CircuitBreaker437/HCS12_Robot/Doc/Project Functional Specification/Jan16/Project Functional Specification_Rev1_2015-01-16_MarcinCzajkowski.docx

Document Title Project Functional Specification

Revision 1

Date Issued January 16, 2015

Date Effective January 16, 2015

Department School of Engineering and Information Technology

Program Electronic Systems Engineering

Audience ESE Semester 4 Faculty

Author Marcin Czajkowski, Student

Reviewers Mike Jarabek, Professor

Peter Roeser, Professor

Bill Stefanuk, Professor

Revision History

Revision | Description of Change | Effective Date
1 | New Document Release | Jan. 16, 2015

# 1. Introduction:

As part of the semester for year 2 for studies in Electronic Systems Engineering it is required to implement a project that will give students the opportunity to study and apply design principles for the creation of embedded systems hardware and software.

Additional tasks that a student will be learning through implementation of the project are:

- Populate and test PCB boards
- Design and simulate test diagnostic systems
- Use schematic capture as well as read specification of parts/systems vendors
- Create PCB manufacturing data
- Create a detailed documentation regarding project specifications and scheduling of the project

# 2. Scope of the Document:

The scope of the Project Functional Specification document is to present hardware specifications needed to implement the HCS12 embedded PCB. This document will be subjected to numerous revisions as the project progresses and the aspects of the project are added through the semester. This document shall include:

- List of related documents supporting the project
- Cost targets of the components and services needed to finish the project
- Configuration options of the embedded system
- Detailed specification such as:
  - Performance
  - Port usage
  - Communication options
  - External cabling details
  - Physical size and physical constraints
  - Power requirements
- Regulatory requirements
- Reliability and service

# 3. Chapter I – List of Related Documents

## 3.1. Purpose:

The purpose of this chapter is to attach documentation related to the project. The documentation will be attached as links. Some documents might require special access permissions to be viewed. Contact document author if issues persist.

Author: Marcin Czajkowski

Email: mczajkowski@conestogac.on.ca

## 3.2. Documents list:

# | Document tile | Revision | Document purpose | Link

1 | LM22675 Specs | L | To present specifications of LM22675 | link (http://www.ti.com/product/lm22675)
2 | Project Charter | 2.7 | To present project IV requirements | link (https://conestoga.desire2learn.com/d2l/le/content/70973/viewContent/1442104/View)
3 | Notes For Design Verification | 5.0 | MCU pin specifications | link (https://conestoga.desire2learn.com/d2l/le/content/70973/viewContent/1442121/View)
4 | Port Mapping | 6 | Port mapping and pin outs of the MCU | link (https://conestoga.desire2learn.com/d2l/le/content/70973/viewContent/1442116/View)
5 | PCB tolerances and design requirements | N/A | PCB design and tolerances | link (https://conestoga.desire2learn.com/d2l/le/content/70973/viewContent/1442114/View)
6 | DC motor encoder connections | N/A | Pin out of the DC motor connector | link (https://conestoga.desire2learn.com/d2l/le/content/70973/viewContent/1442115/View)
7 | Board outline | 8 | PCB outline and connector placements | link (https://conestoga.desire2learn.com/d2l/le/content/70973/viewContent/1442117/View)
8 | Camera conx pinout | 2 | Camera connection pin out | link (https://conestoga.desire2learn.com/d2l/le/content/70973/viewContent/1442118/View)
9 | Motor encoder | N/A | Motor speed feedback diagram | link (https://conestoga.desire2learn.com/d2l/le/content/70973/viewContent/1442120/View)
10 | MAX3232 | 7 | MAX3232 Data Sheet | link (http://datasheets.maximintegrated.com/en/ds/MAX3222-MAX3241.pdf)
11 | Altium Resource/Documentation | N/A | Webpage for Altium Designer support | link (http://techdocs.altium.com/)
12 | Absolute Maximum Ratings for Soldering SNOA549C | N/A | Soldering ratings for National Semiconductors | link (http://www.ti.com/lit/an/snoa549c/snoa549c.pdf)

# 4. Chapter II – Cost Target

## 4.1. Purpose:

The purpose of the Cost Target chapter is to track the expenses of the parts and services required to finish the project. This chapter will keep an updated BOM as well as any quotes obtained from the vendors.

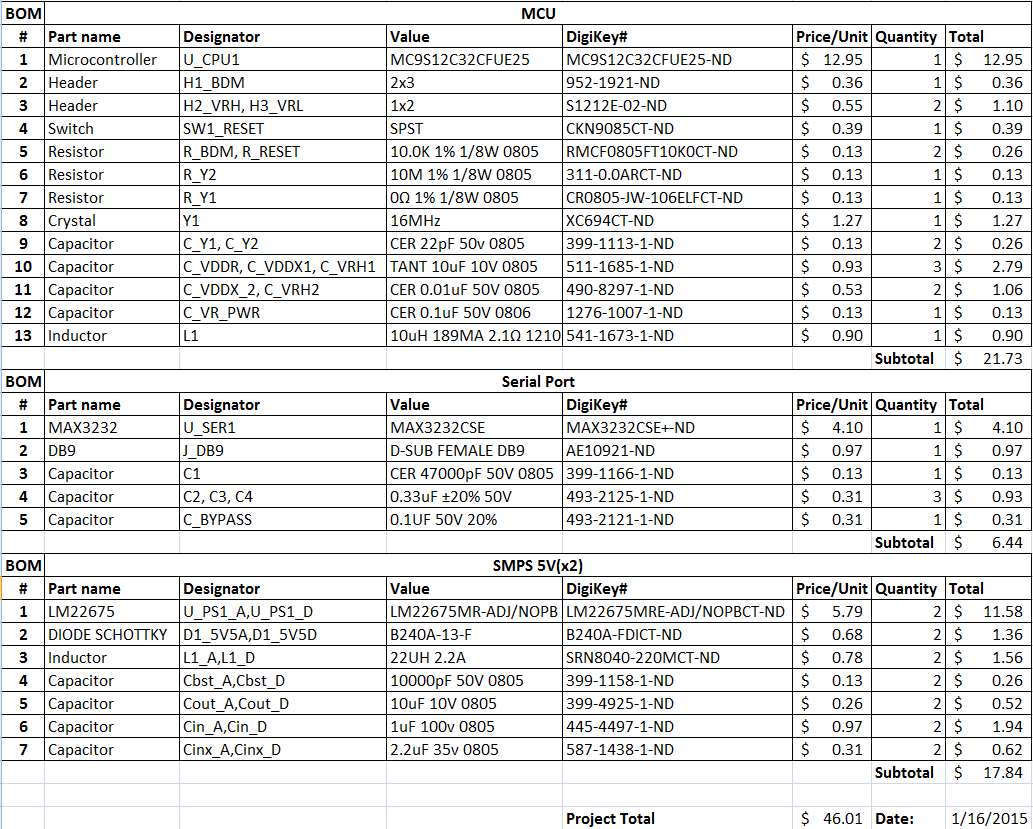
[picture p14: figure]

## 4.2. BOM

## 4.3. Total cost target

Currently the cost target of the finished product is approximately $200. The above estimate presents only the current known parts that must be acquired.

# 5. Chapter III - Specifications and Performance

## 5.1. Purpose:

The purpose of this chapter is to present detailed hardware and software specifications regarding configurations, ports usage, cabling details and system communications.

## 5.2. Hardware Specifications:

### Ports:

- RS232

The serial communication between the MCU and the peripherals will be implemented through MAX3232 IC. The MAX IC will be connected to Port S on MCU (refer to document 4 in 3.2 Documents List for pin out of Port S on MCU)

- BDM connector will be used for programming of the embedded system
- MCU port T will be used for stepper motor coil RC Servo and Encoder. Port P will serve as PWM module (refer to document 4 in 3.2 Documents List for MCU port pin outs)
- Port A on the MCU will serve as LCD connection (refer to document 4 in 3.2 Documents List for MCU port pin outs)
- Other ports TBD

### Communication and cabling:

- TBD

### Hardware configuration:

- TBD

### Physical Constraints:

- Refer to refer to document 5 and 7 in 3.2 Documents List for the board physical constraints and layout options. Further details TBD
- Constraints regarding component placement – TBD

### PCB Design

- MCU connections

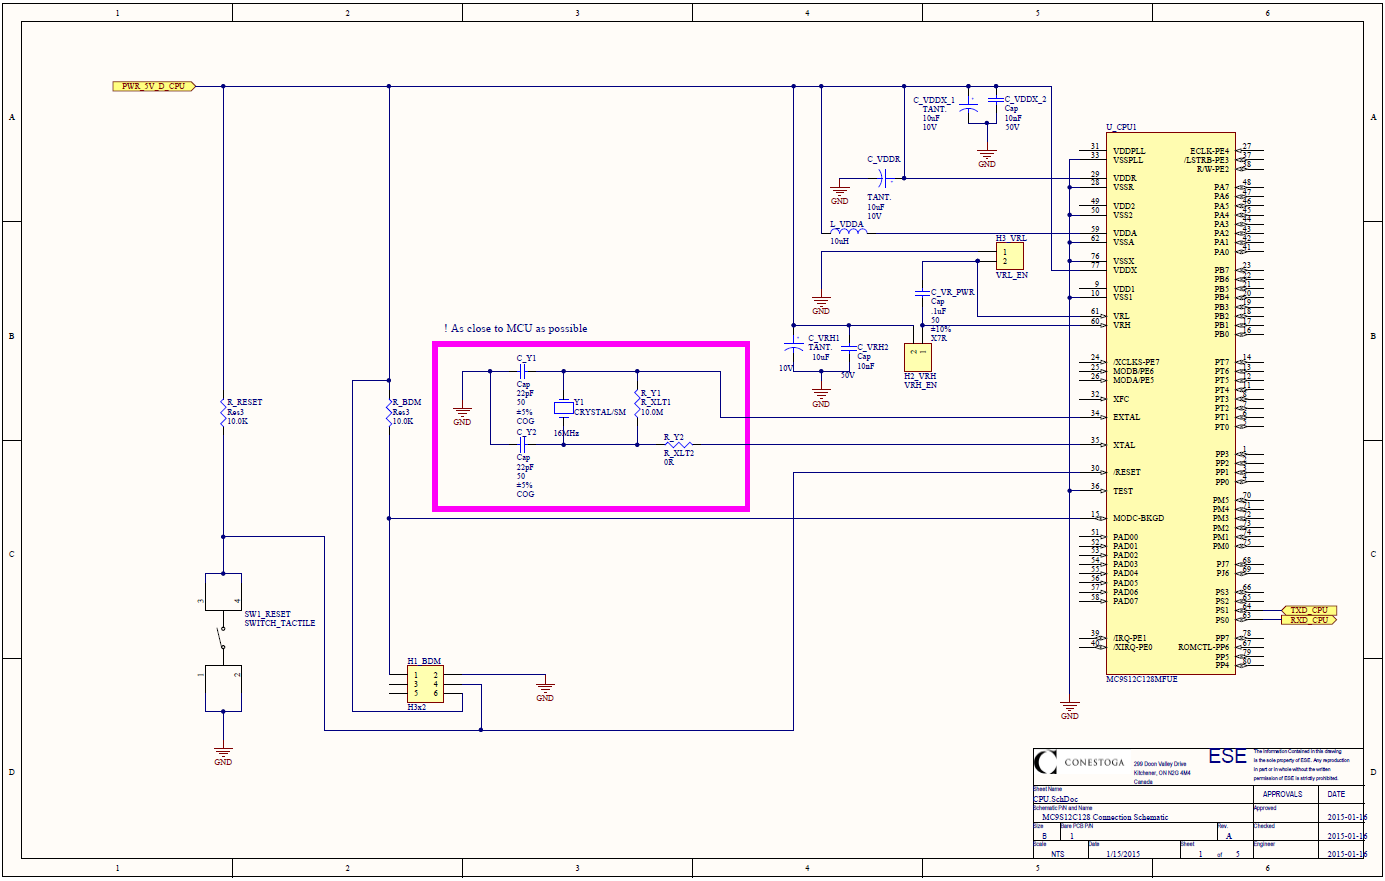
[picture p15: figure]

- SMPS 5V power supply
- RS3232 connections


- Hierarchical design

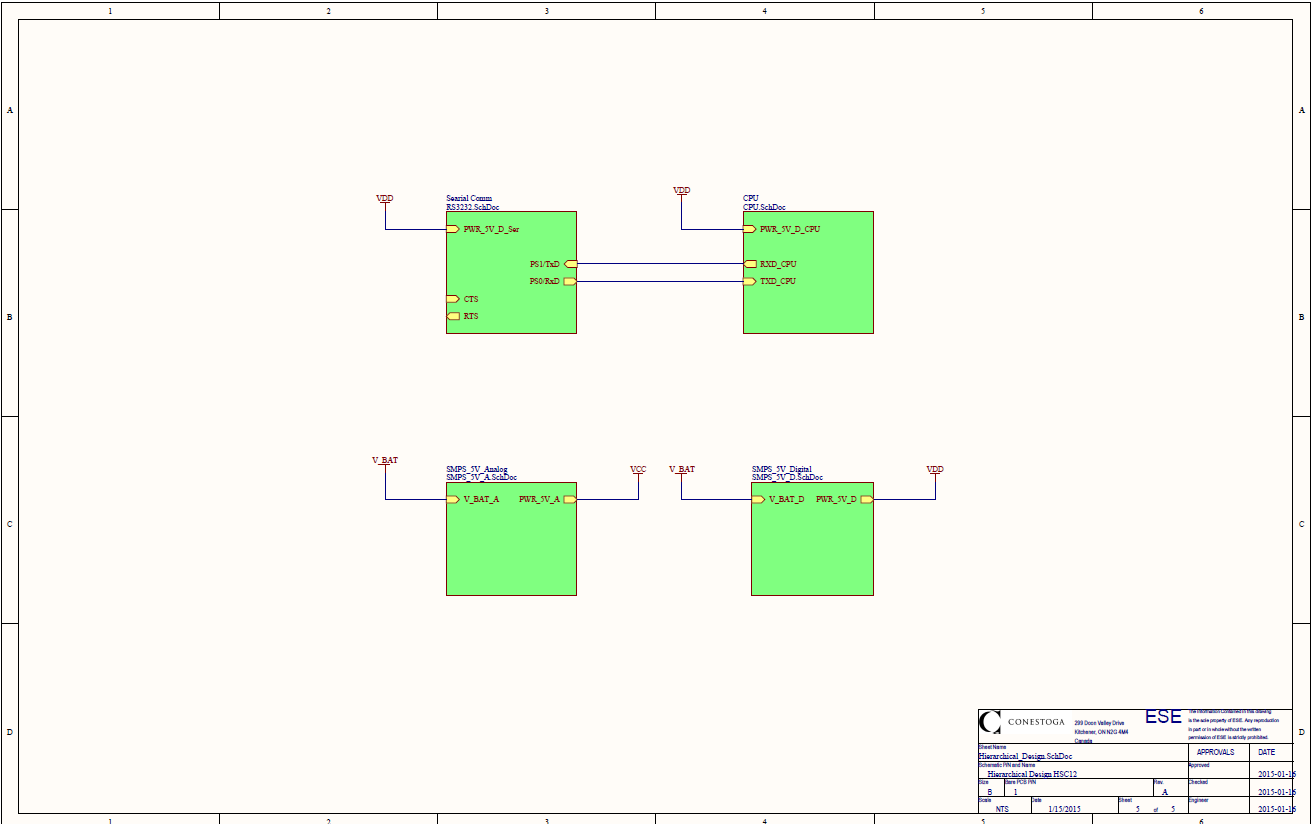
[picture p16: figure]

### Power requirements

- Power supplies requirements:
    - Two 5V SMPS and one linear 3.3V power supplies are required
- Maximum power consumption per chipset – TBD and tested (it varies on configuration)

## 5.3. Software Specifications

### Programming environment

- The programming development environment for the HSC12 will be Code Warrior suite (refer to document 11 in 3.2 Documents List for software documentation)
- Other software specifications TBD

# 6. Chapter IV – Regulatory Requirements

## 6.1. Purpose:

The purpose of this chapter is track regulatory requirements that shall be kept during the design phase.

## 6.2. ESD Requirements

- Design for LM22675 require to comply with JEDEC document JEP155 500-V HBM
- Other requirements TBD

## 6.3. Soldering Requirements

- Refer to document 12 in 3.2 Documents List for National Semiconductor products soldering specs
- IPC standard that will be applied for this project - TBD

Hardware Functional Specification – Revision 1 Page 8 of 8
