CircuitBreaker437/HCS12_Robot/Doc/MCU Ports Assignment/port_mapping_rev_6.pdf

### ITCT Embedded Controller Design (ECD) Project

HCS12 Port Mapping – Revision 6 | Page 1 of 2

Date: Feb. 4/11
Author: Al Jeffrey
Module | Port | MODE | Pin
Port T • Stepper Motor Coil Pair 2 In • Stepper Motor Coil Pair 2 Out • Stepper Motor Coil Pair 1 In • Stepper Motor Coil Pair 1 Out Port T Timer Module • RC Servo 2 Out • RC Servo 1 Out • DC Motor Encoder 2 In • DC Motor Encoder 1 In | PT7 PT6 PT5 PT4 PT3 PT2 PT1 PT0 | GPIO OUT GPIO OUT GPIO OUT GPIO OUT Timer Out Timer Out Input Capture Input Capture | 14 13 12 11 8 7 6 5
Port S • LED 2 (Green) • LED 1 (Green) Port S Serial Communications Interface (SCI) • SCI Transmit • SCI Receive | PS3 PS2 PS1 PS0 | GPIO Out GPIO Out SCI TX SCI RX | 66 65 64 63
Port M Serial Peripheral Interface (SPI) • SCK • MOSI • N_SS • MISO Port M • CAN_TX • CAN_RX | PM5 PM4 PM3 PM2 PM1 PM0 | SPI SCK SPI MOSI SPI N_SS SPI MISO GPIO Reserved GPIO Reserved | 70 71 72 73 74 75
Port J Serial Peripheral Interface (SPI) • SPI_CS2 • SPI_CS1 | PJ6 PJ7 | GPIO Out GPIO Out | 69 68
Port P • Keypad wake • ROMCTL (Pull up with 10K and connect to header pin for GPIO) Port P PWM Module • DC Motor 2 PWM • DC Motor 1 PWM Port P • Unused • Unused • Unused • Unused | PP7 PP6 PP5 PP4 PP3 PP2 PP1 PP0 | GPIO Reserved ROMCTL In PWM Out PWM Out GPIO Unused GPIO Unused GPIO Unused GPIO Unused | 78 67 79 80 1 2 3 4
Port AD • Stepper Switch Right • Stepper Switch Left • Unused/Keyboard scan 5 • Unused/Keyboard scan 4 • Analog Input 3/Keyboard scan 3 • Analog Input 2 • Analog Input 1 • Analog Input 0 | PAD7 PAD6 PAD5 PAD4 PAD3 PAD2 PAD1 PAD0 | GPIO IN GPIO IN GPIO Reserved GPIO Reserved Analog In/GPIO Analog In Analog In Analog In | 58 57 56 55 54 53 52 51

### ITCT Embedded Controller Design (ECD) Project

HCS12 Port Mapping – Revision 6 | Page 2 of 2
Port A • Unused • LCD_RW • LCD_RS • LCD_E • LCD Data I/O 3 • LCD Data I/O 2 • LCD Data I/O 1 • LCD Data I/O 0 | PA7 PA6 PA5 PA4 PA3 PA2 PA1 PA0 | GPIO Unused GPIO Out GPIO Out GPIO Out GPIO I/O GPIO I/O GPIO I/O GPIO I/O | 48 47 46 45 44 43 42 41
Port B • Unused • Unused • Unused • Unused • DC Motor 2 Direction B • DC Motor 2 Direction A • DC Motor 1 Direction B • DC Motor 1 Direction A | PB7 PB6 PB5 PB4 PB3 PB2 PB1 PB0 | GPIO Unused GPIO Unused GPIO Unused GPIO Unused GPIO Out GPIO Out GPIO Out GPIO Out | 23 22 21 20 19 18 17 16
