CircuitBreaker437/HCS12_Robot/Doc/Project progress/Project_Progress_Report.gif

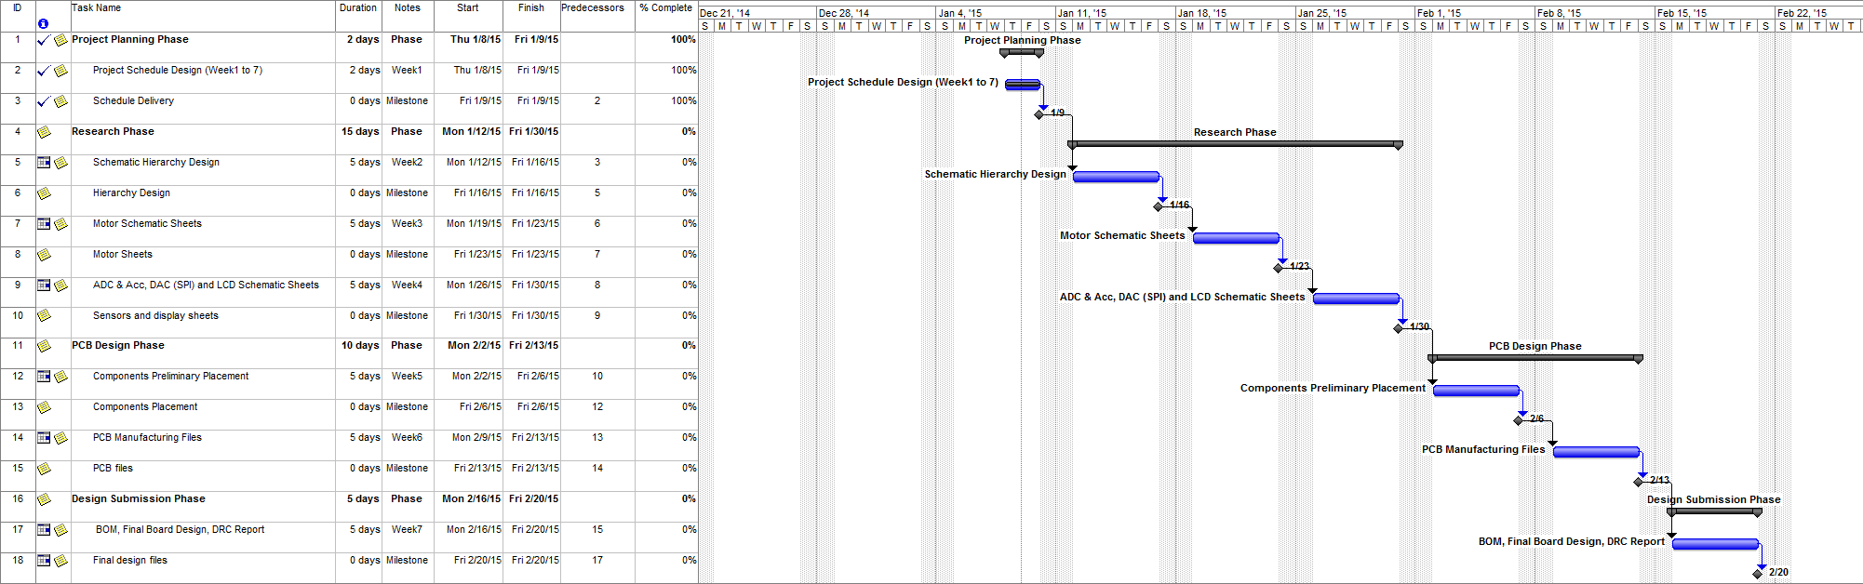
Doc/Project progress/Project_Progress_Report.gif
