CircuitBreaker437/HCS12_Robot/PCB/Project Outputs for PCB/PCB.xlsx

Comment | Description | Designator | Footprint | LibRef | Quantity
Cap | CAP CER 47000pF 50v X7R 0805, CAP CER 1000pF 50v COG 0805, CAP CER 1000pF 50v COG 0805, Capacitor, CAP CER .1uF 16v X7R 0805, Capacitor, CAP CER 22pF 50v COG 0805, CAP CER 22pF 50v COG 0805, CAP CER 1uF 35v X7R 0805, CAP CER 1uF 35v X7R 0805 | C1, C_Bst_A, C_Bst_D, C_VDDX_2, C_VR_PWR, C_VRH2, C_Y1, C_Y2, Cinx_A, Cinx_D | CAPC2012X09M | CAP-X7R-47000pF-50V-±10%, CAP-COG-1000pF-50V-±5%, CAP-COG-1000pF-50V-±5%, Cap, CAP-X7R-.1uF-16V-±10%, Cap, CAP-COG-22pF-50V-±5%, CAP-COG-22pF-50V-±5%, CAP-X7R-1uF-16V-±10%, CAP-X7R-1uF-16V-±10% | 10
Cap Pol | CAP 85C 0.33uF ±20% 50V WX Series Aluminum Electrolytic, CAP 85C 0.33uF ±20% 50V WX Series Aluminum Electrolytic, CAP 85C 0.33uF ±20% 50V WX Series Aluminum Electrolytic, CAP 85C 0.1uF ±20% 50V WX Series Aluminum Electrolytic | C2, C3, C4, C_BYPASS | CAPACITOR_3MM | Cap Polar-0.33uF-50V, Cap Polar-0.33uF-50V, Cap Polar-0.33uF-50V, Cap Polar-0.1uF-50V | 4
Cap | CAP CER 2.2uF 100v X7R 1210, CAP CER 2.2uF 100v X7R 1210, CAP CER 33uF 10v X5R 1210, CAP CER 33uF 10v X5R 1210 | Cin_A, Cin_D, Cout_A, Cout_D | C1210 | CAP-X7R-2.2uF-16V-±10%, CAP-X7R-2.2uF-16V-±10%, CAP-X5R-22uF-6.3V-±20%, CAP-X5R-22uF-6.3V-±20% | 4
TANT. |  | C_VDDR, C_VDDX_1, C_VRH1 |  | CAPACITOR POL | 3
DIODE SCHOTTKY 40V 2A SMA | Schottky Rectifier | D1_5V5A, D1_5V5D | DIOM4326X23M | DIODE SCHOTTKY 40V 2A SMA | 2
H3x2 | Header, 3-Pin, Dual row | H1_BDM | HDR2X3 | Header 3X2 | 1
VRH_EN | Header, 2-Pin | H2_VRH | HDR1X2 | Header 2 | 1
VRL_EN | Header, 2-Pin | H2_VRL | HDR1X2 | Header 2 | 1
D Connector 9 | Receptacle Assembly, 9 Position, Right Angle | J_DB9 | DSUB1.385-2H9 | D Connector 9 | 1
SRN8040 | FIXED IND 22UH 2.2A 100 MOHM SMD | L1_A, L1_D | INDP8080X40M | SRN8040 | 2
10uH |  | L_VDDA |  | INDUCTOR | 1
Res3 | RES SMD 10.0K OHM 1% 1/8W 0805, RES SMD 10.0K OHM 1% 1/8W 0805, RES SMD 10.0M OHM 1% 1/8W 0805, RES SMD 0 OHM 1% 1/8W 0805 | R_BDM, R_RESET, R_Y1, R_Y2 | RESC2112X05M | Resistor_10.0K, Resistor_10.0K, Resistor_10.0K, Resistor_1.02R | 4
SWITCH_TACTILE | SWITCH TACTILE SPST-NO 0.05A 12V | S_RES1 |  | SWITCH_TACTILE | 1
MC9S12C128MFUE | IC MCU 16BIT 128KB FLASH 80QFP | U_CPU1 | QUAD.65M/80/WG17.45-HCS12 | MC9S12C128MFUE | 1
LM22675MR-ADJ/NOPB | 1A SIMPLE SWITCHER®, Step-Down Voltage Regulator with Precision Enable, 8-pin PSOP, Pb-Free | U_PS1_A, U_PS1_D | MRA08B_L | LM22675MR-ADJ/NOPB | 2
MAX3232CSE | 3.0V TO 5.5V, Low-Power, up to 1Mbps, True RS-232 Transceiver Using Four 0.1µF External Capacitor | U_SER1 | NSO16_N | MAX3232CSE | 1
CRYSTAL/SM | 16MHz | Y1 |  | CRYSTAL/SM | 1
