CircuitBreaker437/HCS12_Robot/Doc/Project progress/Project_Progress_Report.pdf

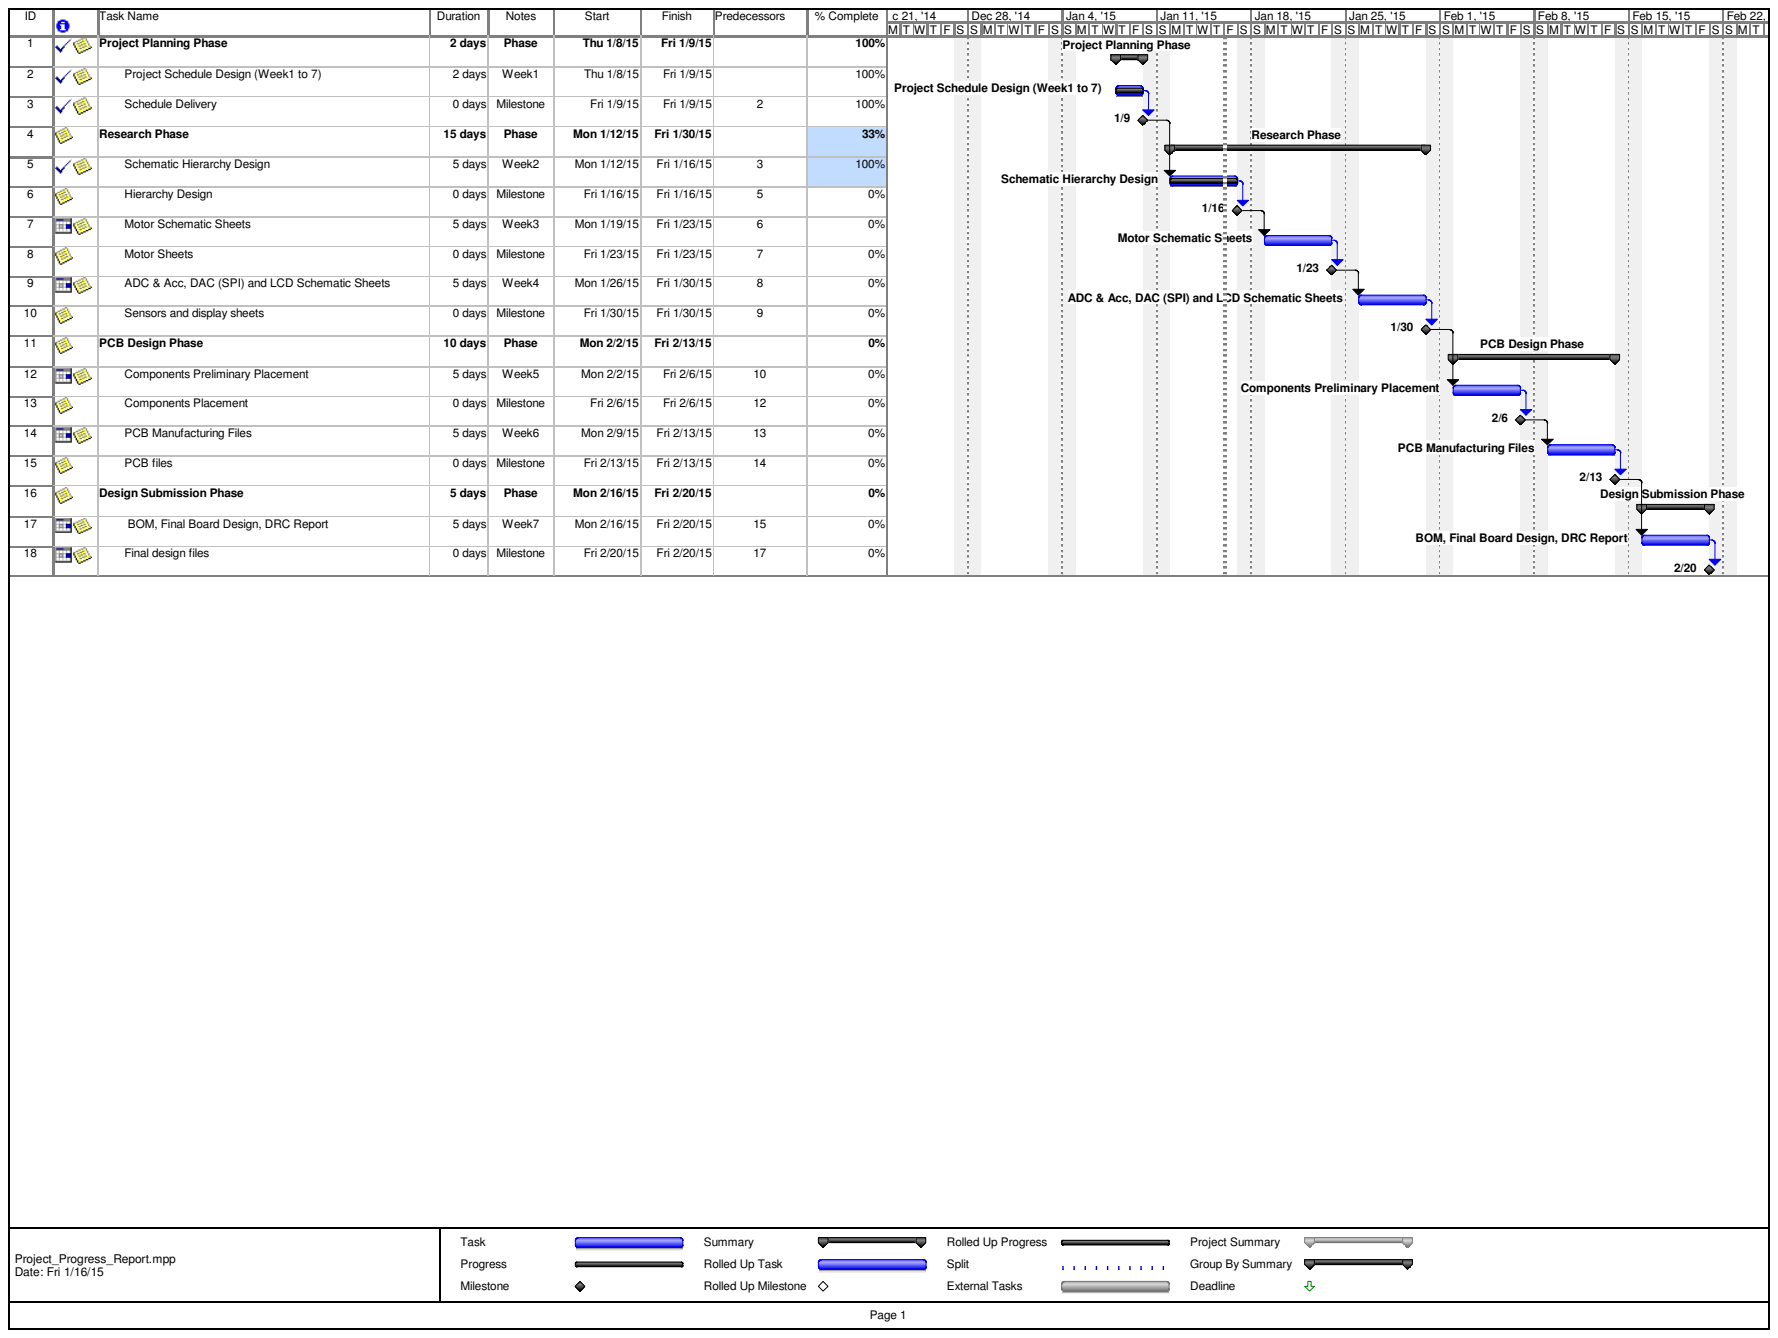
[picture p29: page 1]
Task; Progress; Milestone; Summary; Split; External Tasks; Project Summary; Deadline; Project_Progress_Report.mpp Date: Fri 1/16/15

ID | | Task Name | Duration | Notes | Start | Finish | Predecessors | % Complete | c 21, '14 | Dec 28, '14 | Jan 4, '15 | Jan 11, '15 | Jan 18, '15 | Jan 25, '15 | Feb 1, '15 | Feb 8, '15 | Feb 15, '15 | Feb 22,

1 | | Project Planning Phase | 2 days | Phase | Thu 1/8/15 | Fri 1/9/15 | | 100% | | | Project Planning Phase | | | Research Phase

2 | Project Schedule Design (Week1 to 7) | 2 days | Week1 | Thu 1/8/15 | Fri 1/9/15 | | 100%

Project Schedule Design (Week1 to 7)

3 | Schedule Delivery | 0 days | Milestone | Fri 1/9/15 | Fri 1/9/15 | 2 | 100%

4 | Research Phase | 15 days | Phase | Mon 1/12/15 | Fri 1/30/15 | | 33%

5 | Schematic Hierarchy Design | 5 days | Week2 | Mon 1/12/15 | Fri 1/16/15 | 3 | 100%

Schematic Hierarchy Design

6 | Hierarchy Design | 0 days | Milestone | Fri 1/16/15 | Fri 1/16/15 | 5 | 0% | Motor Schematic Sheets ADC & Acc, DAC (SPI) and LCD Schematic Sheets | 1/16

7 | Motor Schematic Sheets | 5 days | Week3 | Mon 1/19/15 | Fri 1/23/15 | 6 | 0%

8 | Motor Sheets | 0 days | Milestone | Fri 1/23/15 | Fri 1/23/15 | 7 | 0% | | | 1/23

9 | ADC & Acc, DAC (SPI) and LCD Schematic Sheets | 5 days | Week4 | Mon 1/26/15 | Fri 1/30/15 | 8 | 0%

10 | Sensors and display sheets | 0 days | Milestone | Fri 1/30/15 | Fri 1/30/15 | 9 | 0% | | | | 1/30

11 | PCB Design Phase | 10 days | Phase | Mon 2/2/15 | Fri 2/13/15 | | 0%

PCB Design Phase

12 | Components Preliminary Placement | 5 days | Week5 | Mon 2/2/15 | Fri 2/6/15 | 10 | 0%

13 | Components Placement | 0 days | Milestone | Fri 2/6/15 | Fri 2/6/15 | 12 | 0% | | | | PCB Manufacturing Files BOM, Final Board Design, DRC Report | 2/6

Components Preliminary Placement

14 | PCB Manufacturing Files | 5 days | Week6 | Mon 2/9/15 | Fri 2/13/15 | 13 | 0%

15 | PCB files | 0 days | Milestone | Fri 2/13/15 | Fri 2/13/15 | 14 | 0% | | | | | | 2/13

16 | Design Submission Phase | 5 days | Phase | Mon 2/16/15 | Fri 2/20/15 | | 0%

Design Submission Phase

17 | BOM, Final Board Design, DRC Report | 5 days | Week7 | Mon 2/16/15 | Fri 2/20/15 | 15 | 0%

18 | Final design files | 0 days | Milestone | Fri 2/20/15 | Fri 2/20/15 | 17 | 0% | | | | | | | 2/20

Rolled Up Progress

Rolled Up Task

Group By Summary

Rolled Up Milestone
