CircuitBreaker437/HCS12_Robot/Schematic/3VPS/webench_design_3961581_2_511627334.pdf

## WEBENCH ® Design Report

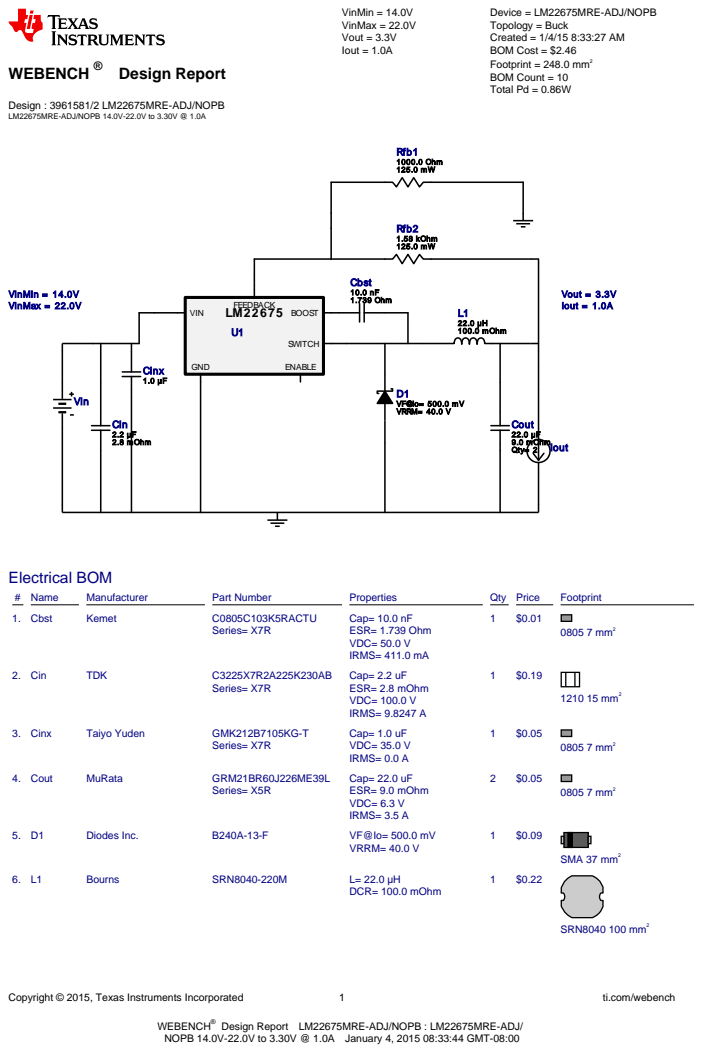
[picture p30: page 1]
Copyright © 2015, Texas Instruments Incorporated; ti.com/webench; VinMin = 14.0V VinMax = 22.0V Vout = 3.3V Iout = 1.0A; Cbst 10.0 nF 1.739 Ohm; Cin 2.2 µF 2.8 mOhm; Cinx 1.0 µF; Cout 22.0 µF 9.0 mOhm Qty= 2; D1 VF@Io= 500.0 mV VRRM= 40.0 V; L1 22.0 µH 100.0 mOhm; VIN; FEEDBACK; BOOST; SWITCH; GND; ENABLE; Vout = 3.3V Iout = 1.0A; VinMin = 14.0V VinMax = 22.0V; Rfb1 1000.0 Ohm 125.0 mW; Rfb2 1.58 kOhm 125.0 mW; Vin; Iout; Electrical BOM; # Name; Manufacturer; Part Number; Properties; Qty Price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

Device = LM22675MRE-ADJ/NOPB
Topology = Buck
Created = 1/4/15 8:33:27 AM
BOM Cost = $2.46
Footprint = 248.0 mm²
BOM Count = 10
Total Pd = 0.86W

Design : 3961581/2 LM22675MRE-ADJ/NOPB
LM22675MRE-ADJ/NOPB 14.0V-22.0V to 3.30V @ 1.0A

WEBENCH®
NOPB 14.0V-22.0V to 3.30V @ 1.0A January 4, 2015 08:33:44 GMT-08:00

Design Report LM22675MRE-ADJ/NOPB : LM22675MRE-ADJ/

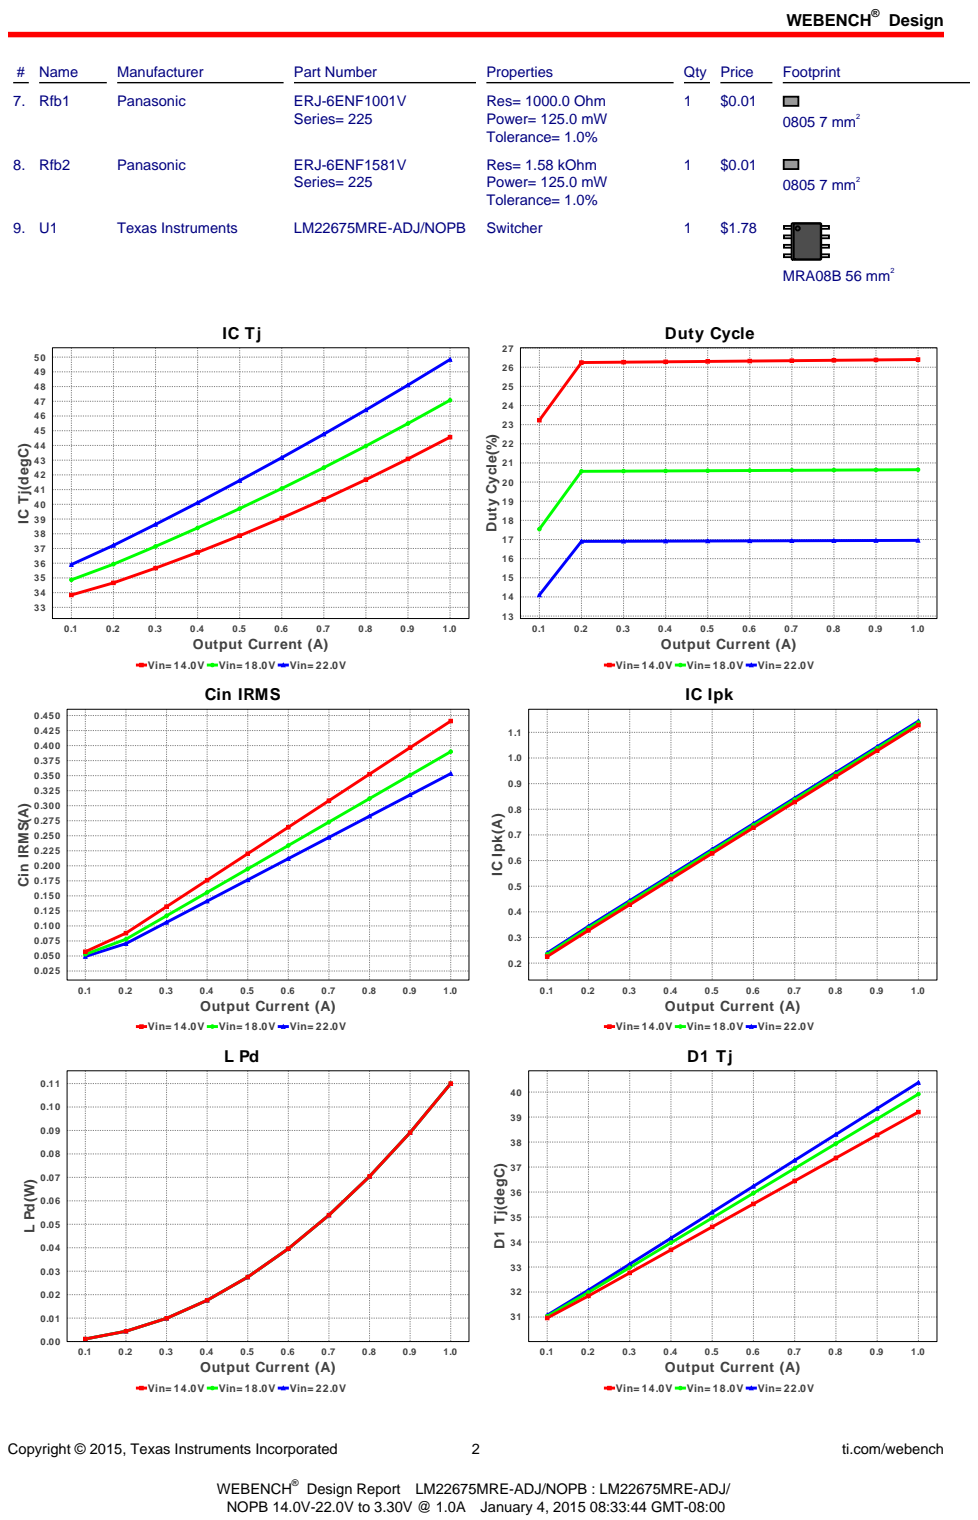
[picture p31: page 2]
Design; Copyright © 2015, Texas Instruments Incorporated; ti.com/webench; # Name; Manufacturer; Part Number; Properties; Qty Price; Footprint; 7. Rfb1; Panasonic; ERJ-6ENF1001V; Series= 225; Res= 1000.0 Ohm Power= 125.0 mW Tolerance= 1.0%; 0805 7 mm²; 8. Rfb2; ERJ-6ENF1581V; Res= 1.58 kOhm Power= 125.0 mW Tolerance= 1.0%; Texas Instruments; LM22675MRE-ADJ/NOPB Switcher; MRA08B 56 mm²; 1.0 Output Current (A); Duty Cycle; Duty Cycle(%); Cin IRMS(A); IC Ipk; IC Ipk(A); D1 Tj(degC)

IC Tj(degC)

Vin= 14.0V Vin= 18.0V Vin= 22.0V
Cin IRMS

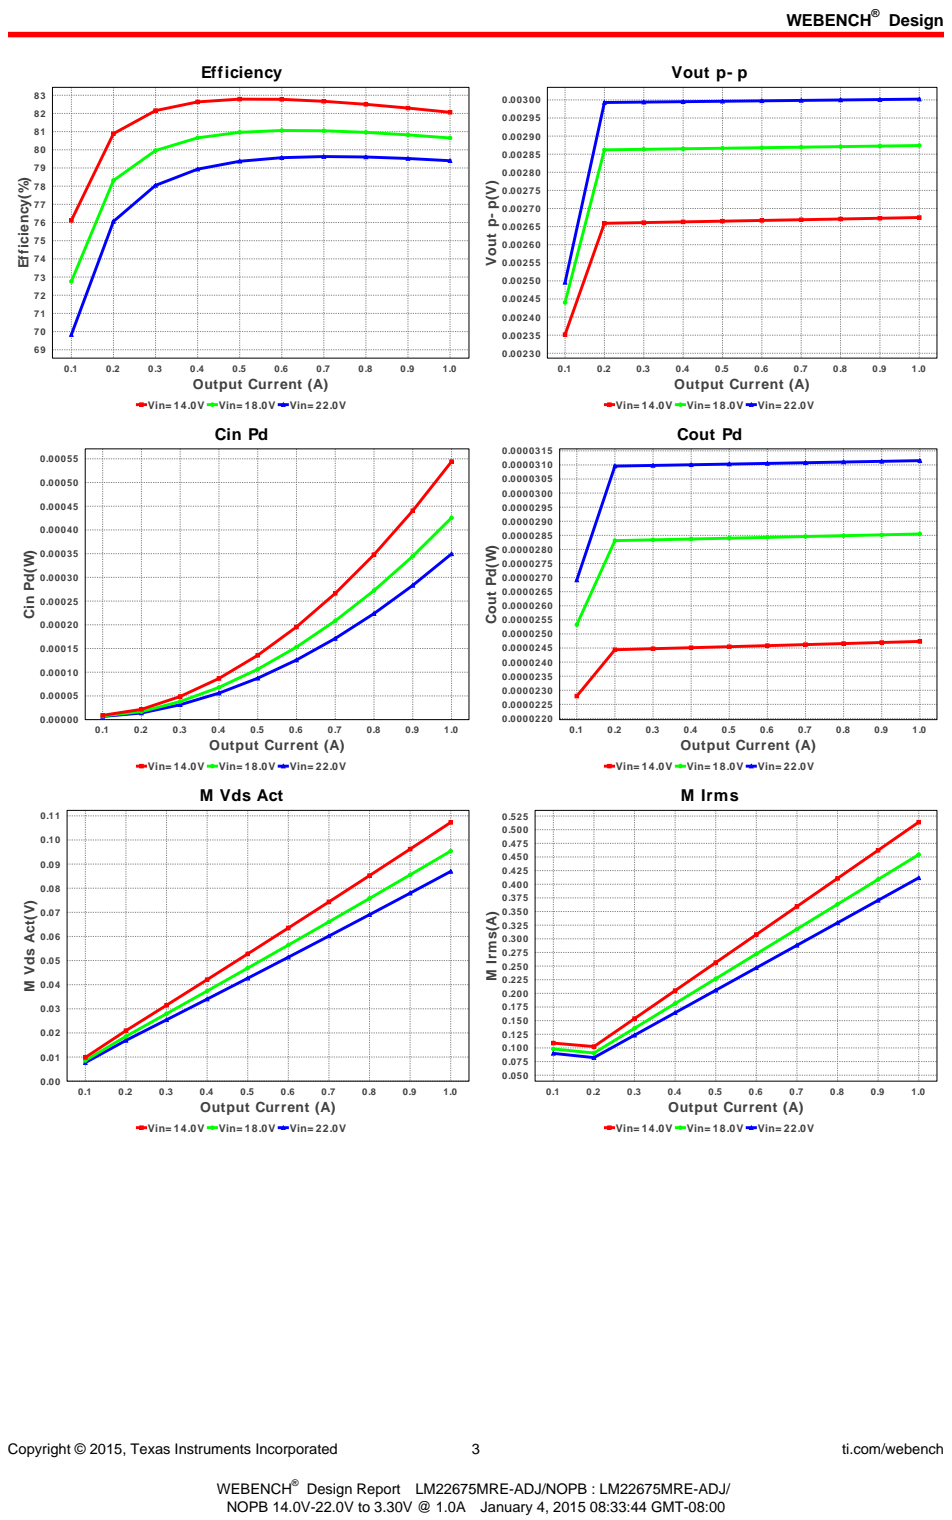
[picture p32: page 3]
Copyright © 2015, Texas Instruments Incorporated; ti.com/webench; Efficiency; 1.0 Output Current (A); Efficiency(%); Vout p- p; Vout p- p(V); Cin Pd; Cin Pd(W); Cout Pd; Cout Pd(W); M Vds Act(V); M Irms; M Irms(A)

Vin= 14.0V Vin= 18.0V Vin= 22.0V

M Vds Act

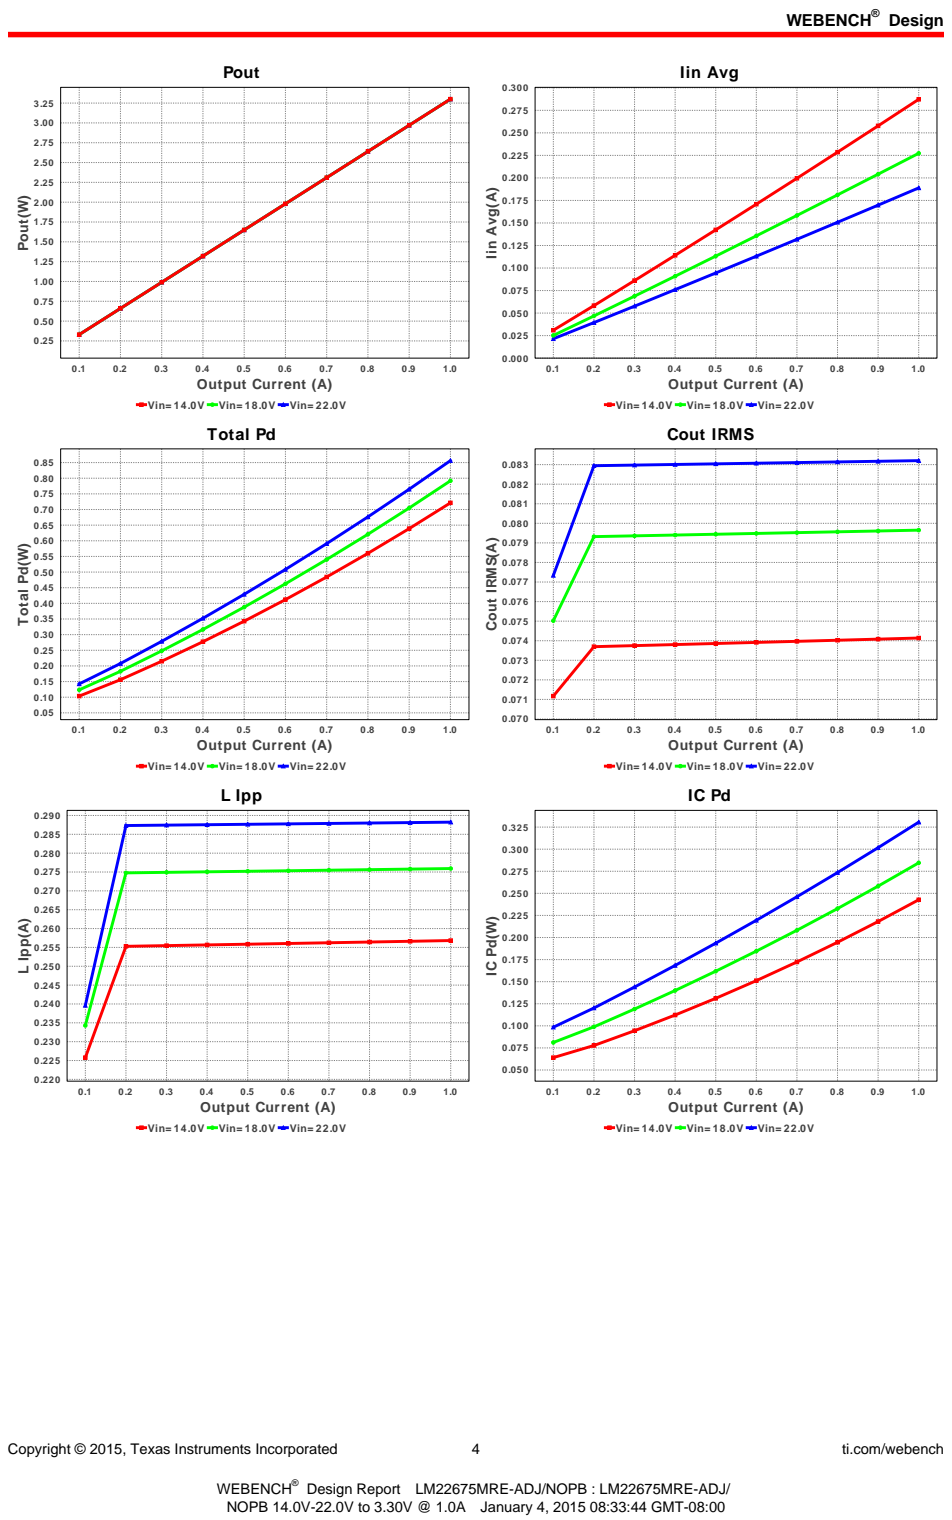
[picture p33: page 4]
Copyright © 2015, Texas Instruments Incorporated; ti.com/webench; Pout; 1.0 Output Current (A); Pout(W); Iin Avg; Iin Avg(A); Total Pd; Total Pd(W); Cout IRMS(A); L Ipp; L Ipp(A)

Vin= 14.0V Vin= 18.0V Vin= 22.0V

Cout IRMS

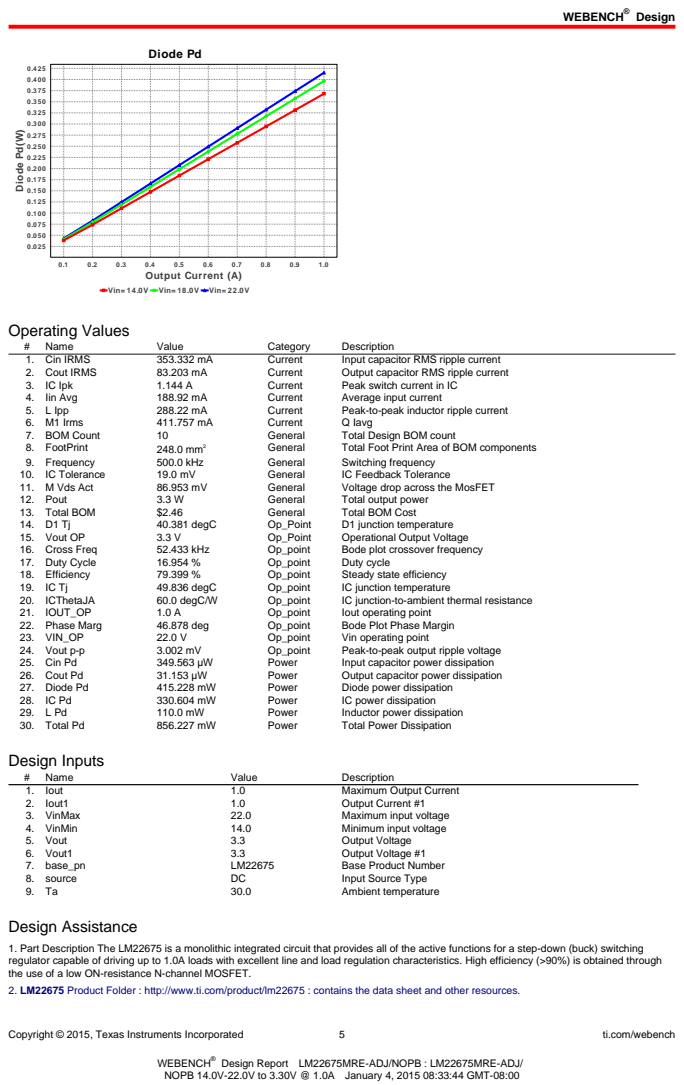
[picture p34: page 5]
Copyright © 2015, Texas Instruments Incorporated; ti.com/webench; Diode Pd; 1.0 Output Current (A); Diode Pd(W); Operating Values; Name; Value; Category; Description; 1. Cin IRMS; Current; Input capacitor RMS ripple current; 2. Cout IRMS; Output capacitor RMS ripple current; 3. IC Ipk; Peak switch current in IC; 4. Iin Avg; Average input current; 5. L Ipp; Peak-to-peak inductor ripple current; 6. M1 Irms; Q Iavg; 7. BOM Count; General; Total Design BOM count; 8. FootPrint; 248.0 mm²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

Vin= 14.0V Vin= 18.0V Vin= 22.0V

1. Part Description The LM22675 is a monolithic integrated circuit that provides all of the active functions for a step-down (buck) switching
regulator capable of driving up to 1.0A loads with excellent line and load regulation characteristics. High efficiency (>90%) is obtained through
the use of a low ON-resistance N-channel MOSFET.
2. LM22675 Product Folder : http://www.ti.com/product/lm22675 : contains the data sheet and other resources.

Copyright © 2015, Texas Instruments Incorporated | 6 | ti.com/webench

Texas Instruments' WEBENCH simulation tools attempt to recreate the performance of a substantially equivalent physical implementation
of the design. Simulations are created using Texas Instruments' published specifications as well as the published specifications of other device manufacturers. While Texas Instruments does update this information periodically, this information may not be current at the time the simulation is built. Texas Instruments does not warrant the accuracy or completeness of the specifications or any information contained therein. Texas Instruments does not warrant that any designs or recommended parts will meet the specifications you entered, will be suitable for your application or fit for any particular purpose, or will operate as shown in the simulation in a physical implementation. Texas Instruments does not warrant that the designs are production worthy.
You should completely validate and test your design implementation to confirm the system functionality for your application prior to production.
Use of Texas Instruments' WEBENCH simulation tools is subject to Texas Instruments' Site Terms and Conditions of Use. (http://www.ti.com/corp/docs/legal/termsofuse.shtml) Prototype boards based on WEBENCH created designs are provided AS IS without warranty of any kind for evaluation and testing purposes and are subject to the terms of the Evaluation License Agreement. (http://www.ti.com/corp/docs/legal/termsofuse_estore.shtml)
