CircuitBreaker437/HCS12_Robot/Schematic/Design_Rev_PDF/Feb08/PCB_Feb08.pdf

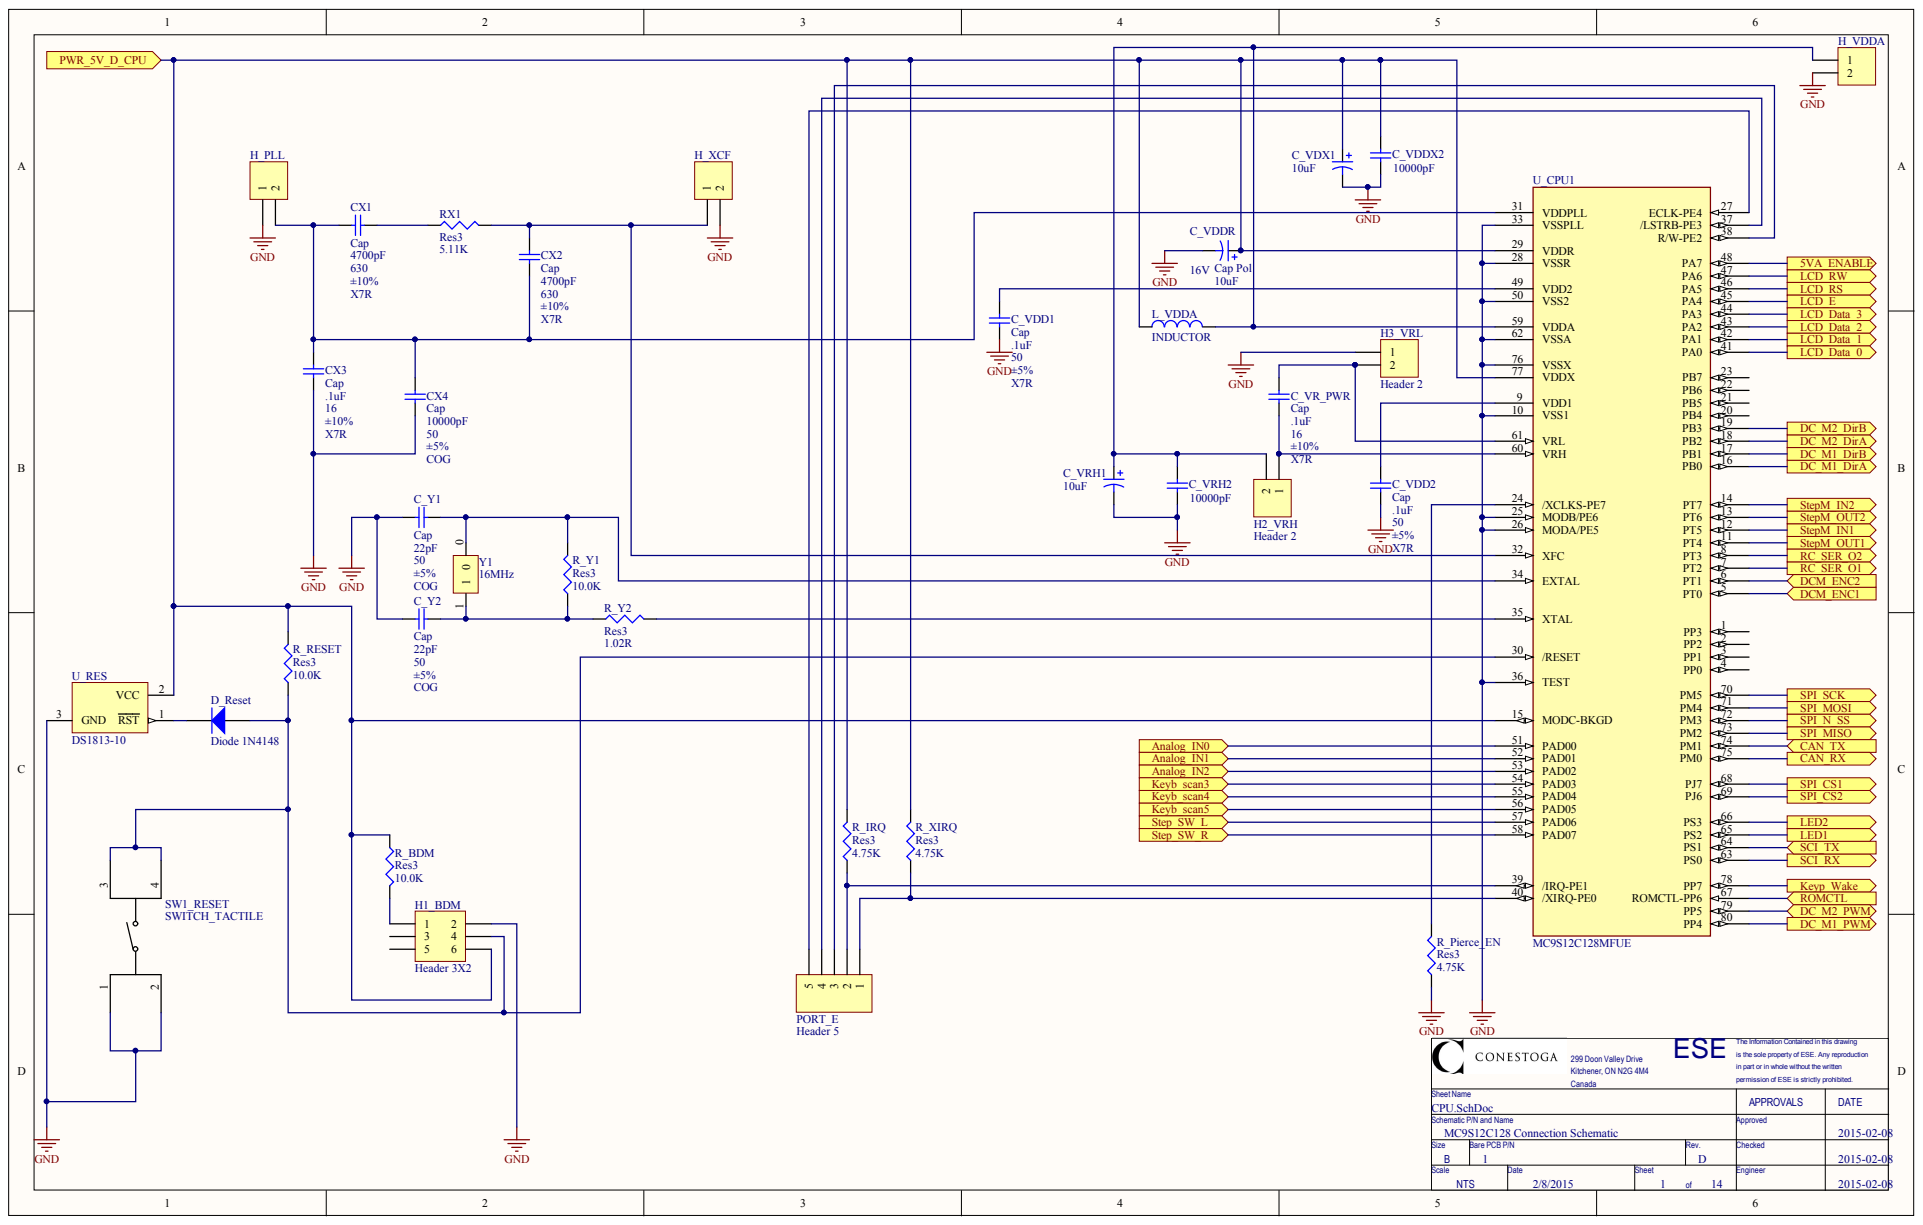
[picture p45: page 1]

of ESE. Any re

S h e e t Na m e | A P P ROVA L S | D AT E
CPU.SchDoc MC9S12C128 Connect S c h e m a t i c P /N a n d Na m e ion Schemat i c | A p pro v e d | 2015-02-08

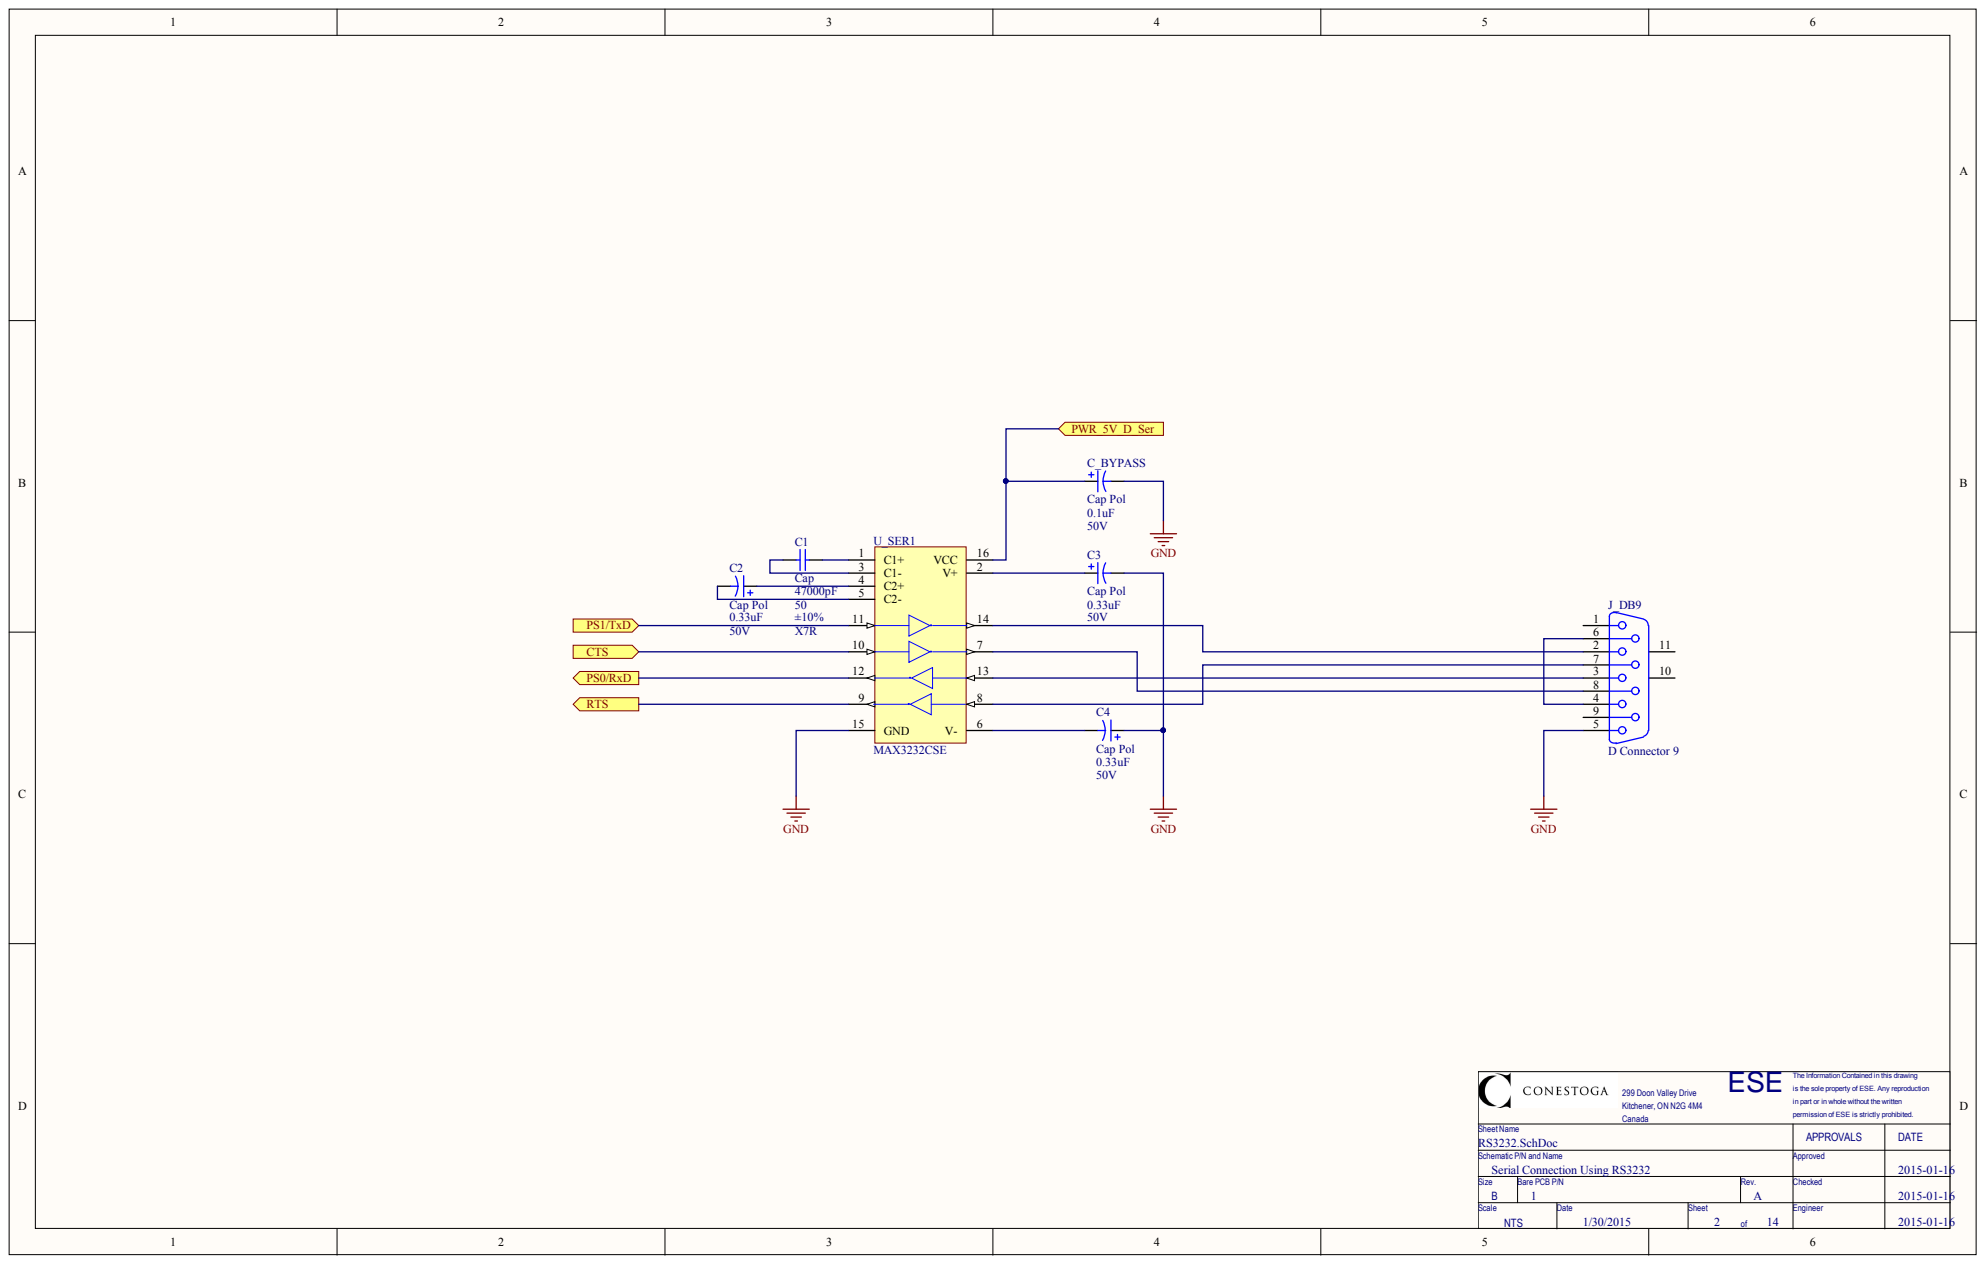
[picture p46: page 2]

of ESE. Any re

S h e e t Na m e RS3232.SchDoc | A P P ROVA L S | D AT E

S c h e m a t i c P /N a n d Na m e Ser ial Connect ion U s ing RS3232 | A p pro v e d | 2015-01-16

S i z e B | B are PCB P / N 1 | Re v . A | Ch e c k e d | 2015-01-16

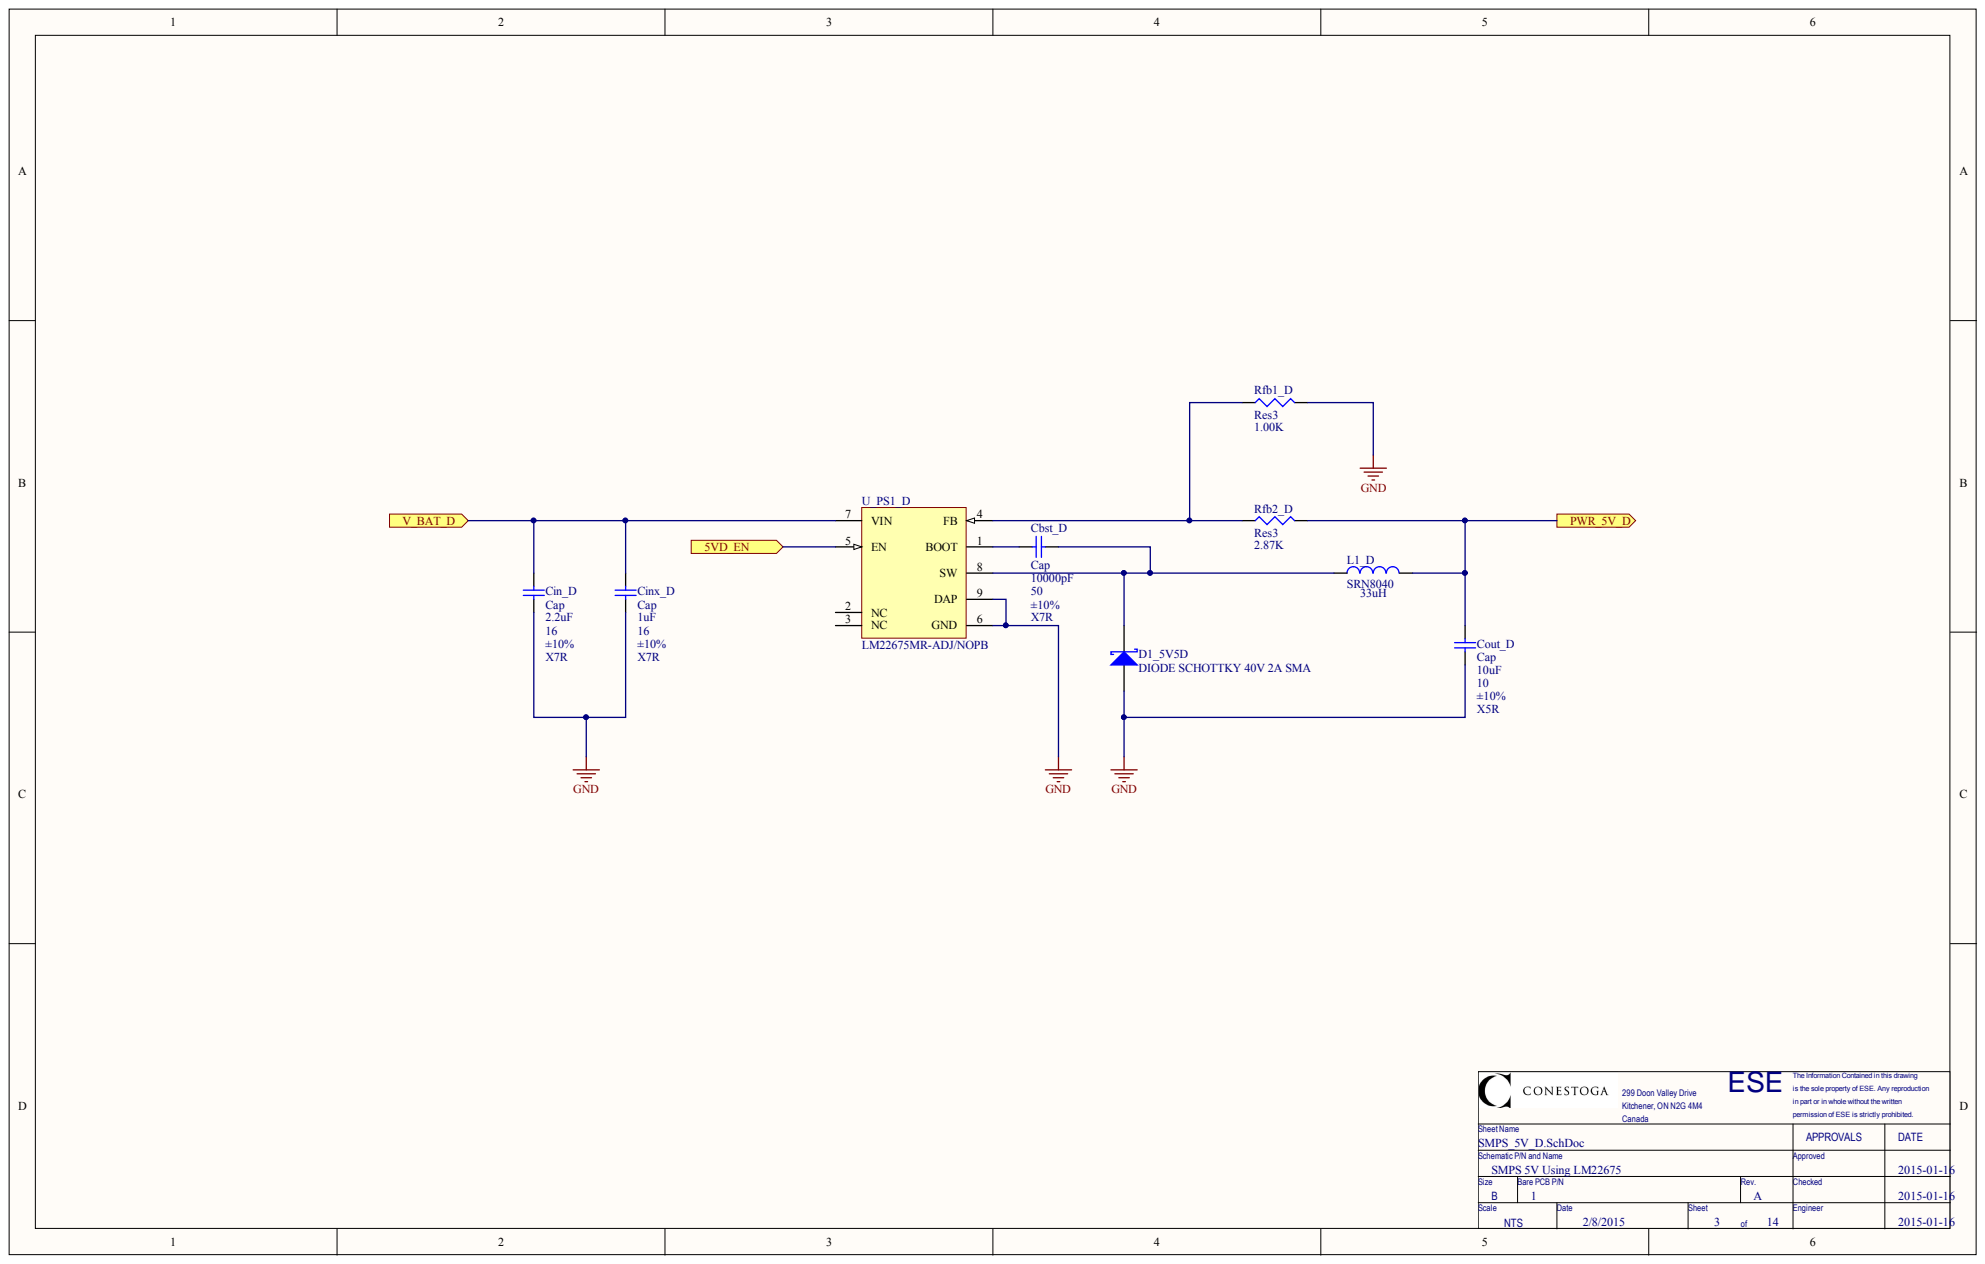
[picture p47: page 3]

ESE is the sole property of ESE. Any reproduction

The Information Contained in this drawing

in part or in whole without the written

permission of ESE is strictly prohibited.

Sheet Name SMPS_5V_D.SchDoc | APPROVALS | DATE

Schematic P/N and Name SMPS 5V Using LM22675 | Approved | 2015-01-16

Size B | Bare PCB P/N 1 | Rev. A | Checked | 2015-01-16

Scale NTS | Date 2/8/2015 | Sheet 3 of 14 | Engineer | 2015-01-16

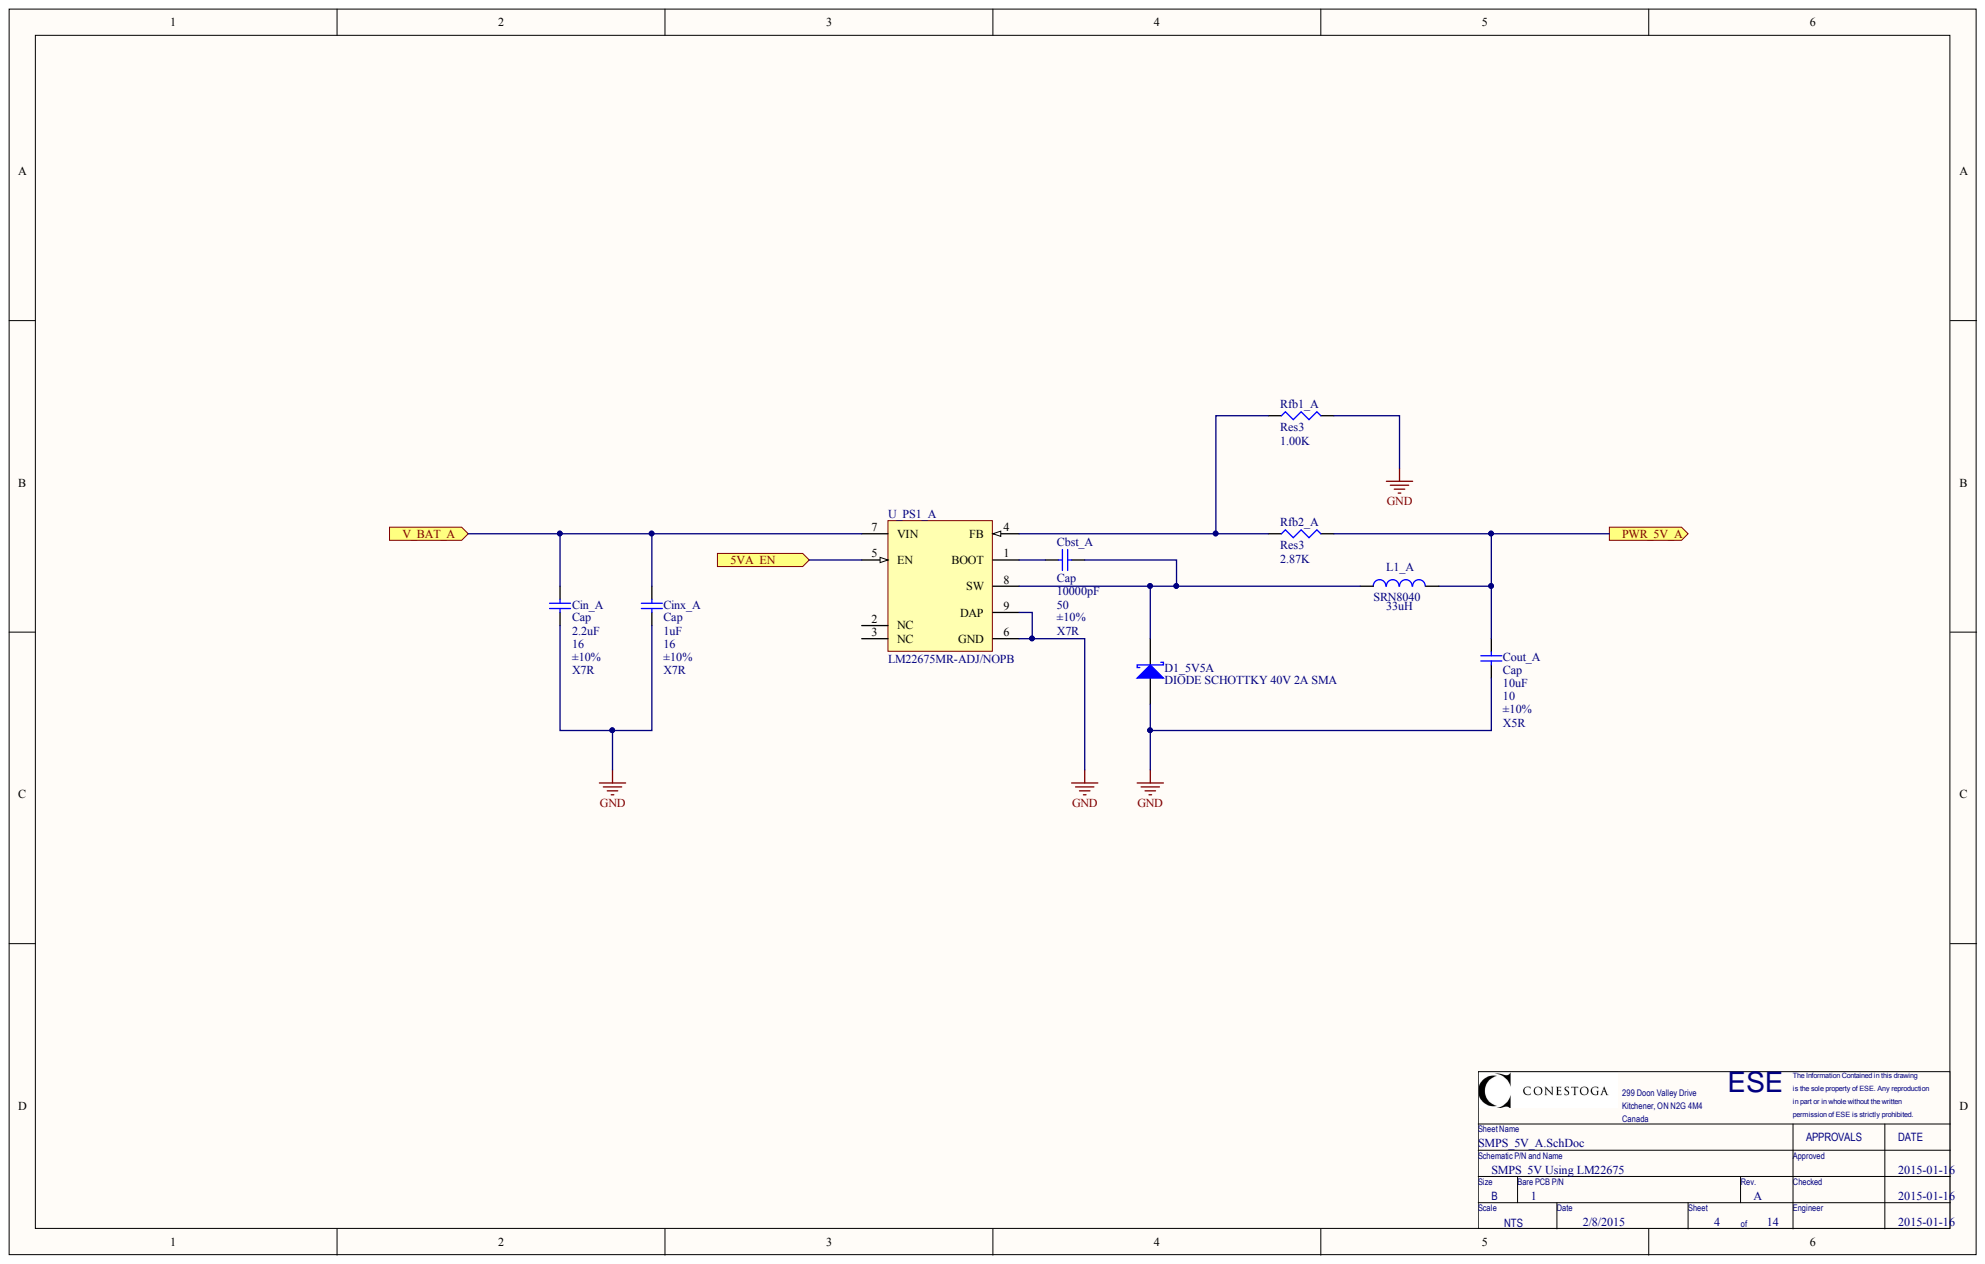
[picture p48: page 4]

ESE is the sole property of ESE. Any reproduction

The Information Contained in this drawing

in part or in whole without the written

permission of ESE is strictly prohibited.

Sheet Name SMPS_5V_A.SchDoc | APPROVALS | DATE

Schematic P/N and Name SMPS 5V Using LM22675 | Approved | 2015-01-16

Size B | Bare PCB P/N 1 | Rev. A | Checked | 2015-01-16

Scale NTS | Date 2/8/2015 | Sheet 4 of 14 | Engineer | 2015-01-16

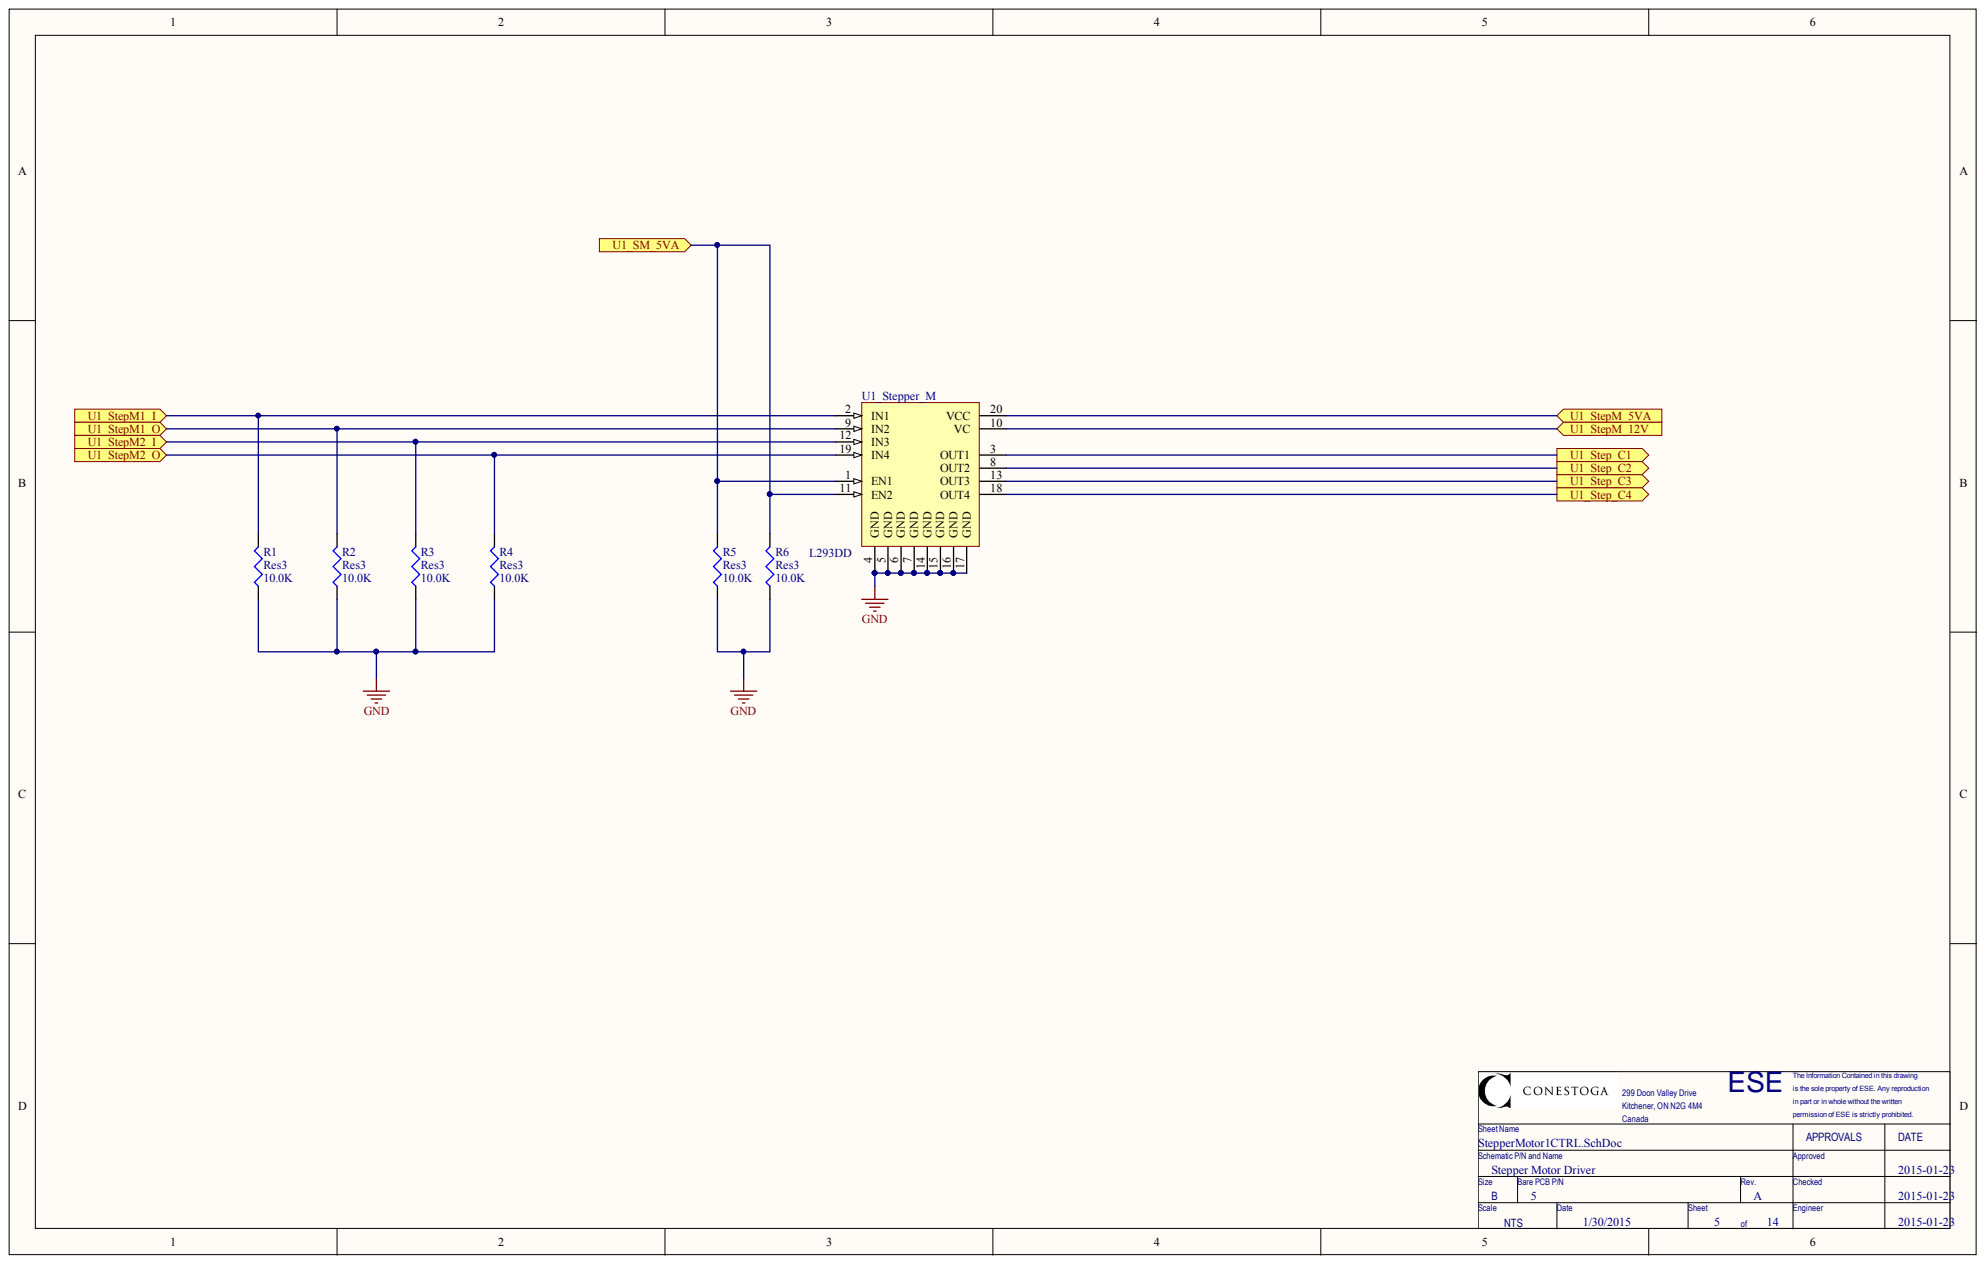
[picture p49: page 5]

of ESE. Any re

S h e e t Na m e Stepper Motor1C T RL.SchDoc | A P P ROVA L S | D AT E

S c h e m a t i c P /N a n d Na m e Stepper Motor D r iver | A p pro v e d | 2015-01-23

S i z e B | B are PCB P / N 5 | Re v . A | Ch e c k e d | 2015-01-23

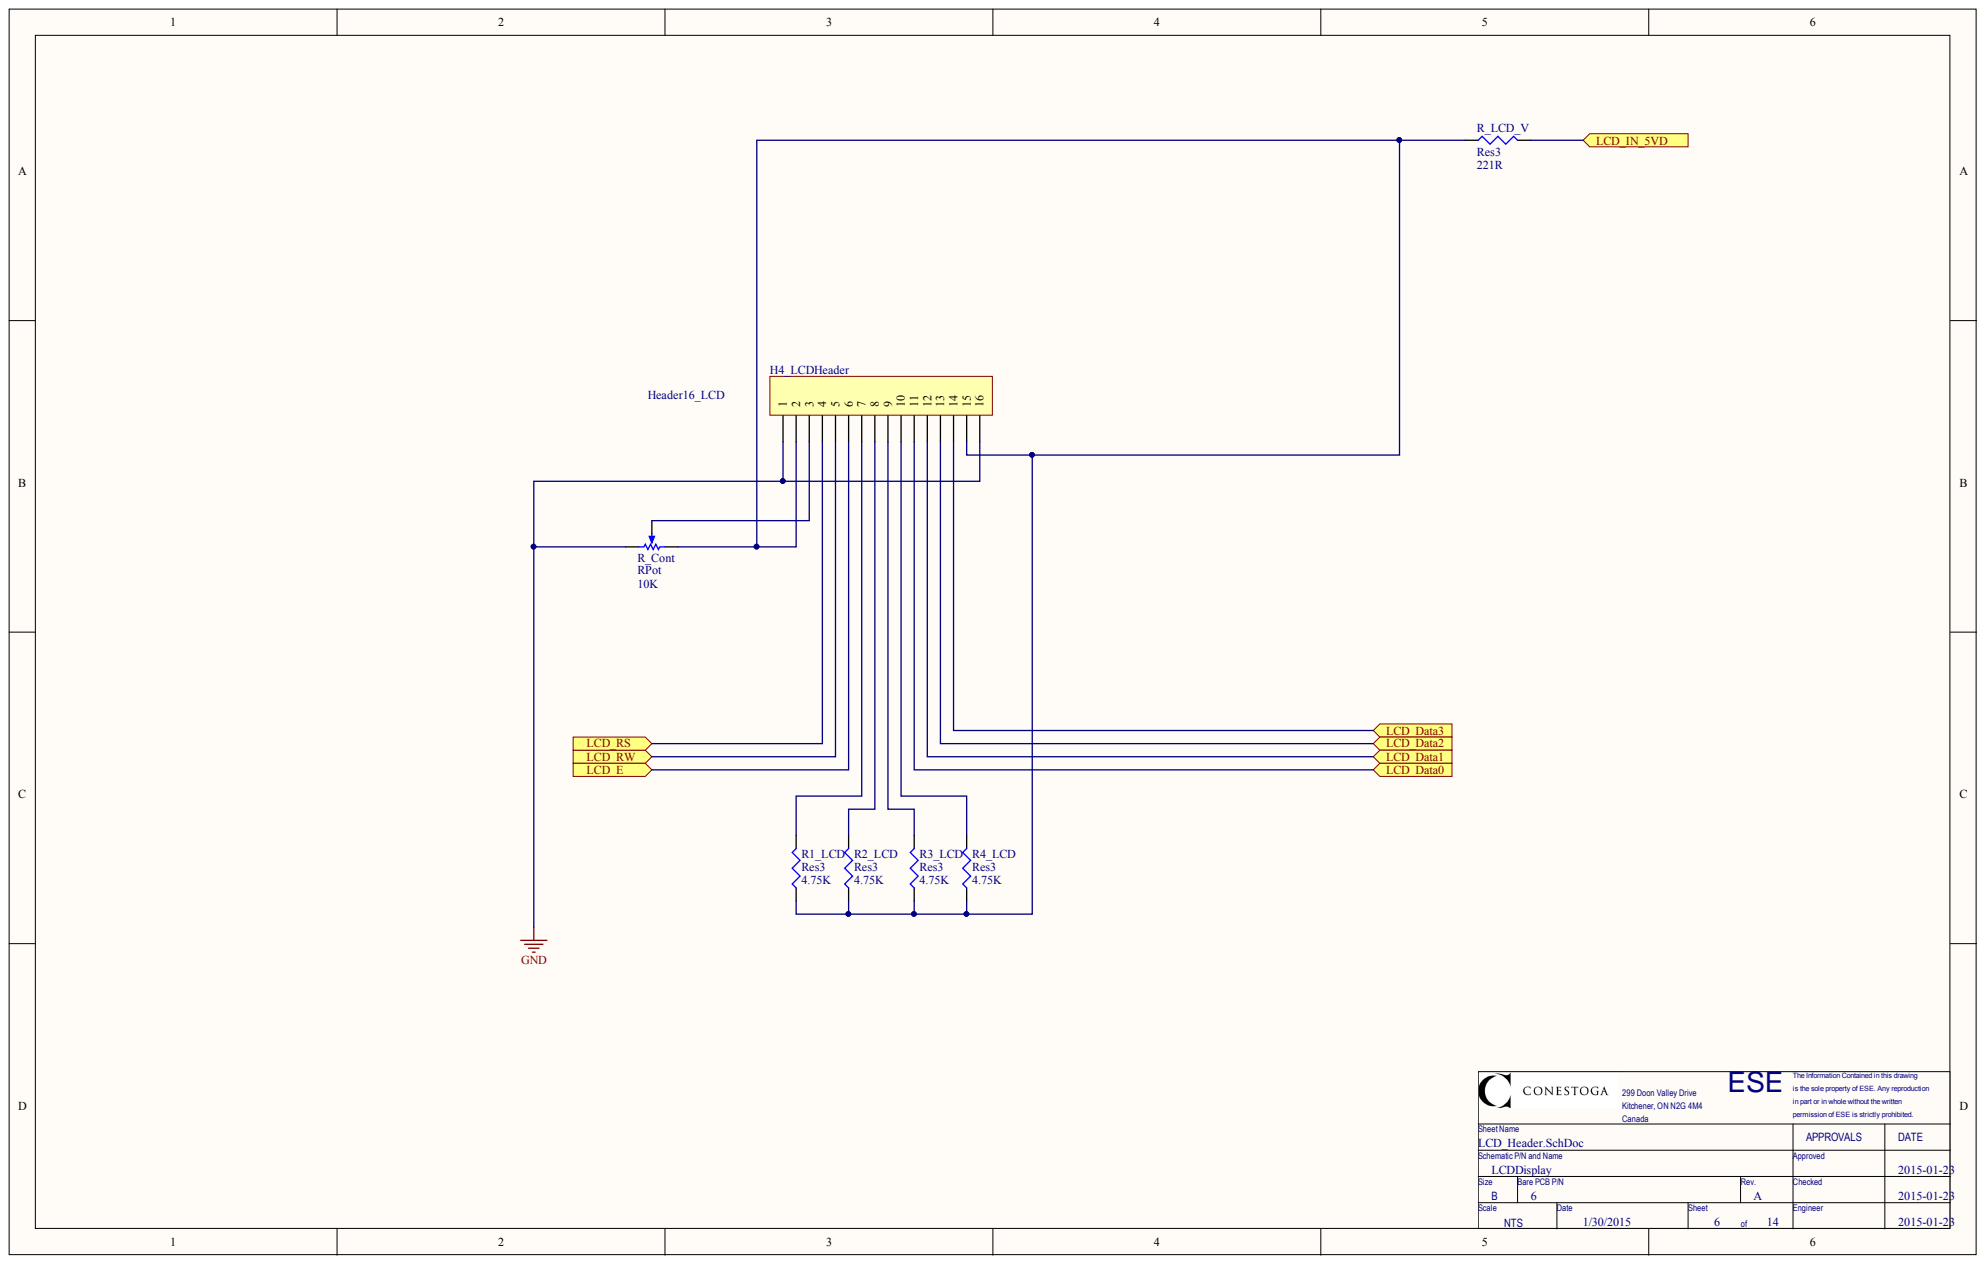
[picture p50: page 6]

ESE is the sole property of ESE. Any reproduction

The Information Contained in this drawing

in part or in whole without the written

permission of ESE is strictly prohibited.

Sheet Name LCD_Header.SchDoc | APPROVALS | DATE

Schematic P/N and Name LCDDisplay | Approved | 2015-01-23

Size B | Bare PCB P/N 6 | Rev. A | Checked | 2015-01-23

Scale NTS | Date 1/30/2015 | Sheet 6 of 14 | Engineer | 2015-01-23

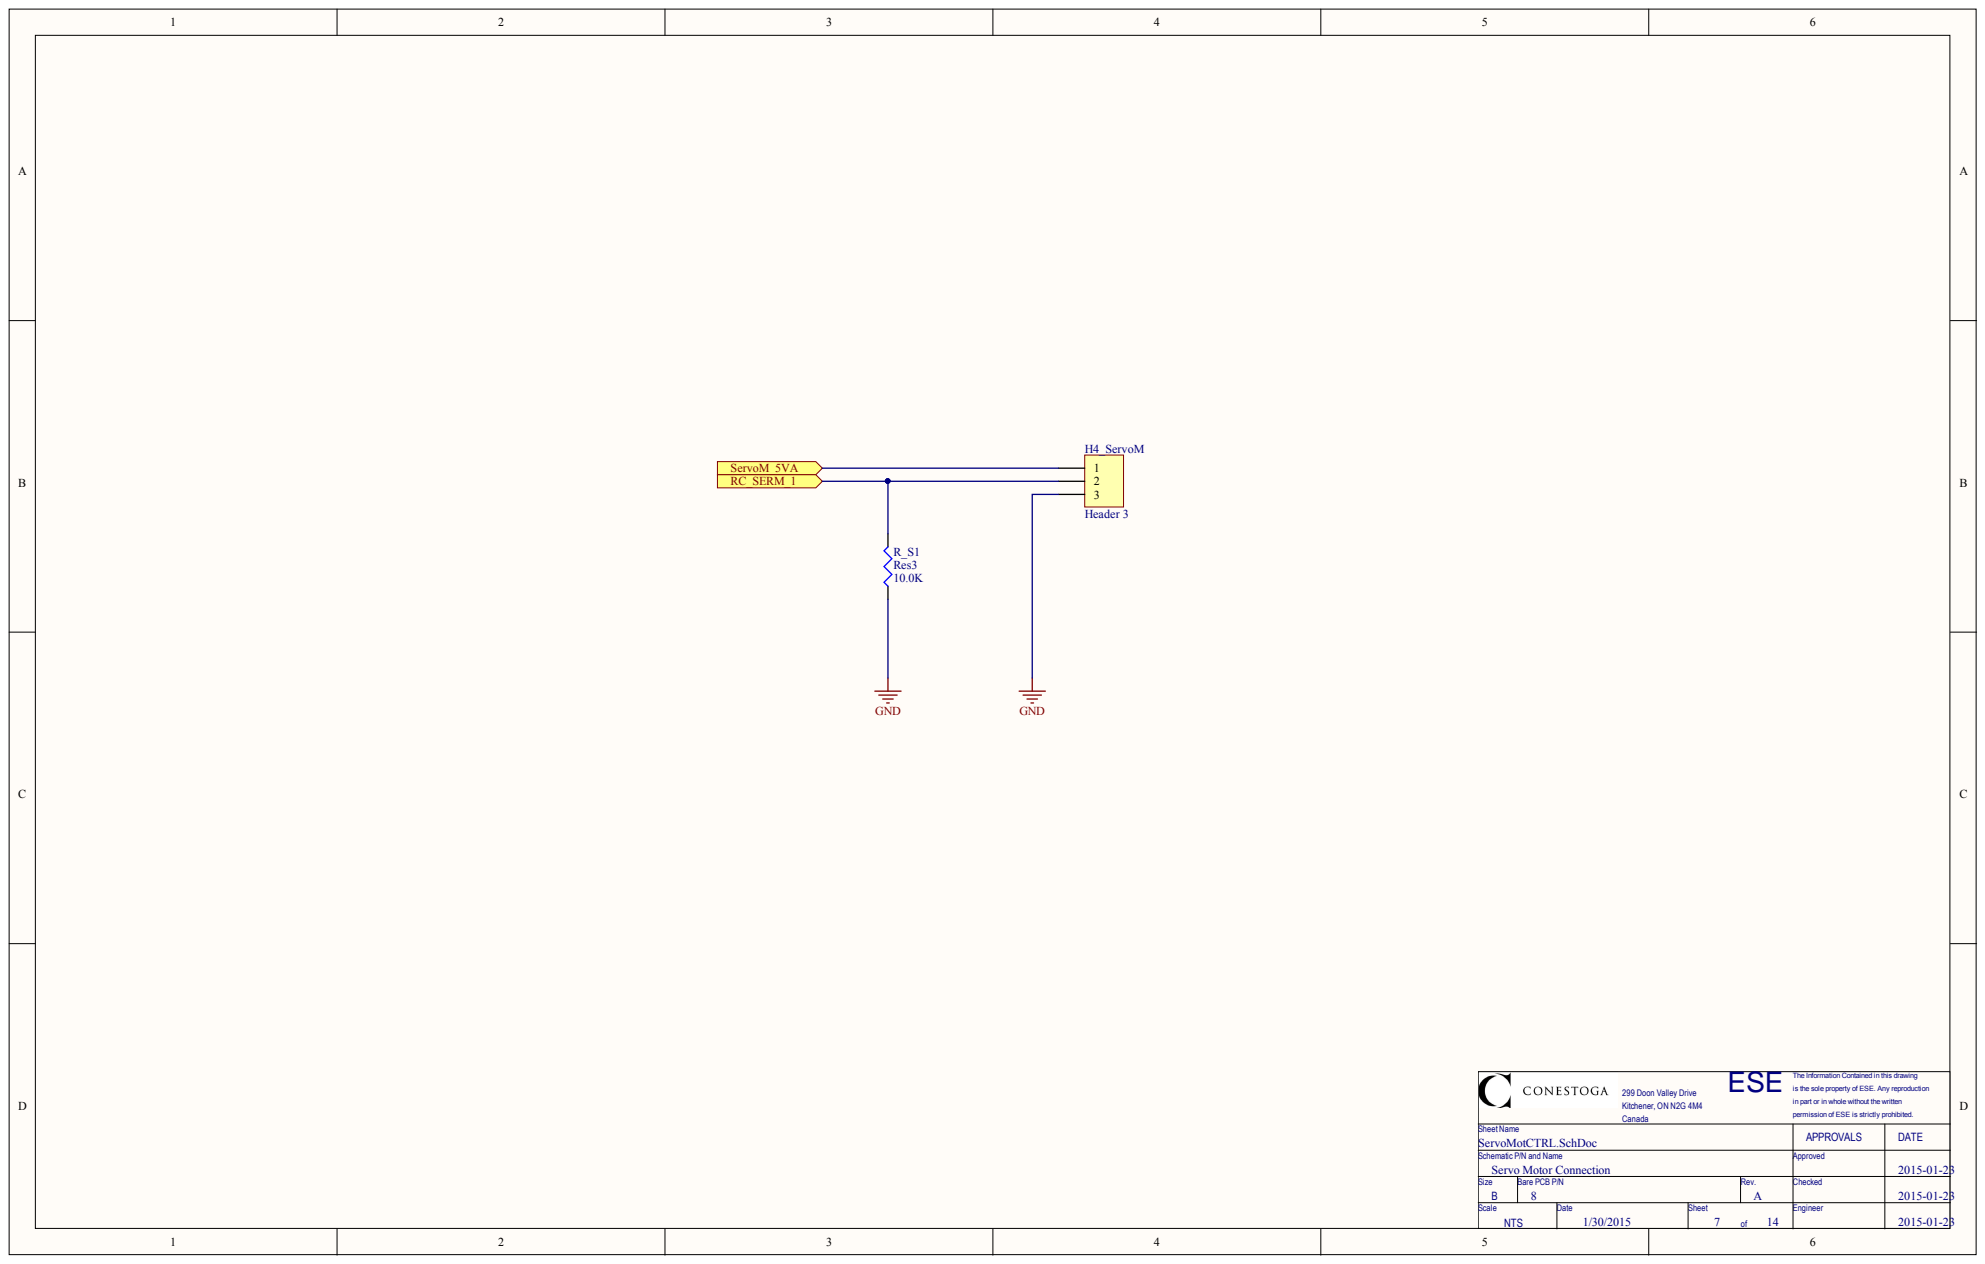
[picture p51: page 7]

ESE is the sole property of ESE. Any reproduction

The Information Contained in this drawing

in part or in whole without the written

permission of ESE is strictly prohibited.

Sheet Name ServoMotCTRL.SchDoc | APPROVALS | DATE

Schematic P/N and Name Servo Motor Connection | Approved | 2015-01-23

Size B | Bare PCB P/N 8 | Rev. A | Checked | 2015-01-23

Scale NTS | Date 1/30/2015 | Sheet 7 of 14 | Engineer | 2015-01-23

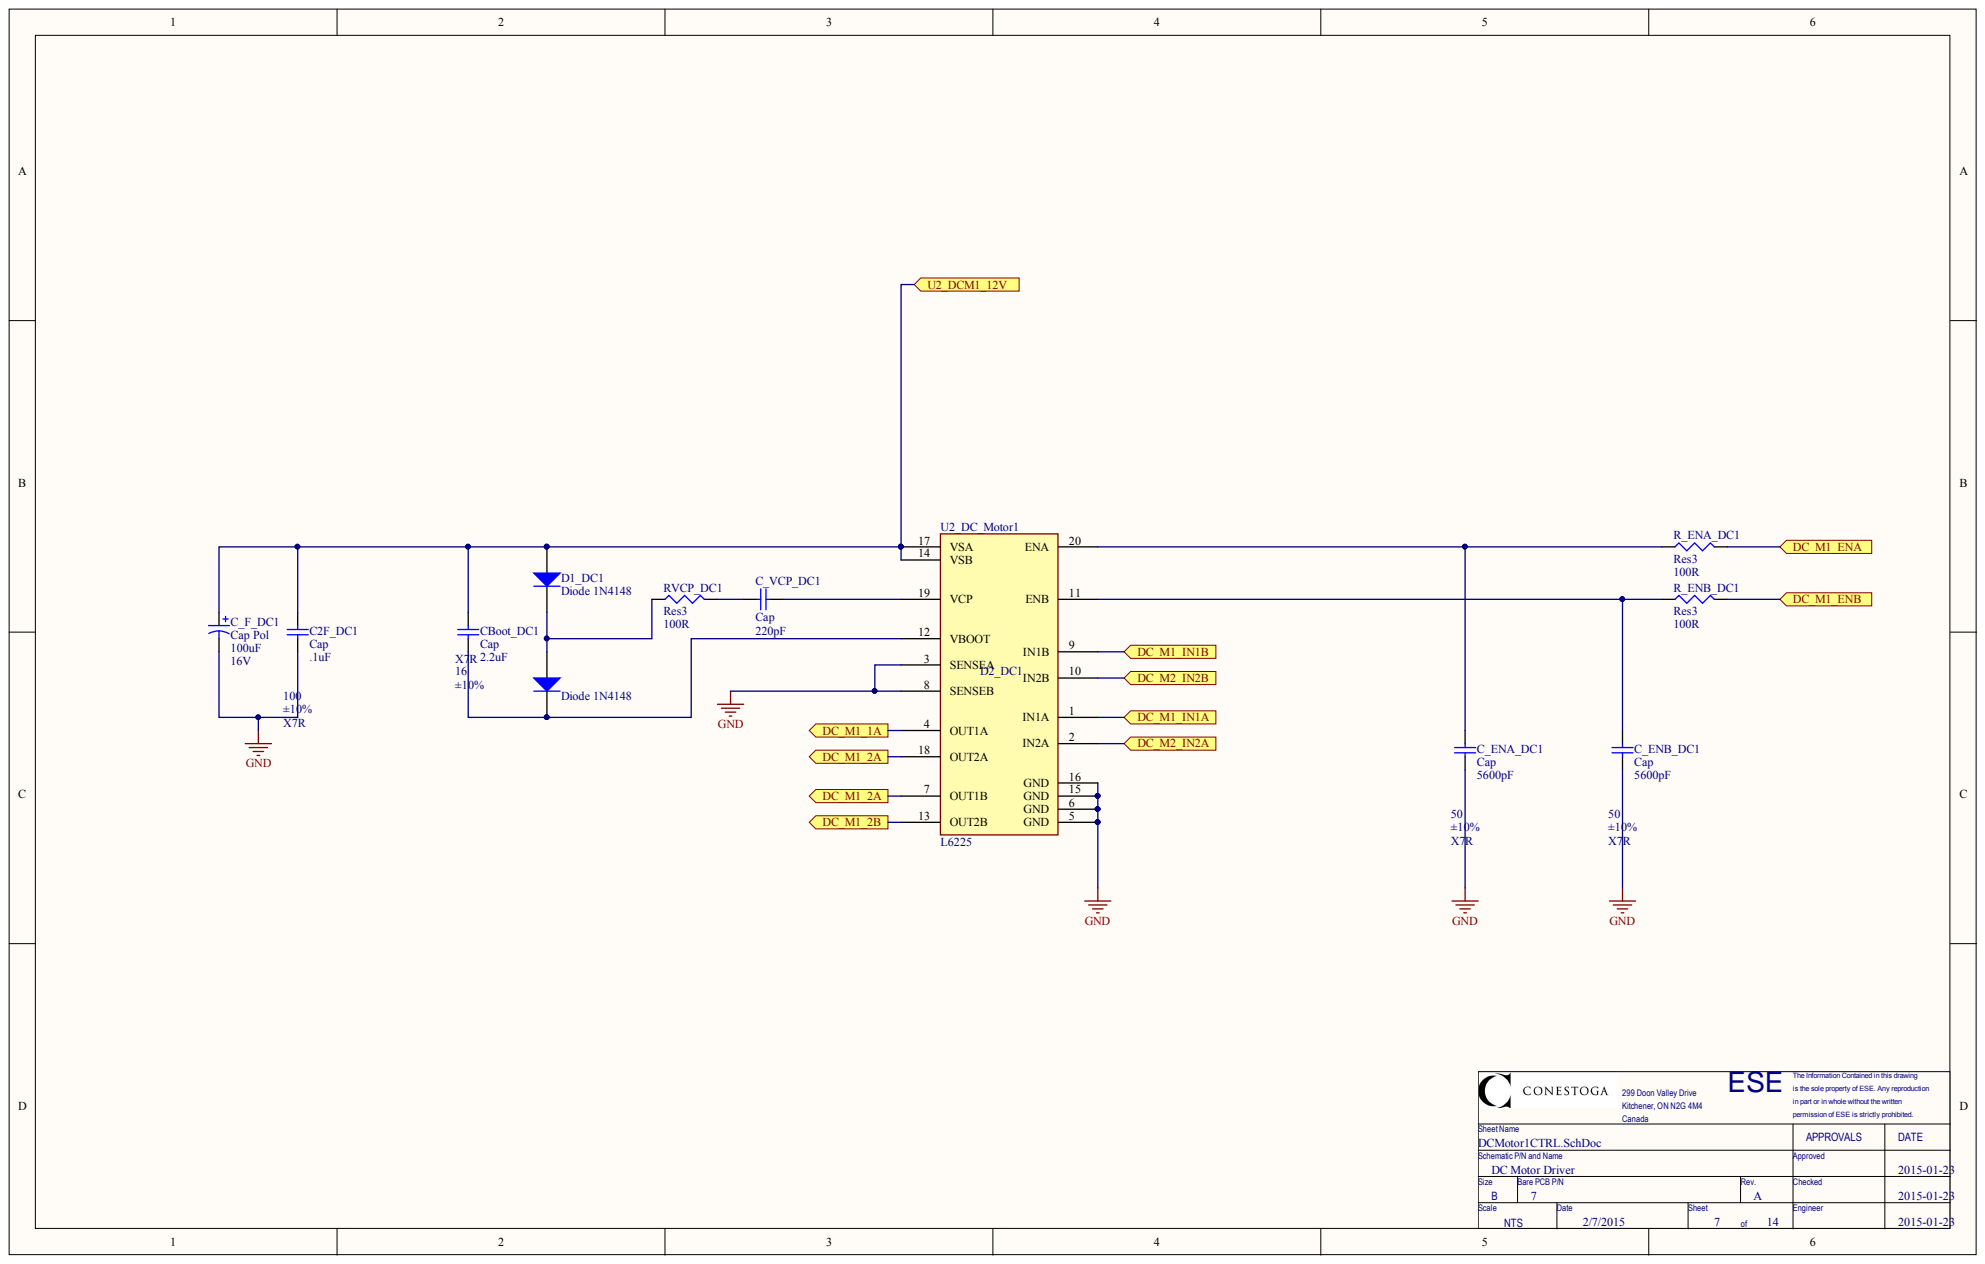
[picture p52: page 8]

ESE is the sole property of ESE. Any reproduction

The Information Contained in this drawing

in part or in whole without the written

permission of ESE is strictly prohibited.

Sheet Name DCMotor1CTRL.SchDoc | APPROVALS | DATE

Schematic P/N and Name DC Motor Driver | Approved | 2015-01-23

Size B | Bare PCB P/N 7 | Rev. A | Checked | 2015-01-23

Scale NTS | Date 2/7/2015 | Sheet 7 of 14 | Engineer | 2015-01-23

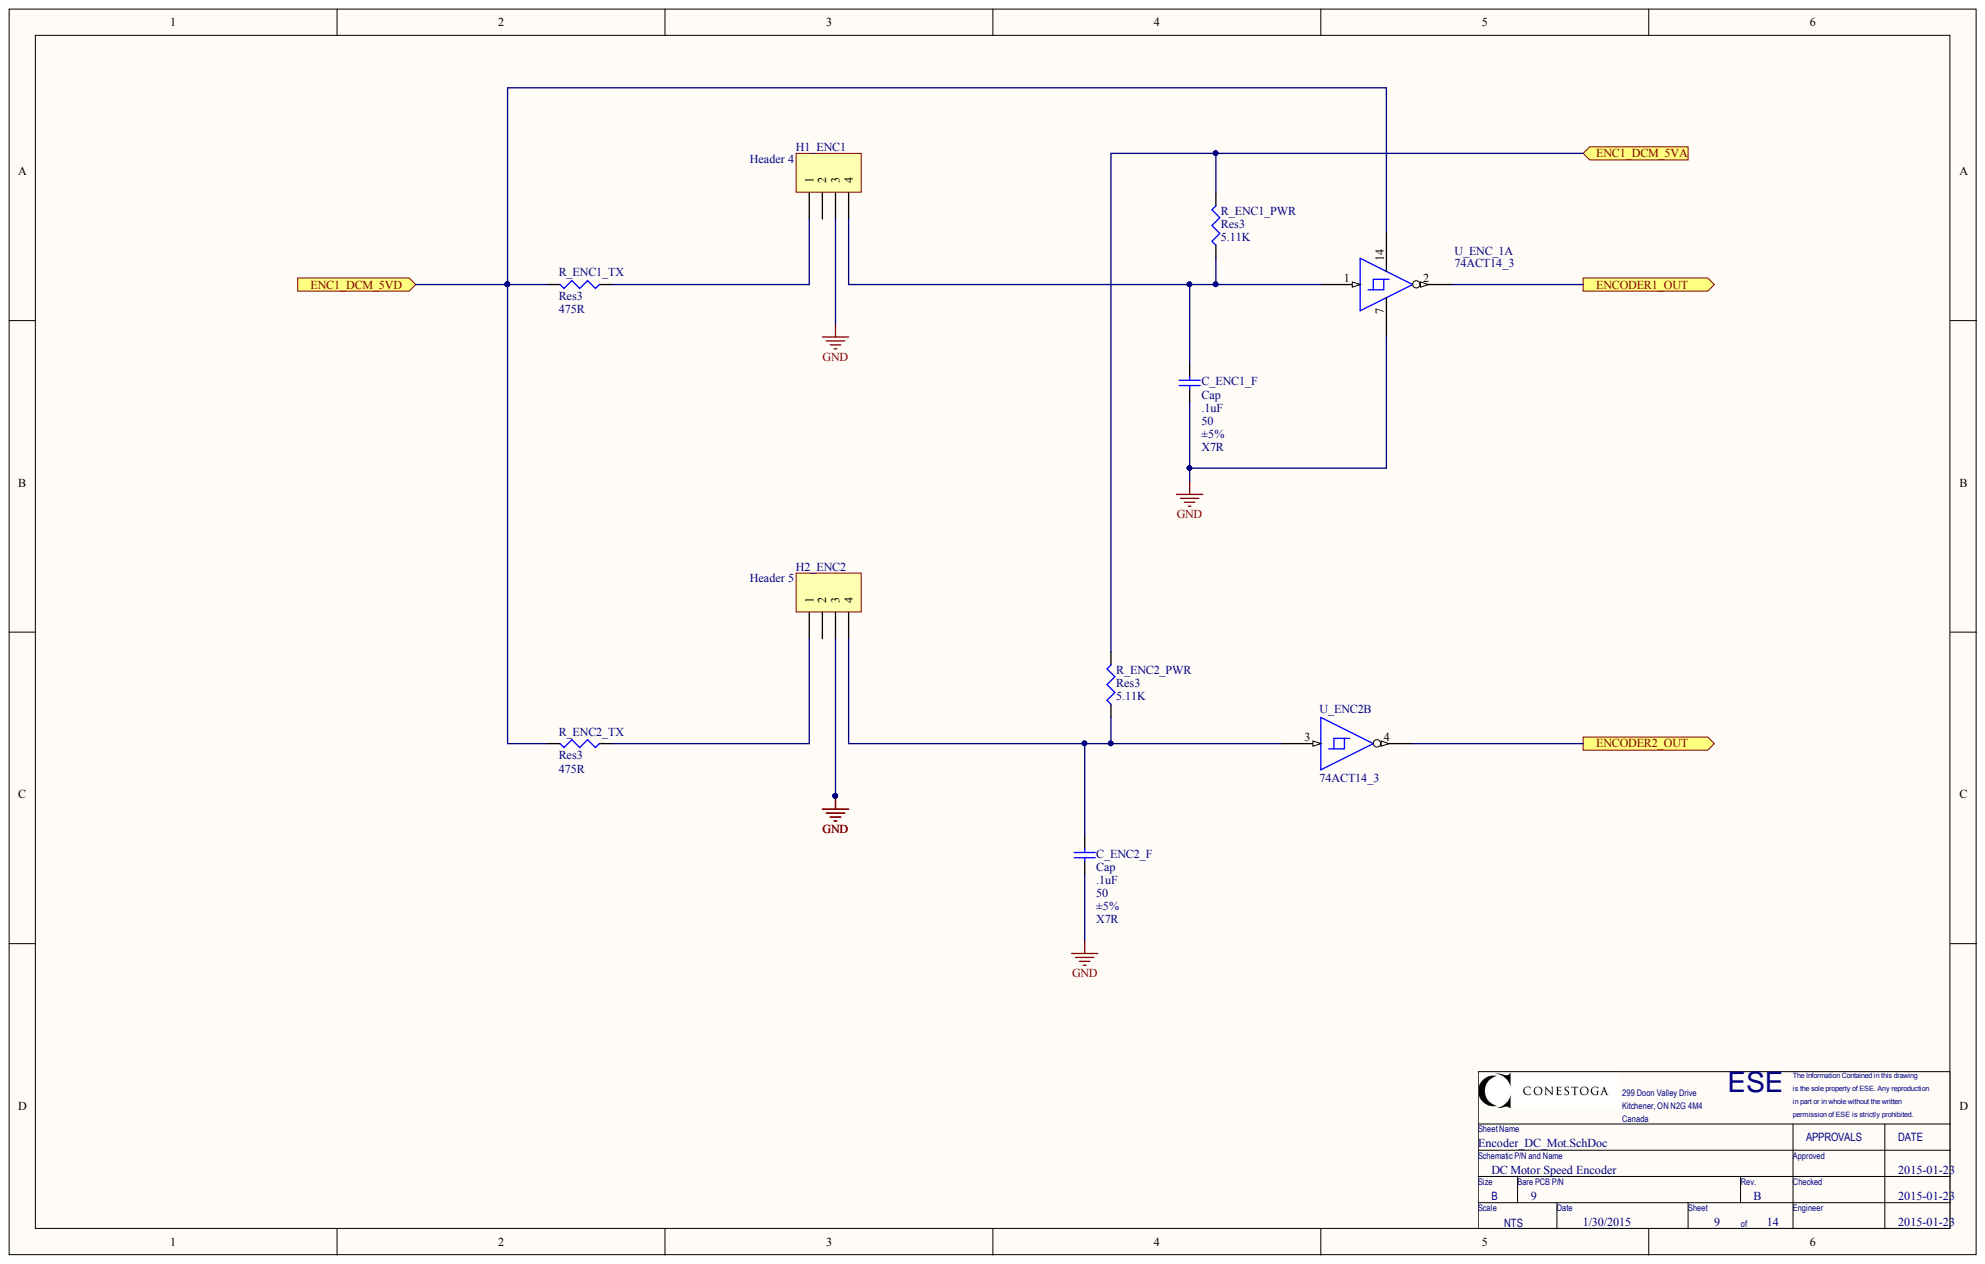
[picture p53: page 9]

ESE is the sole property of ESE. Any reproduction

The Information Contained in this drawing

in part or in whole without the written

permission of ESE is strictly prohibited.

Sheet Name Encoder_DC_Mot.SchDoc | APPROVALS | DATE

Schematic P/N and Name DC Motor Speed Encoder | Approved | 2015-01-23

Size B | Bare PCB P/N 9 | Rev. B | Checked | 2015-01-23

Scale NTS | Date 1/30/2015 | Sheet 9 of 14 | Engineer | 2015-01-23

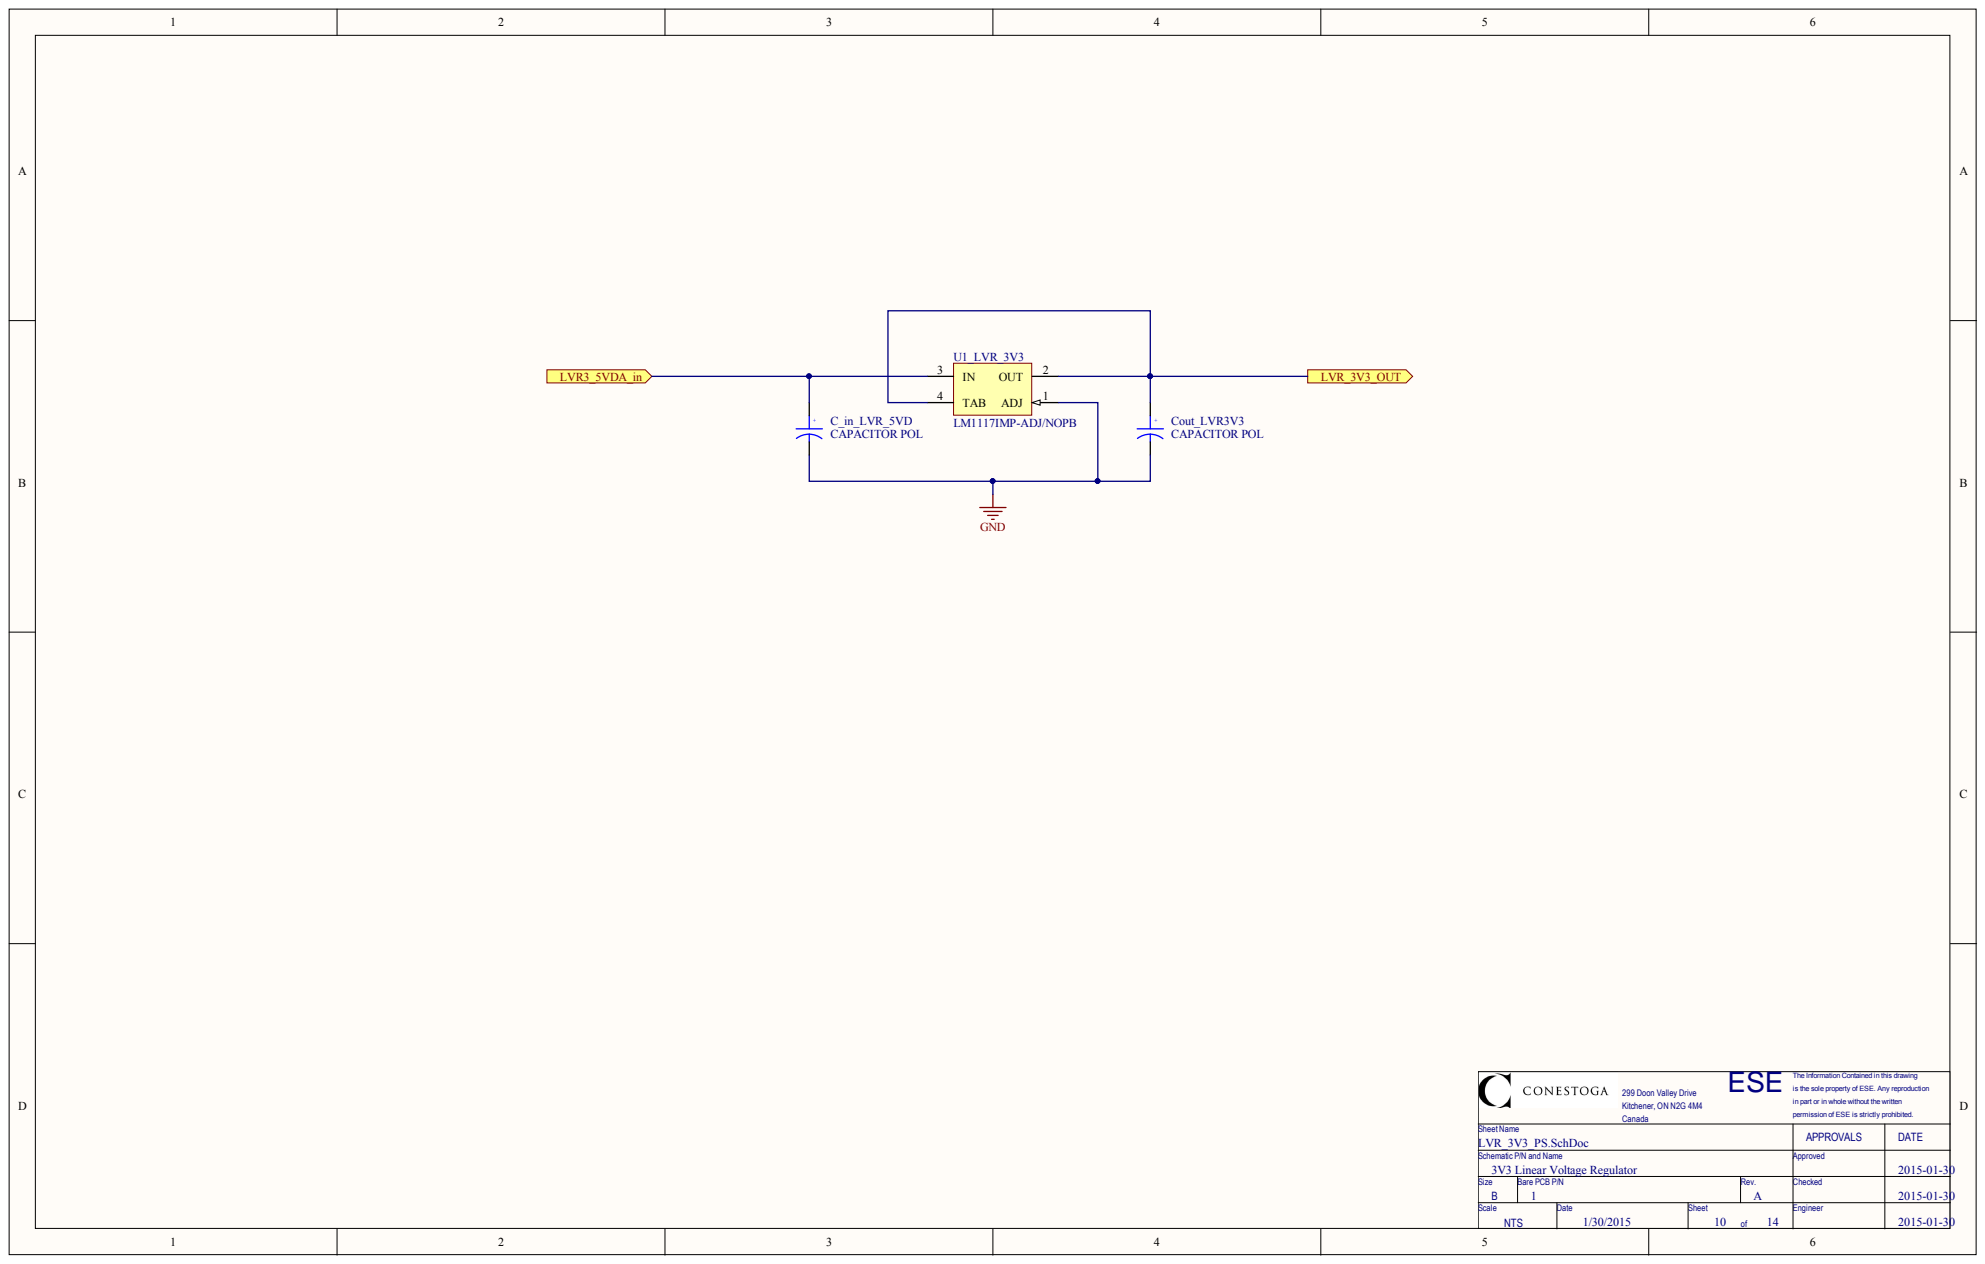
[picture p54: page 10]

ESE is the sole property of ESE. Any reproduction

The Information Contained in this drawing

in part or in whole without the written

permission of ESE is strictly prohibited.

Sheet Name LVR_3V3_PS.SchDoc | APPROVALS | DATE

Schematic P/N and Name 3V3 Linear Voltage Regulator | Approved | 2015-01-30

Size B | Bare PCB P/N 1 | Rev. A | Checked | 2015-01-30

Scale NTS | Date 1/30/2015 | Sheet 10 of 14 | Engineer | 2015-01-30

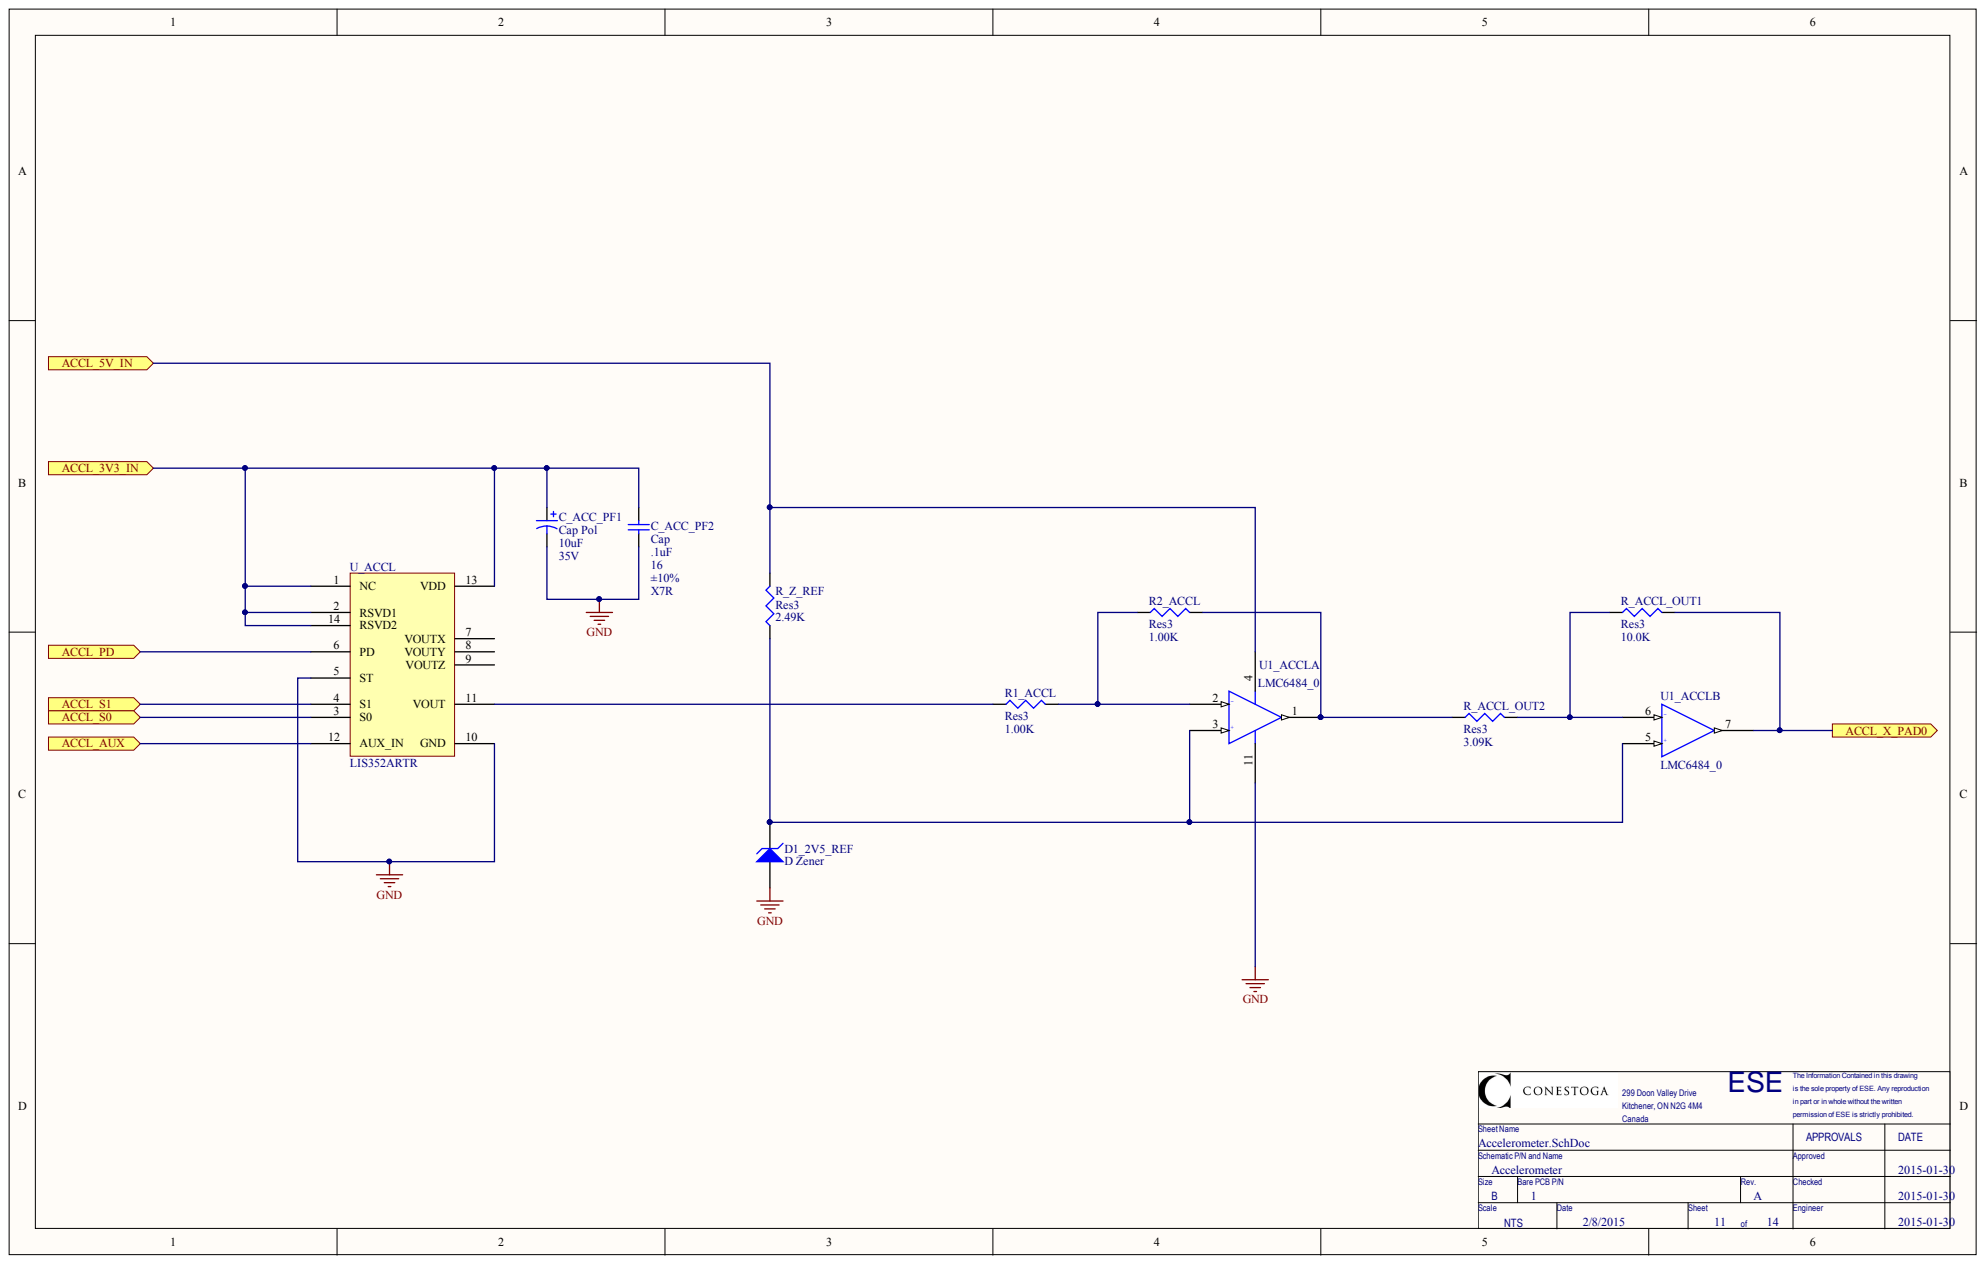
[picture p55: page 11]

ESE is the sole property of ESE. Any reproduction

The Information Contained in this drawing

in part or in whole without the written

permission of ESE is strictly prohibited.

Sheet Name Accelerometer.SchDoc | APPROVALS | DATE

Schematic P/N and Name Accelerometer | Approved | 2015-01-30

Size B | Bare PCB P/N 1 | Rev. A | Checked | 2015-01-30

Scale NTS | Date 2/8/2015 | Sheet 11 of 14 | Engineer | 2015-01-30

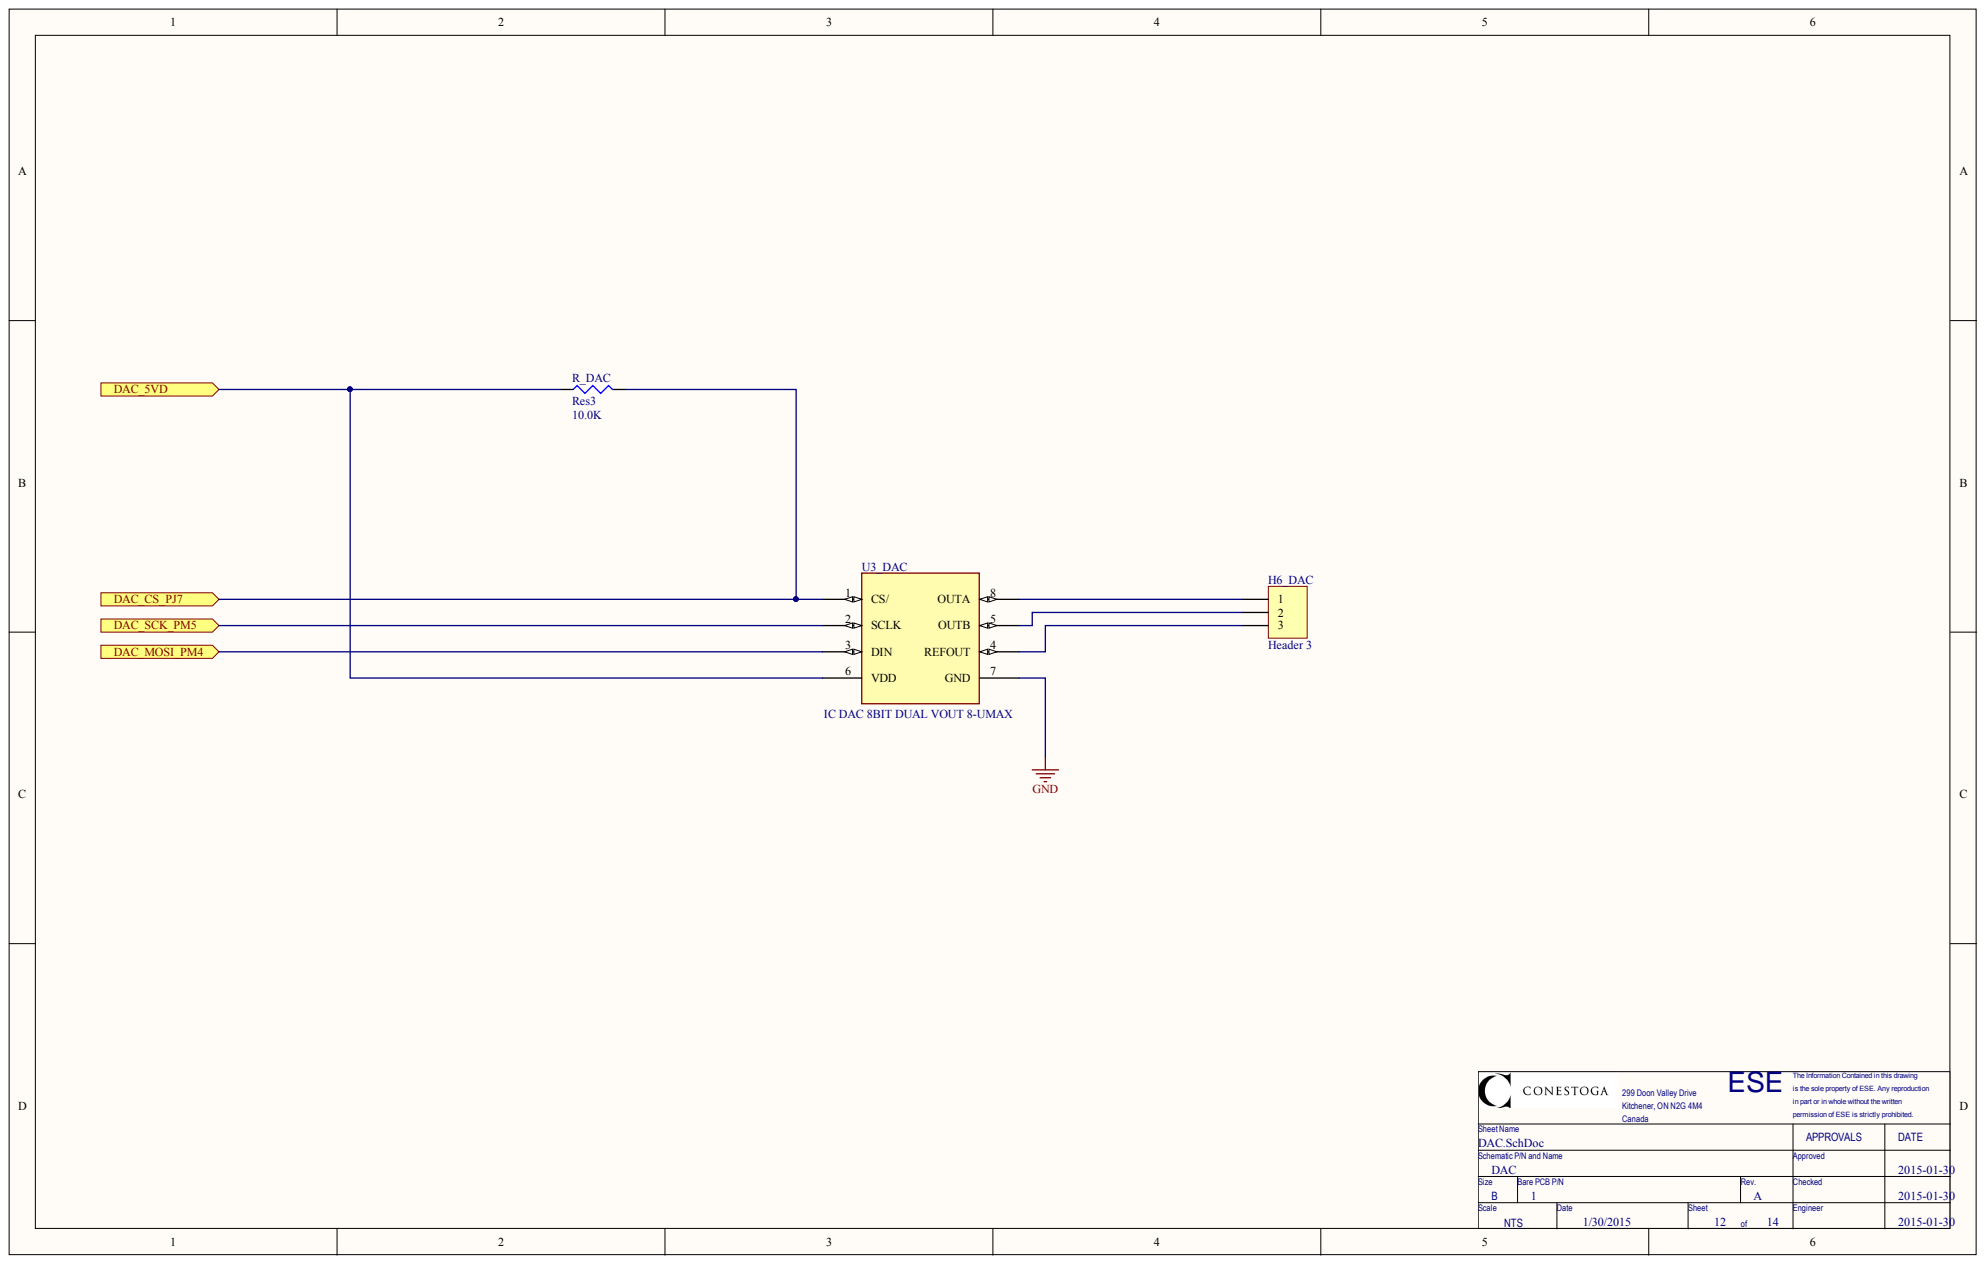
[picture p56: page 12]

IC DAC 8BIT DUAL VOUT 8-UMAX

ESE is the sole property of ESE. Any reproduction

The Information Contained in this drawing

in part or in whole without the written

permission of ESE is strictly prohibited.

Sheet Name DAC.SchDoc | APPROVALS | DATE

Schematic P/N and Name DAC | Approved | 2015-01-30

Size B | Bare PCB P/N 1 | Rev. A | Checked | 2015-01-30

Scale NTS | Date 1/30/2015 | Sheet 12 of 14 | Engineer | 2015-01-30

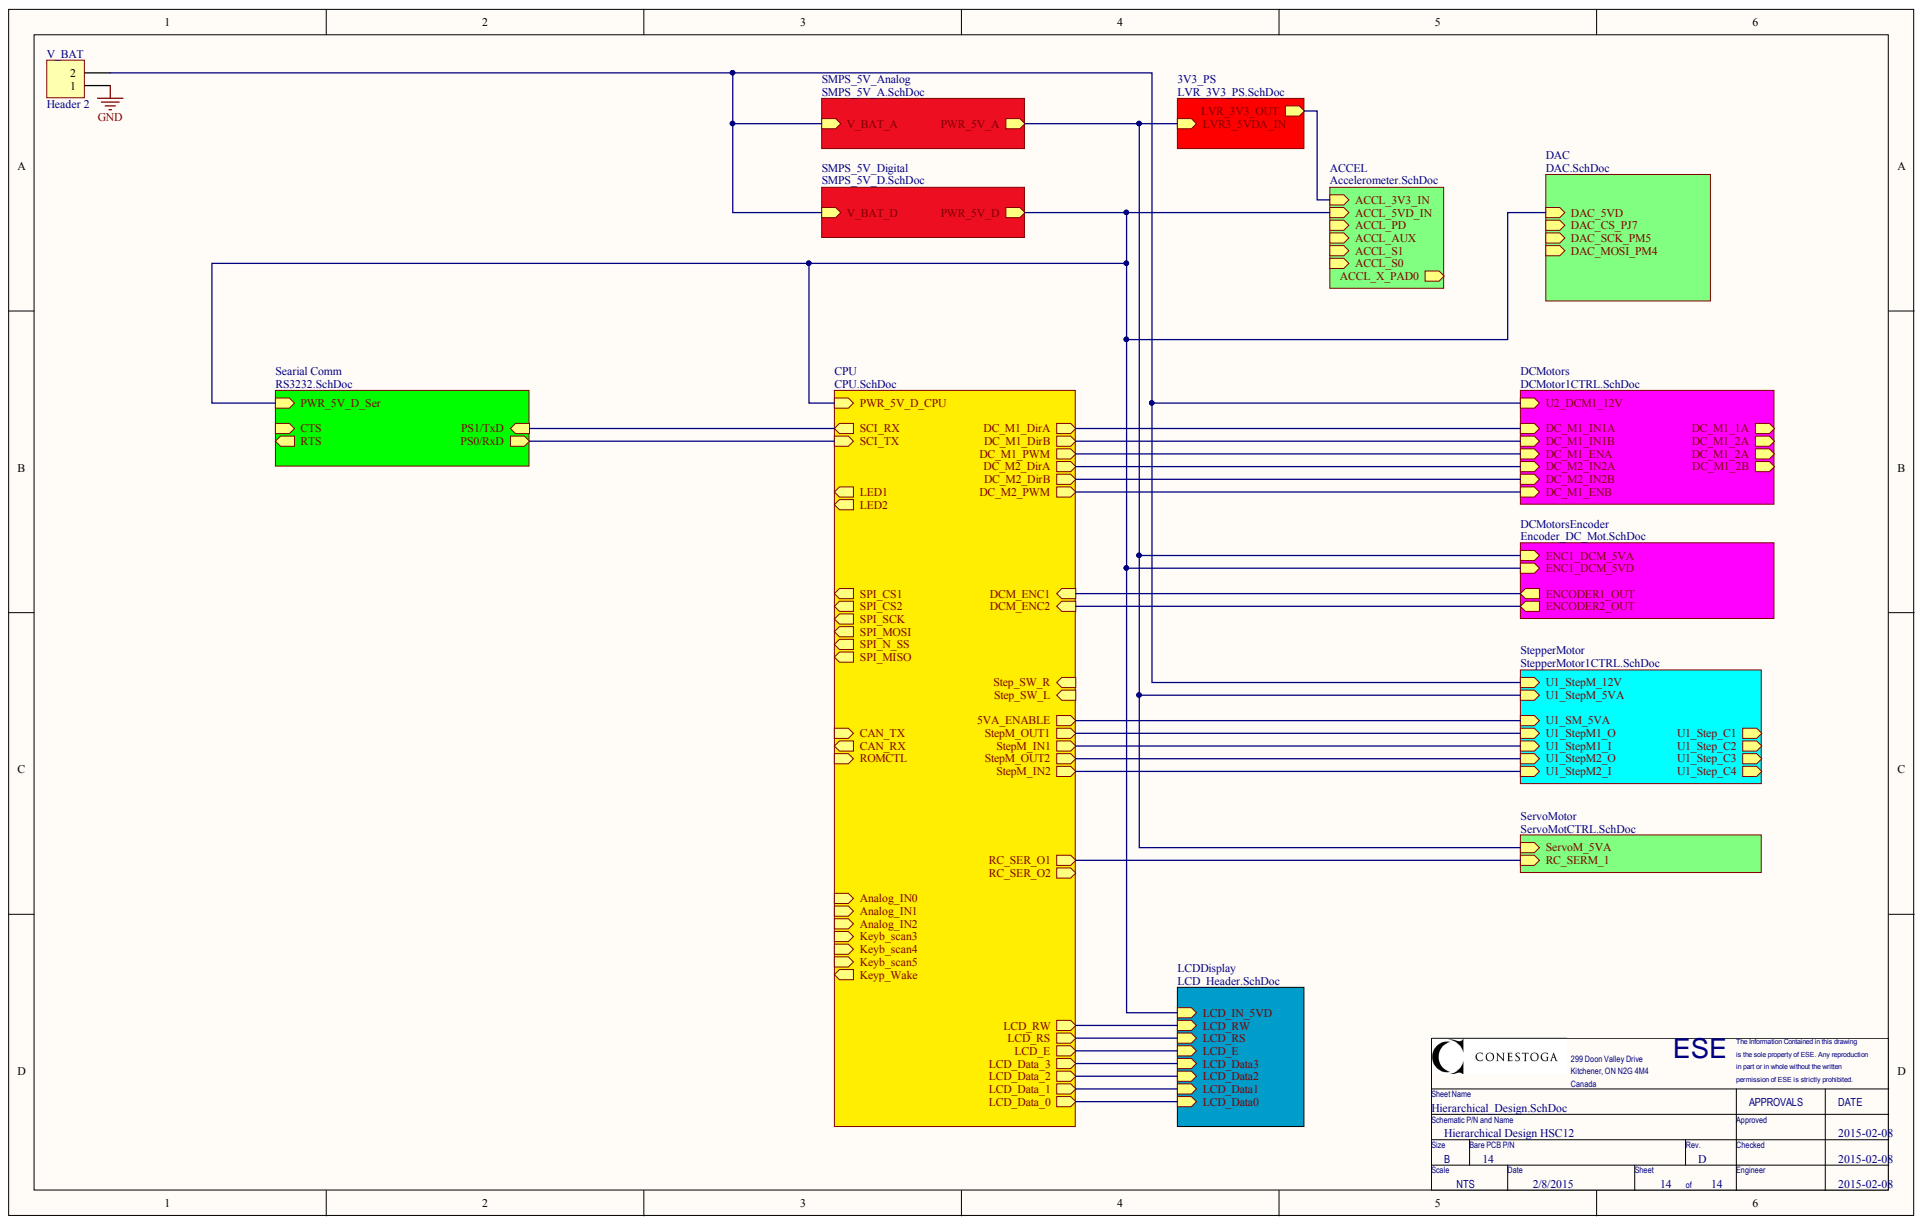
[picture p57: page 13]

Searial Comm RS3232.SchDoc | CPU CPU.SchDoc

DCMotors

ESE is the sole property of ESE. Any reproduction

The Information Contained in this drawing

in part or in whole without the written

permission of ESE is strictly prohibited.

Sheet Name Hierarchical_Design.SchDoc | APPROVALS | DATE

Schematic P/N and Name Hierarchical Design HSC12 | Approved | 2015-02-08

Size B | Bare PCB P/N 14 | Rev. D | Checked | 2015-02-08

Scale NTS | Date 2/8/2015 | Sheet 14 of 14 | Engineer | 2015-02-08

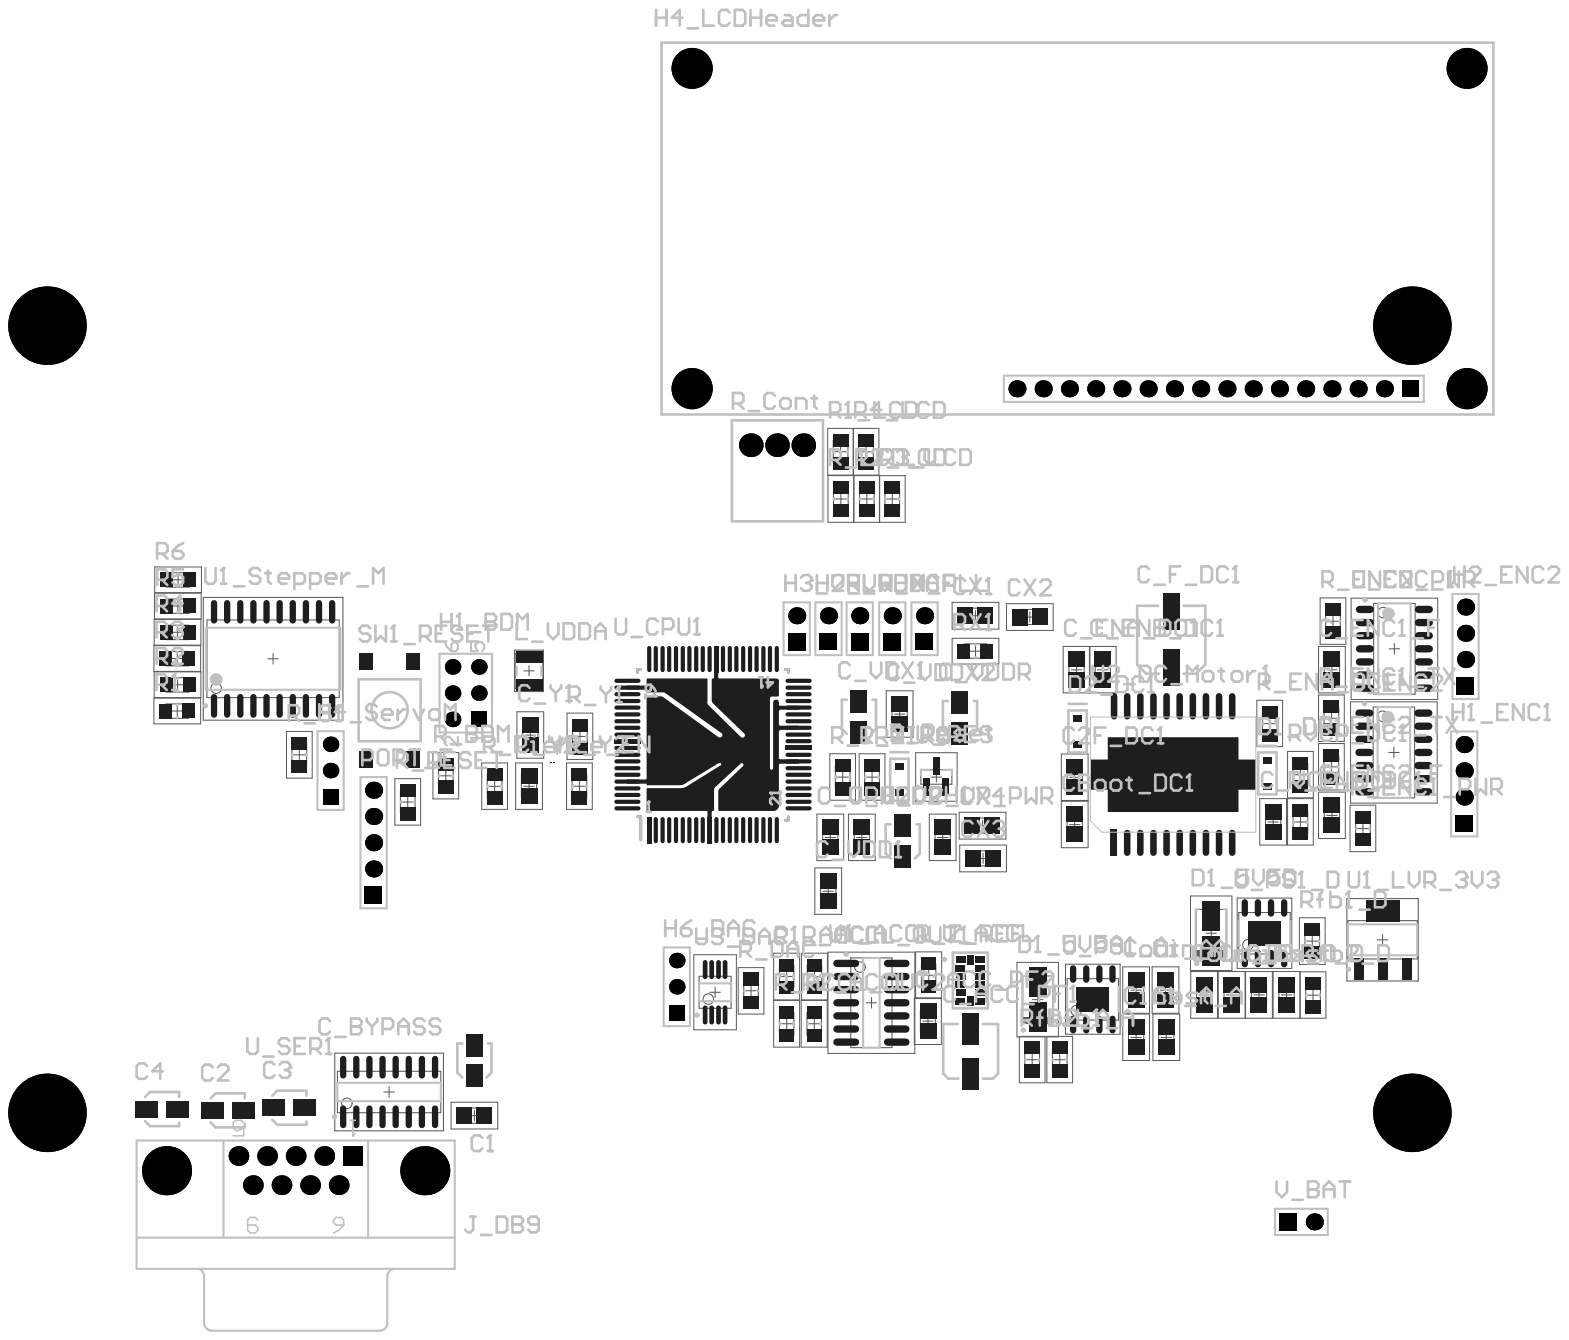
[picture p58: page 14]

Designator | Footprint | LibRef | Quantity

C1, C2F_DC1, C_ACC_PF2,
C_ENA_DC1, C_ENB_DC1, C_ENC1_F, C_ENC2_F, C_VCP_DC1, C_VDD1, C_VDD2, C_VDDX2, C_VR_PWR, C_VRH2, C_Y1, C_Y2, CBoot_DC1,
Cbst_A, Cbst_D, Cin_A, Cin_D,
Cinx_A, Cinx_D, Cout_A, Cout_D,
CX1, CX2, CX3, CX4 | CAPC2012X09M

CAP-X7R-47000pF-50V-±10%, CAP-X7R-.1uF-100V-±10%, CAP-X7R-.1uF-16V-±10%, CAP-X7R-5600pF-50V-±10%, CAP-X7R-5600pF-50V-±10%, CAP-X7R-.1uF-50V-±5%, CAP-X7R-.1uF-50V-±5%, CAP-COG-220pF-50V-±5%, CAP-X7R-.1uF-50V-±5%, CAP-X7R-.1uF-50V-±5%, CAP-X7R-10000pF-50V-±10%, CAP-X7R-.1uF-16V-±10%, CAP-X7R-10000pF-50V-±10%, CAP-COG-22pF-50V-±5%, CAP-COG-22pF-50V-±5%, CAP-X7R-2.2uF-16V-±10%, CAP-X7R-10000pF-50V-±10%, CAP-X7R-10000pF-50V-±10%, CAP-X7R-2.2uF-16V-±10%, CAP-X7R-2.2uF-16V-±10%, CAP-X7R-1uF-16V-±10%, CAP-X7R-1uF-16V-±10%, CAP-X5R-10uF-10V-±10%, CAP-X5R-10uF-10V-±10%, CAP-X7R-4700pF-630V-±10%, CAP-X7R-4700pF-630V-±10%, CAP-X7R-.1uF-16V-±10%, CAP-COG-10000pF-50V-
±5% | 28
C2, C3, C4, C_BYPASS, C_VDDR, C_VDX1, C_VRH1 | CAPACITOR_3MM | Cap Polar-0.33uF-50V, Cap Polar-0.33uF-50V, Cap Polar-0.33uF-50V, Cap Polar-0.1uF-50V, Cap Polar-10uF-16V, Cap Polar-10uF-16V, Cap Polar-10uF-16V | 7
C_ACC_PF1 | CAPACITOR_5MM | Cap Polar-10uF-35V | 1
C_F_DC1 | CAPACITOR_6.3MM | Cap Polar-100uF-16V | 1
C_in_LVR_5VD, Cout_LVR3V3 | | CAPACITOR POL | 2
D1_2V5_REF | | D Zener | 1
D1_5V5A, D1_5V5D | DIOM4326X23M | DIODE SCHOTTKY 40V 2A SMA | 2
D1_DC1, D2_DC1, D_Reset | zener_sod323 | Diode 1N4148 | 3
H1_BDM | HDR2X3 | Header 3X2 | 1
H1_ENC1 | HDR1X4 | Header 4 | 1
H2_ENC2 | HDR1X4 | Header 4 | 1
H2_VRH, H3_VRL, H_PLL, H_VDDA, H_XCF, V_BAT | HDR1X2 | Header 2 | 6
H4_LCDHeader | HDR1X16_LCD | Header16_LCD | 1
H4_ServoM, H6_DAC | HDR1X3 | Header 3 | 2
J_DB9 | DSUB1.385-2H9 | D Connector 9 | 1
L1_A, L1_D | INDP8080X40M | SRN8040 | 2
L_VDDA | C1210 | INDUCTOR | 1
PORT_E | HDR1X5 | Header 5 | 1
R1, R1_ACCL, R1_LCD, R2, R2_ACCL, R2_LCD, R3, R3_LCD, R4, R4_LCD, R5, R6, R_ACCL_OUT1, R_ACCL_OUT2, R_BDM, R_DAC, R_ENA_DC1, R_ENB_DC1, R_ENC1_PWR, R_ENC1_TX, R_ENC2_PWR, R_ENC2_TX, R_IRQ, R_LCD_V, R_Pierce_EN, R_RESET, R_S1, R_XIRQ, R_Y1, R_Y2, R_Z_REF, Rfb1_A, Rfb1_D, Rfb2_A, Rfb2_D, RVCP_DC1, RX1 | RESC2112X05M | Resistor_10.0K, Resistor_1.00K, Resistor_4.75K, Resistor_10.0K, Resistor_1.00K, Resistor_4.75K, Resistor_10.0K, Resistor_4.75K, Resistor_10.0K, Resistor_4.75K, Resistor_10.0K, Resistor_10.0K, Resistor_10.0K, Resistor_3.09K, Resistor_10.0K, Resistor_10.0K, Resistor_100R, Resistor_100R, Resistor_5.11K, Resistor_475R, Resistor_5.11K, Resistor_475R, Resistor_4.75K, Resistor_221R, Resistor_4.75K, Resistor_10.0K, Resistor_10.0K, Resistor_4.75K, Resistor_10.0K, Resistor_1.02R, Resistor_2.49K, Resistor_1.00K, Resistor_1.00K, Resistor_2.87K, Resistor_2.87K, Resistor_100R, Resistor_5.11K | 37
R_Cont | BOURNS_3386F | RPot | 1
SW1_RESET | TACT_SWITCH_6MM_SMT | SWITCH_TACTILE | 1
U1_ACCL | SOIC127P600X175-14M-NS | LMC6484_0 | 1
U1_LVR_3V3 | MP04A_L | LM1117IMP-ADJ/NOPB | 1
U1_Stepper_M | SO20_N | L293DD | 1
U2_DC_Motor1 | POWERSOP20 | L6225 | 1
U3_DAC | TSOP65P490X110-8M | Max5513-dac | 1
U_ACCL | LGA-14-3X5MM | LIS352AR | 1
U_CPU1 | QUAD.65M/80/WG17.45-HCS12 | MC9S12C128MFUE | 1
U_ENC2, U_ENC_1 | SOIC127P600X175-14M | 74ACT14_3 | 2
U_PS1_A, U_PS1_D | MRA08B_L | LM22675MR-ADJ/NOPB | 2
U_RES | SOT95P230X110-3M | DS1813-10 | 1
U_SER1 | NSO16_N | MAX3232CSE | 1
Y1 | PCBComponent_1 | ECS-160-20-5P | 1
