CircuitBreaker437/HCS12_Robot/Schematic/Design_Rev_PDF/Jan16/PCB_Project4_RevA_Marcin Czajkowski_Jan15.pdf

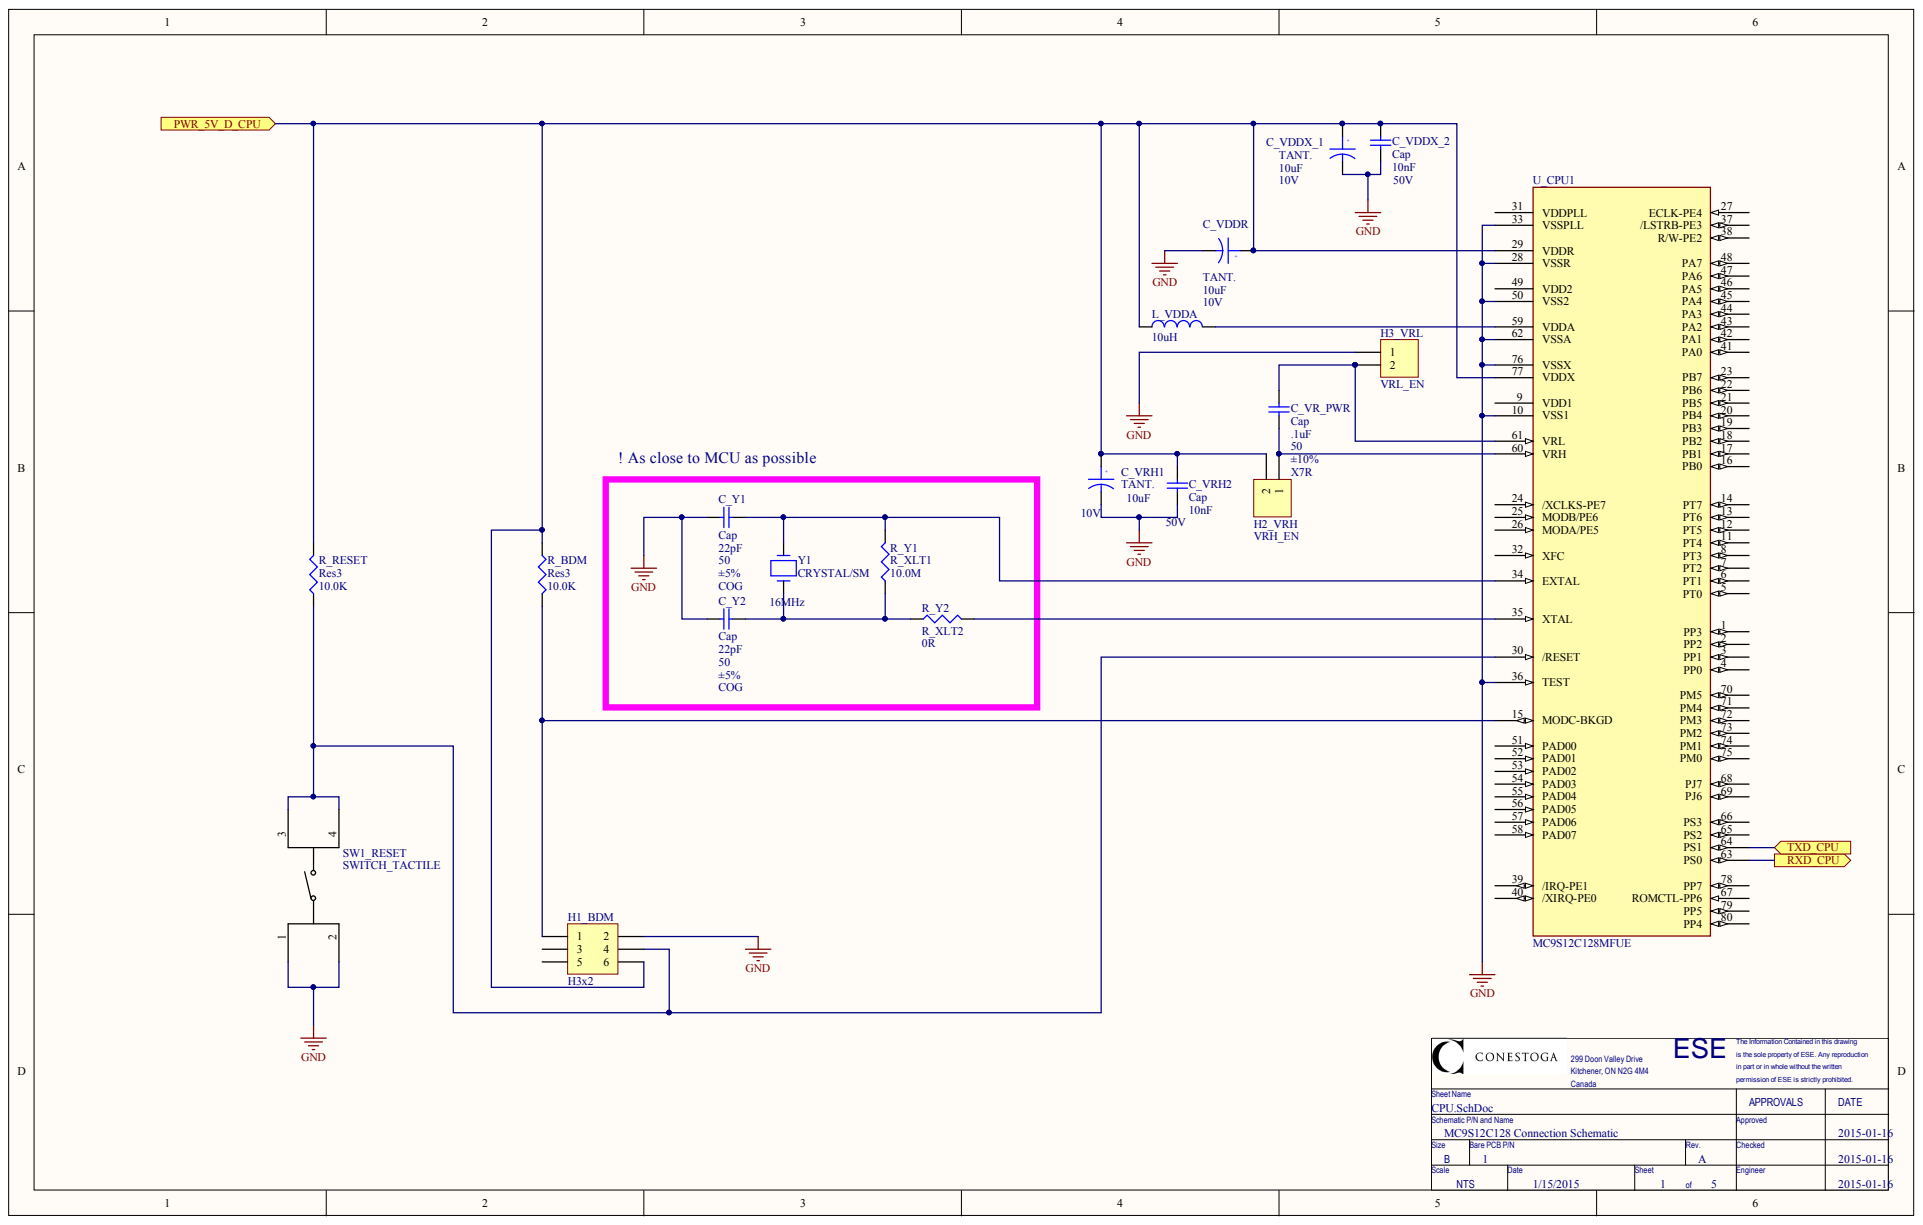
[picture p59: page 1]

of ESE. Any re

S h e e t Na m e | A P P ROVA L S | D AT E
CPU.SchDoc MC9S12C128 Connect S c h e m a t i c P /N a n d Na m e ion Schemat i c | A p pro v e d | 2015-01-16

S i z e B | B are PCB P / N 1 | Re v . A | Ch e c k e d | 2015-01-16

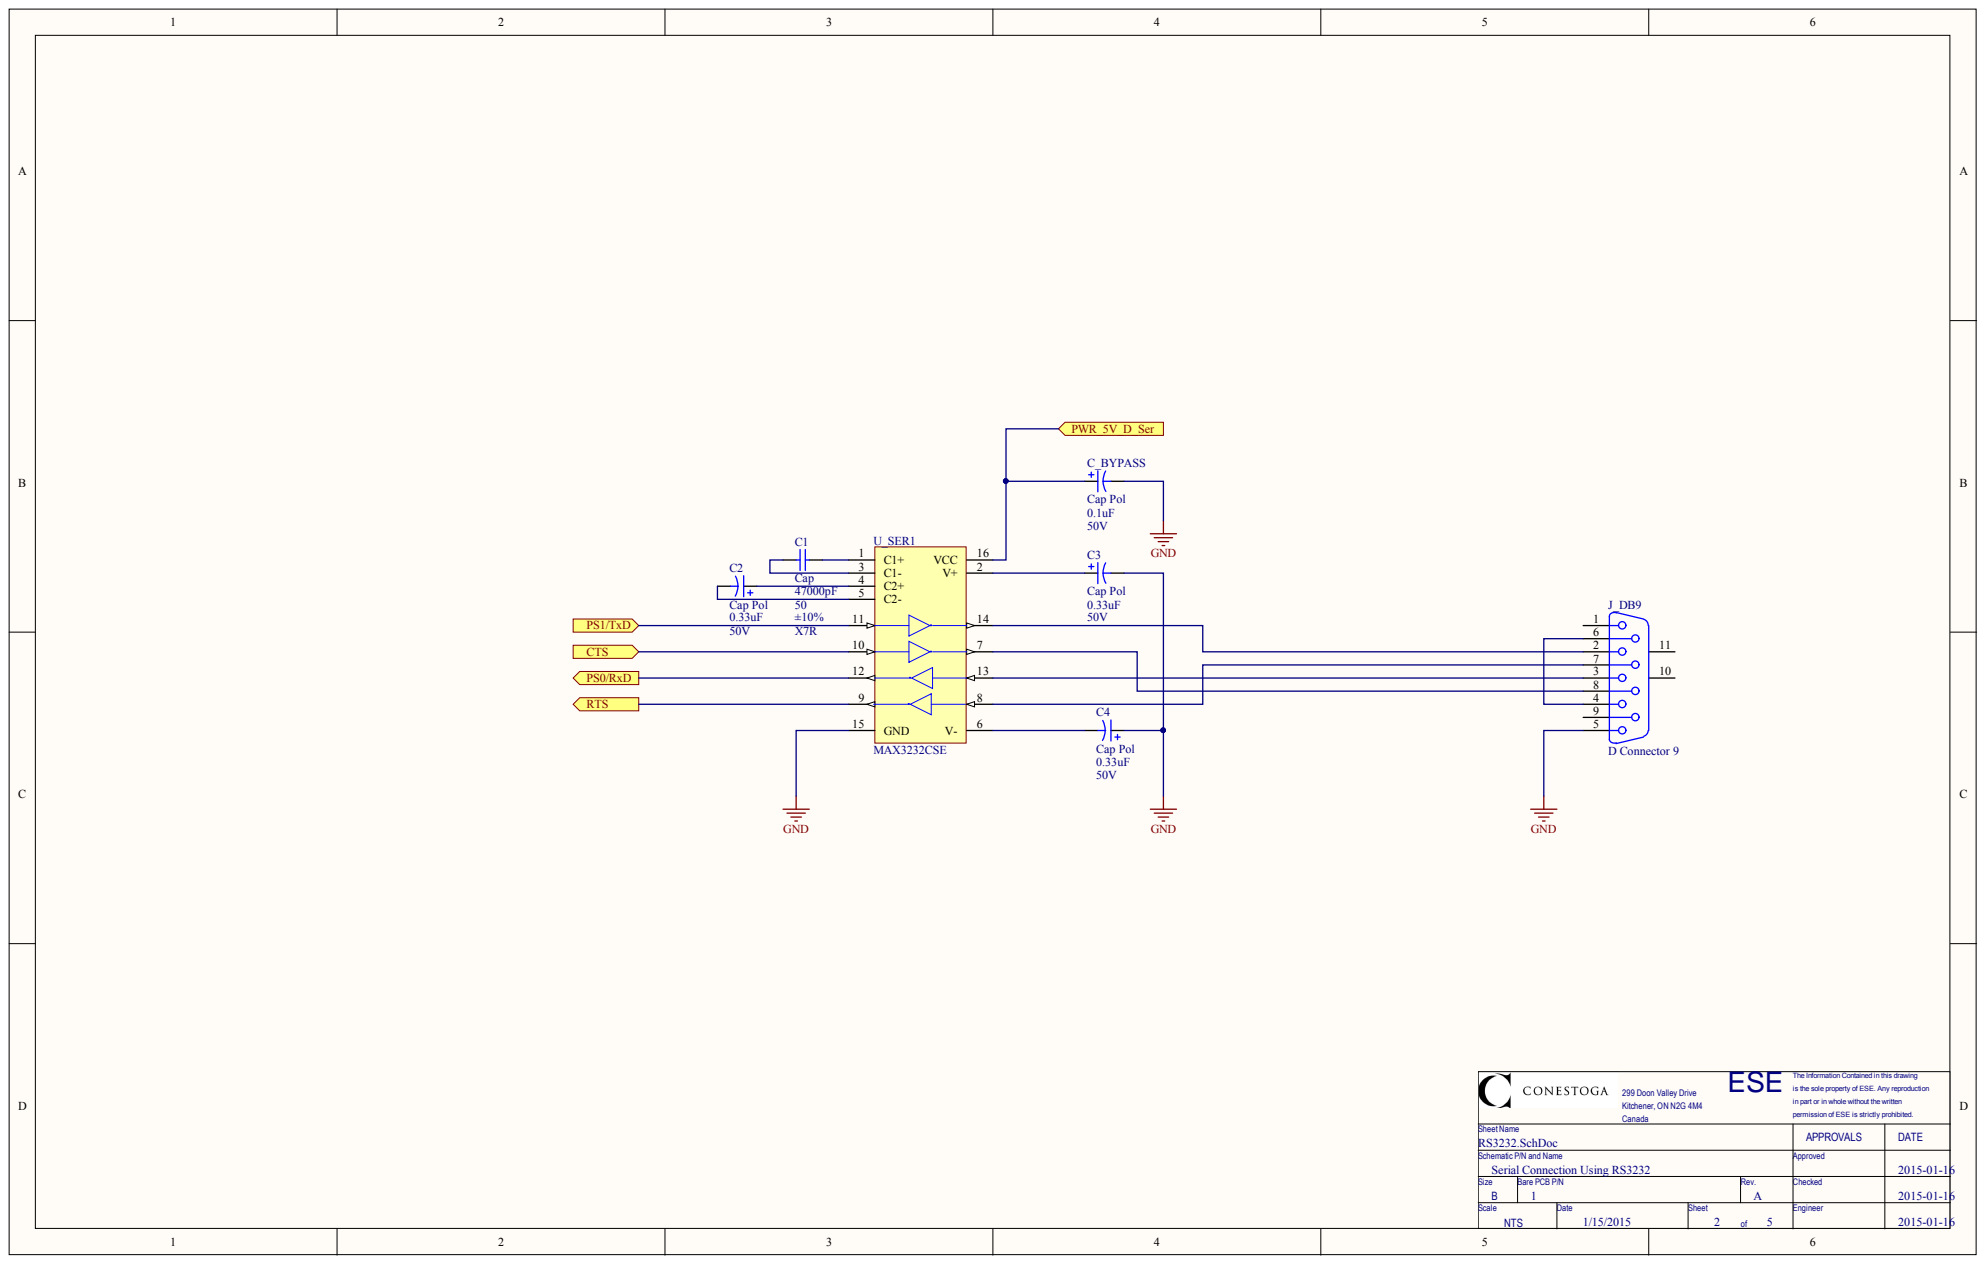
[picture p60: page 2]

of ESE. Any re

S h e e t Na m e RS3232.SchDoc | A P P ROVA L S | D AT E

S c h e m a t i c P /N a n d Na m e Ser ial Connect ion U s ing RS3232 | A p pro v e d | 2015-01-16

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

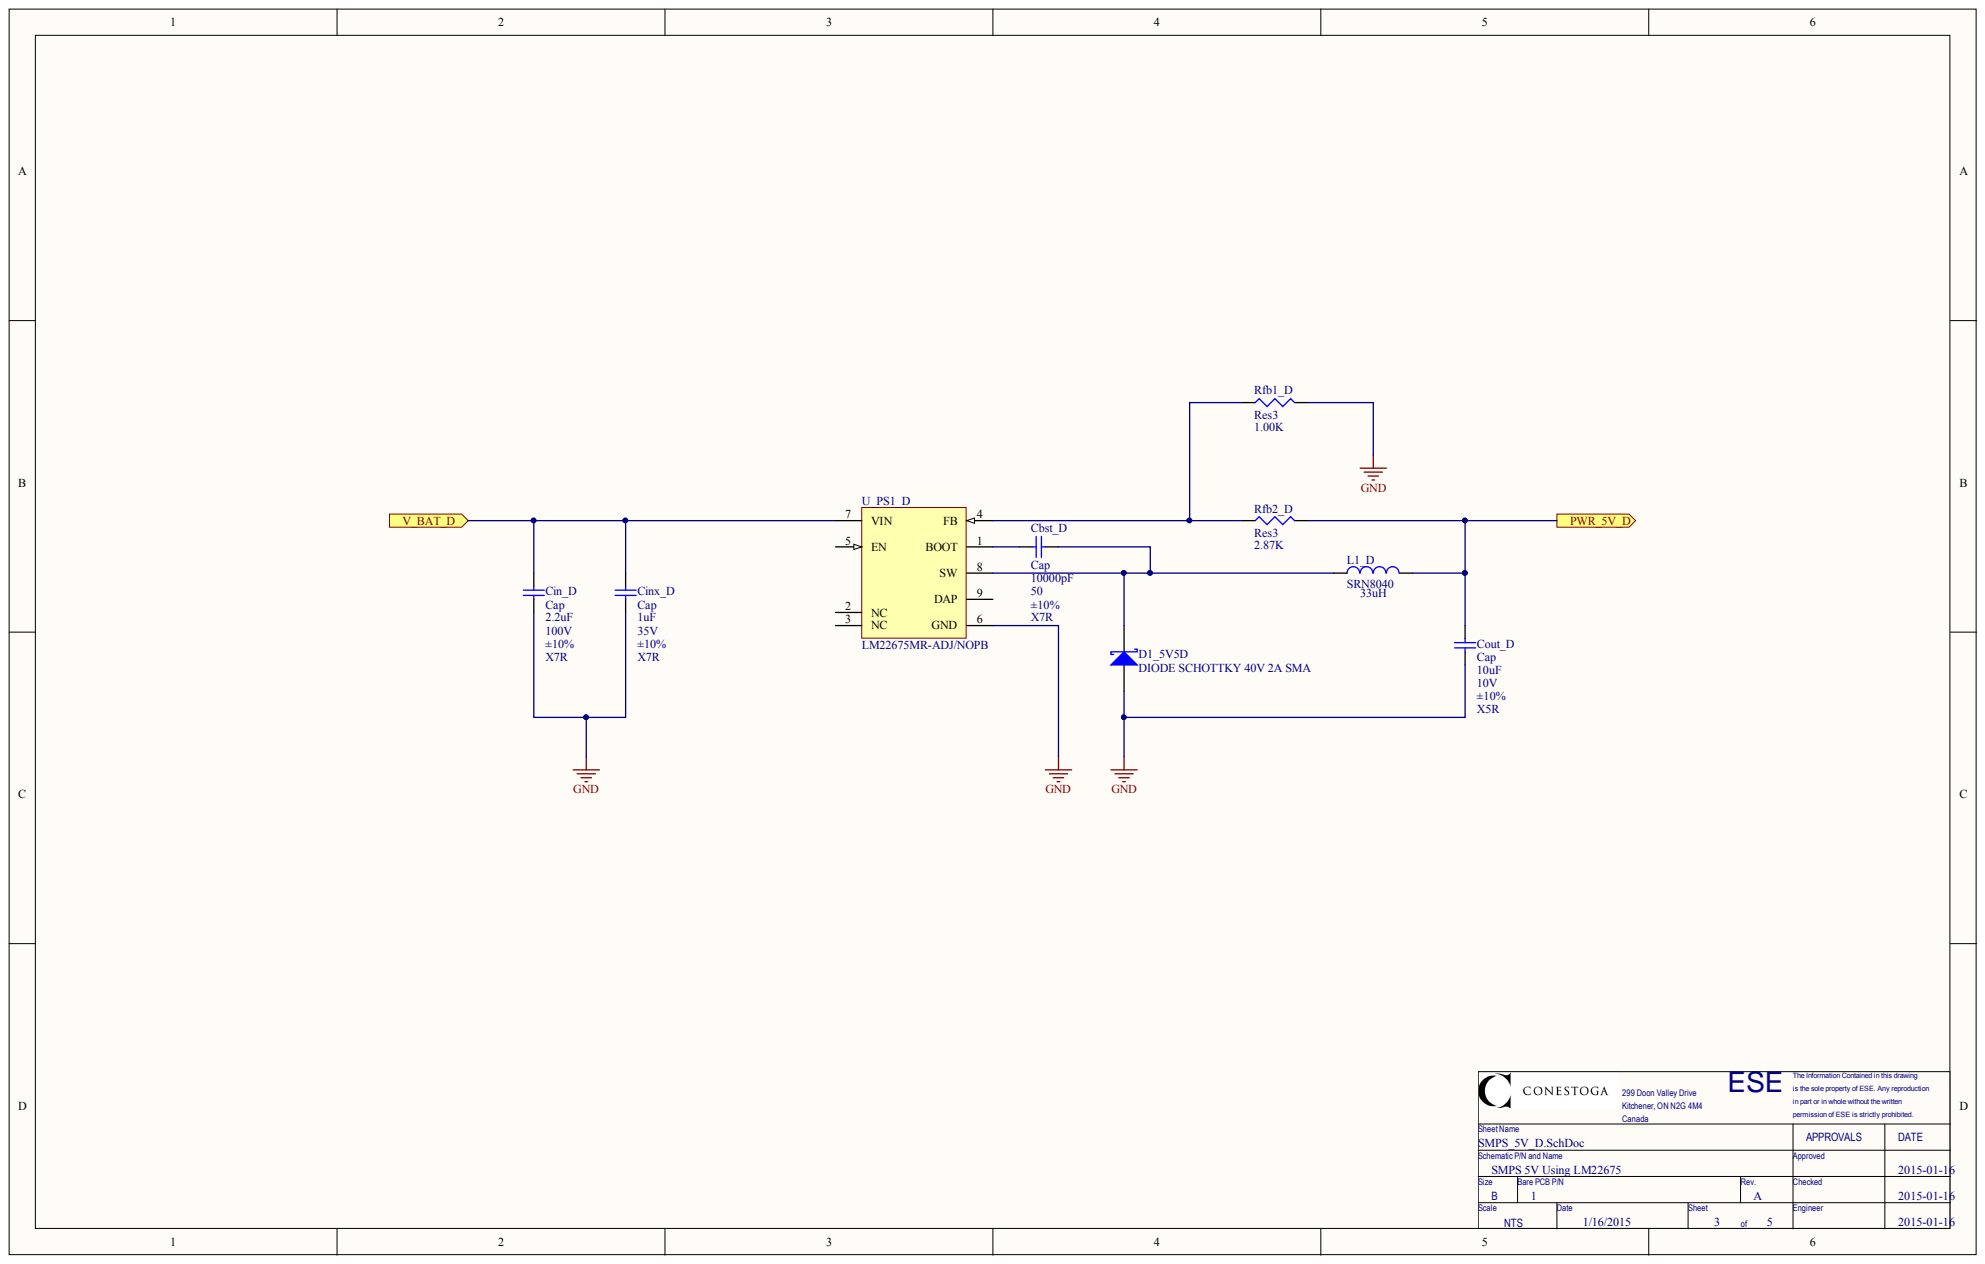
[picture p61: page 3]

of ESE. Any re

S h e e t Na m e SMPS_5V_D.SchDoc | A P P ROVA L S | D AT E

S c h e m a t i c P /N a n d Na m e SMPS 5V U s ing L M22675 | A p pro v e d | 2015-01-16

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

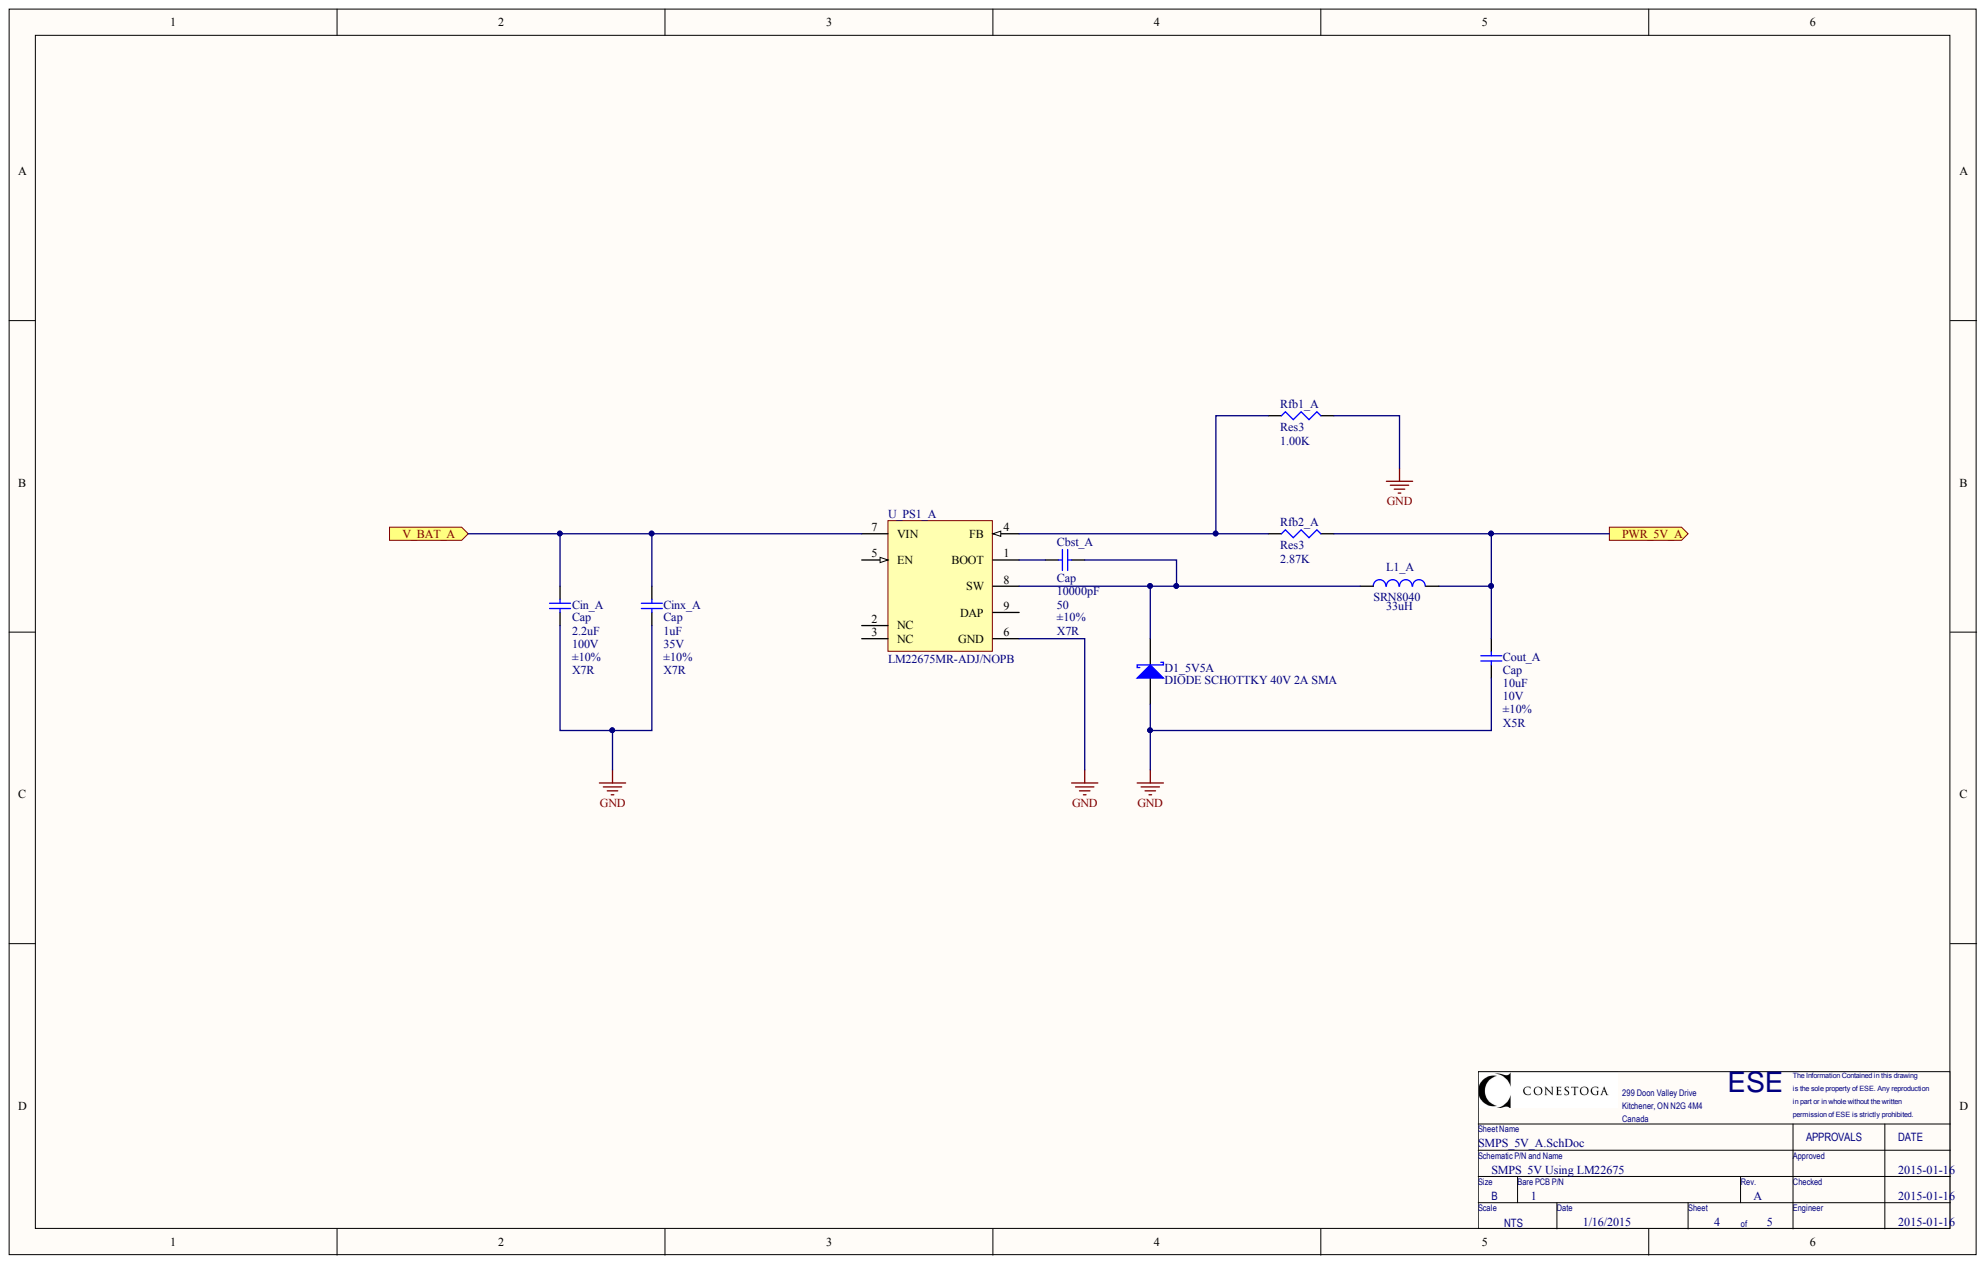
[picture p62: page 4]

of ESE. Any re

S h e e t Na m e SMPS_5V_A.SchDoc | A P P ROVA L S | D AT E

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

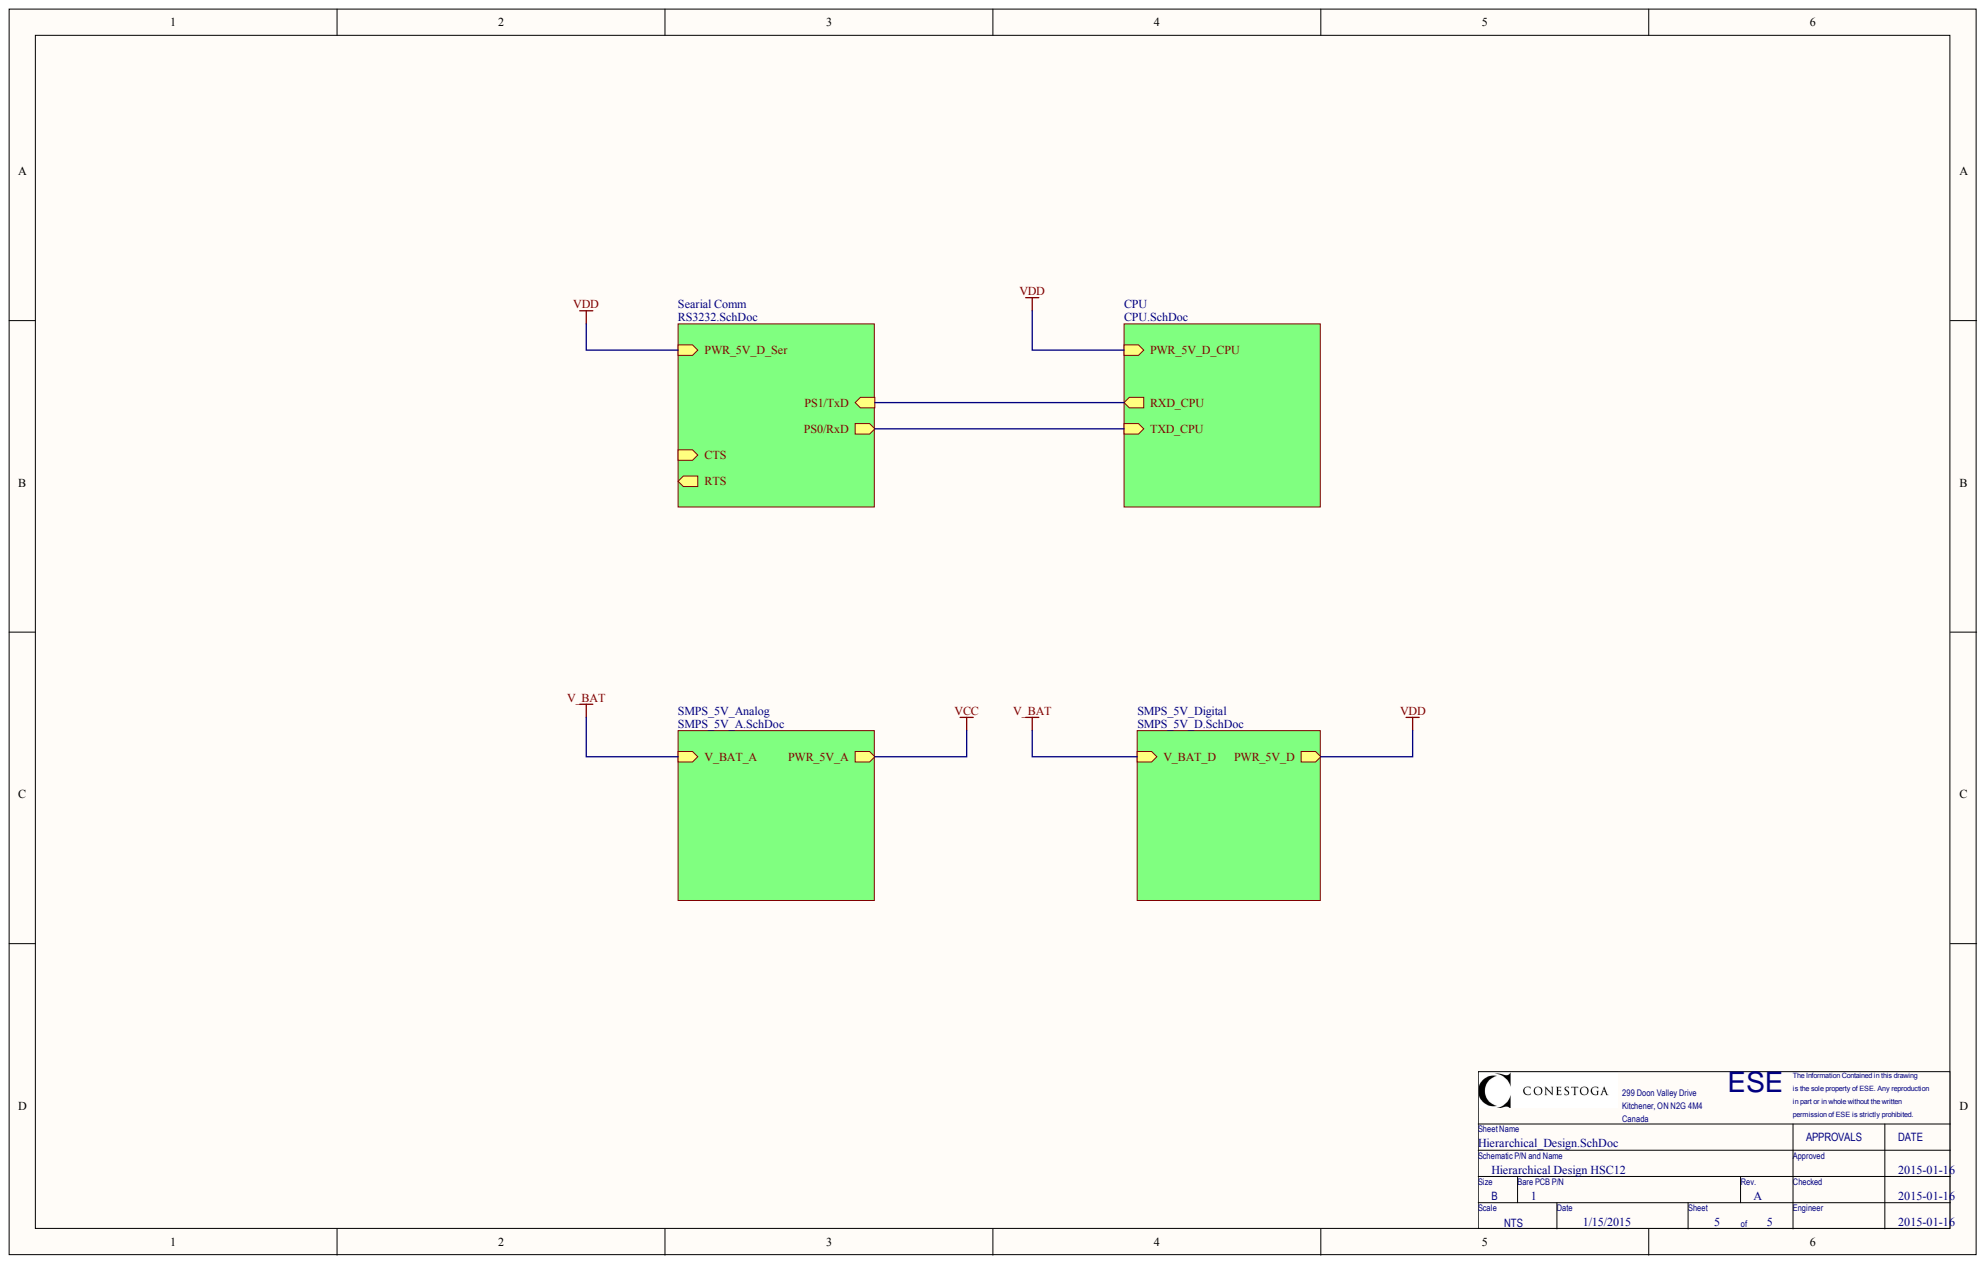
[picture p63: page 5]

ESE is the sole property of ESE. Any reproduction

The Information Contained in this drawing

in part or in whole without the written

permission of ESE is strictly prohibited.

Sheet Name Hierarchical_Design.SchDoc | APPROVALS | DATE

Schematic P/N and Name Hierarchical Design HSC12 | Approved | 2015-01-16

Size B | Bare PCB P/N 1 | Rev. A | Checked | 2015-01-16

Scale NTS | Date 1/15/2015 | Sheet 5 of 5 | Engineer | 2015-01-16
