CircuitBreaker437/HCS12_Robot/Schematic/Design_Rev_PDF/Jan23/PCB_Project4_RevA_Marcin Czajkowski_Jan23.pdf

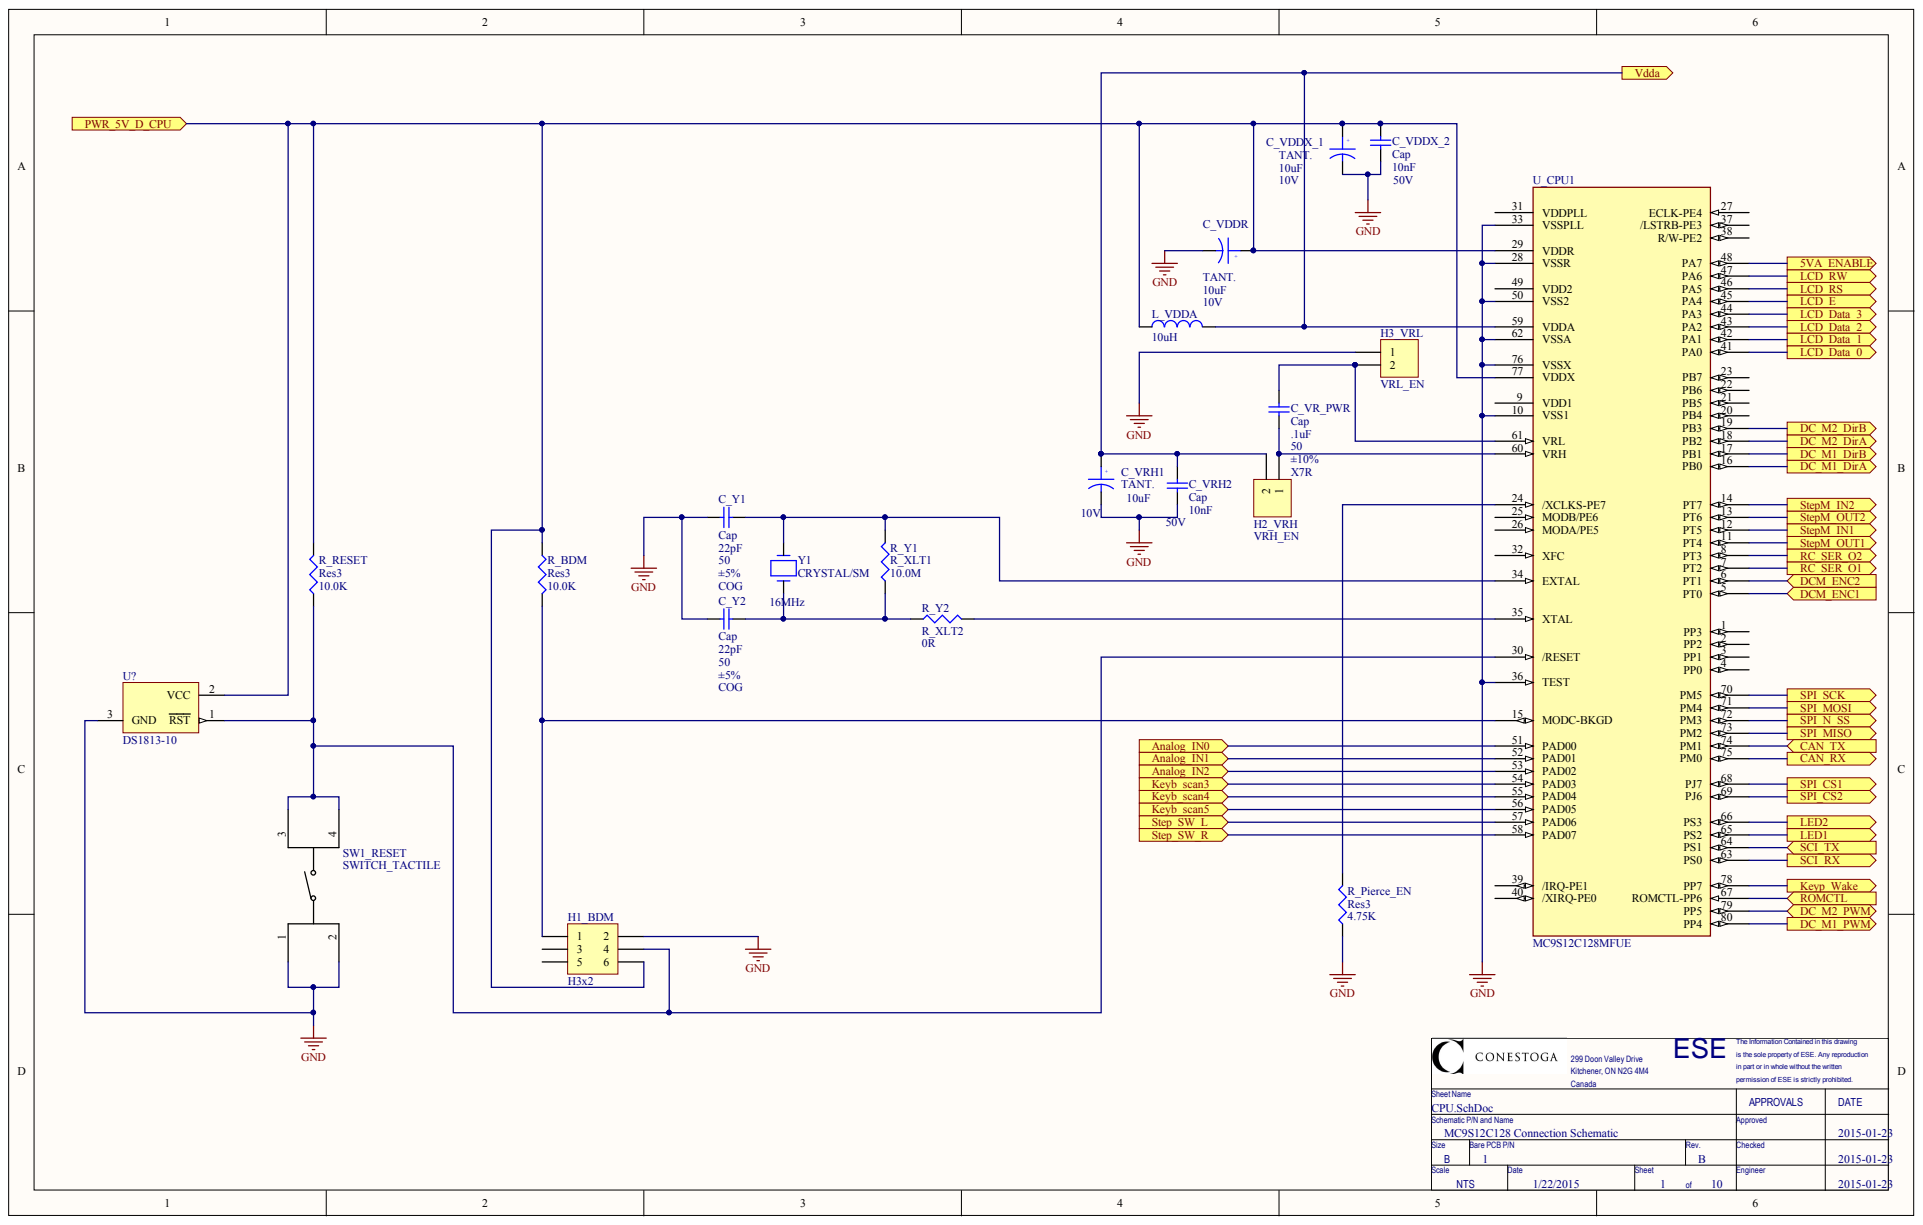
[picture p64: page 1]

10.0K R_BD M Res 3

of ESE. Any re

S h e e t Na m e | A P P ROVA L S | D AT E
CPU.SchDoc MC9S12C128 Connect S c h e m a t i c P /N a n d Na m e ion Schemat i c | A p pro v e d | 2015-01-23

S i z e B | B are PCB P / N 1 | Re v . B | Ch e c k e d | 2015-01-23


of ESE. Any re

S h e e t Na m e RS3232.SchDoc | A P P ROVA L S | D AT E

S c h e m a t i c P /N a n d Na m e Ser ial Connect ion U s ing RS3232 | A p pro v e d | 2015-01-16

S i z e B | B are PCB P / N 1 | Re v . A | Ch e c k e d | 2015-01-16

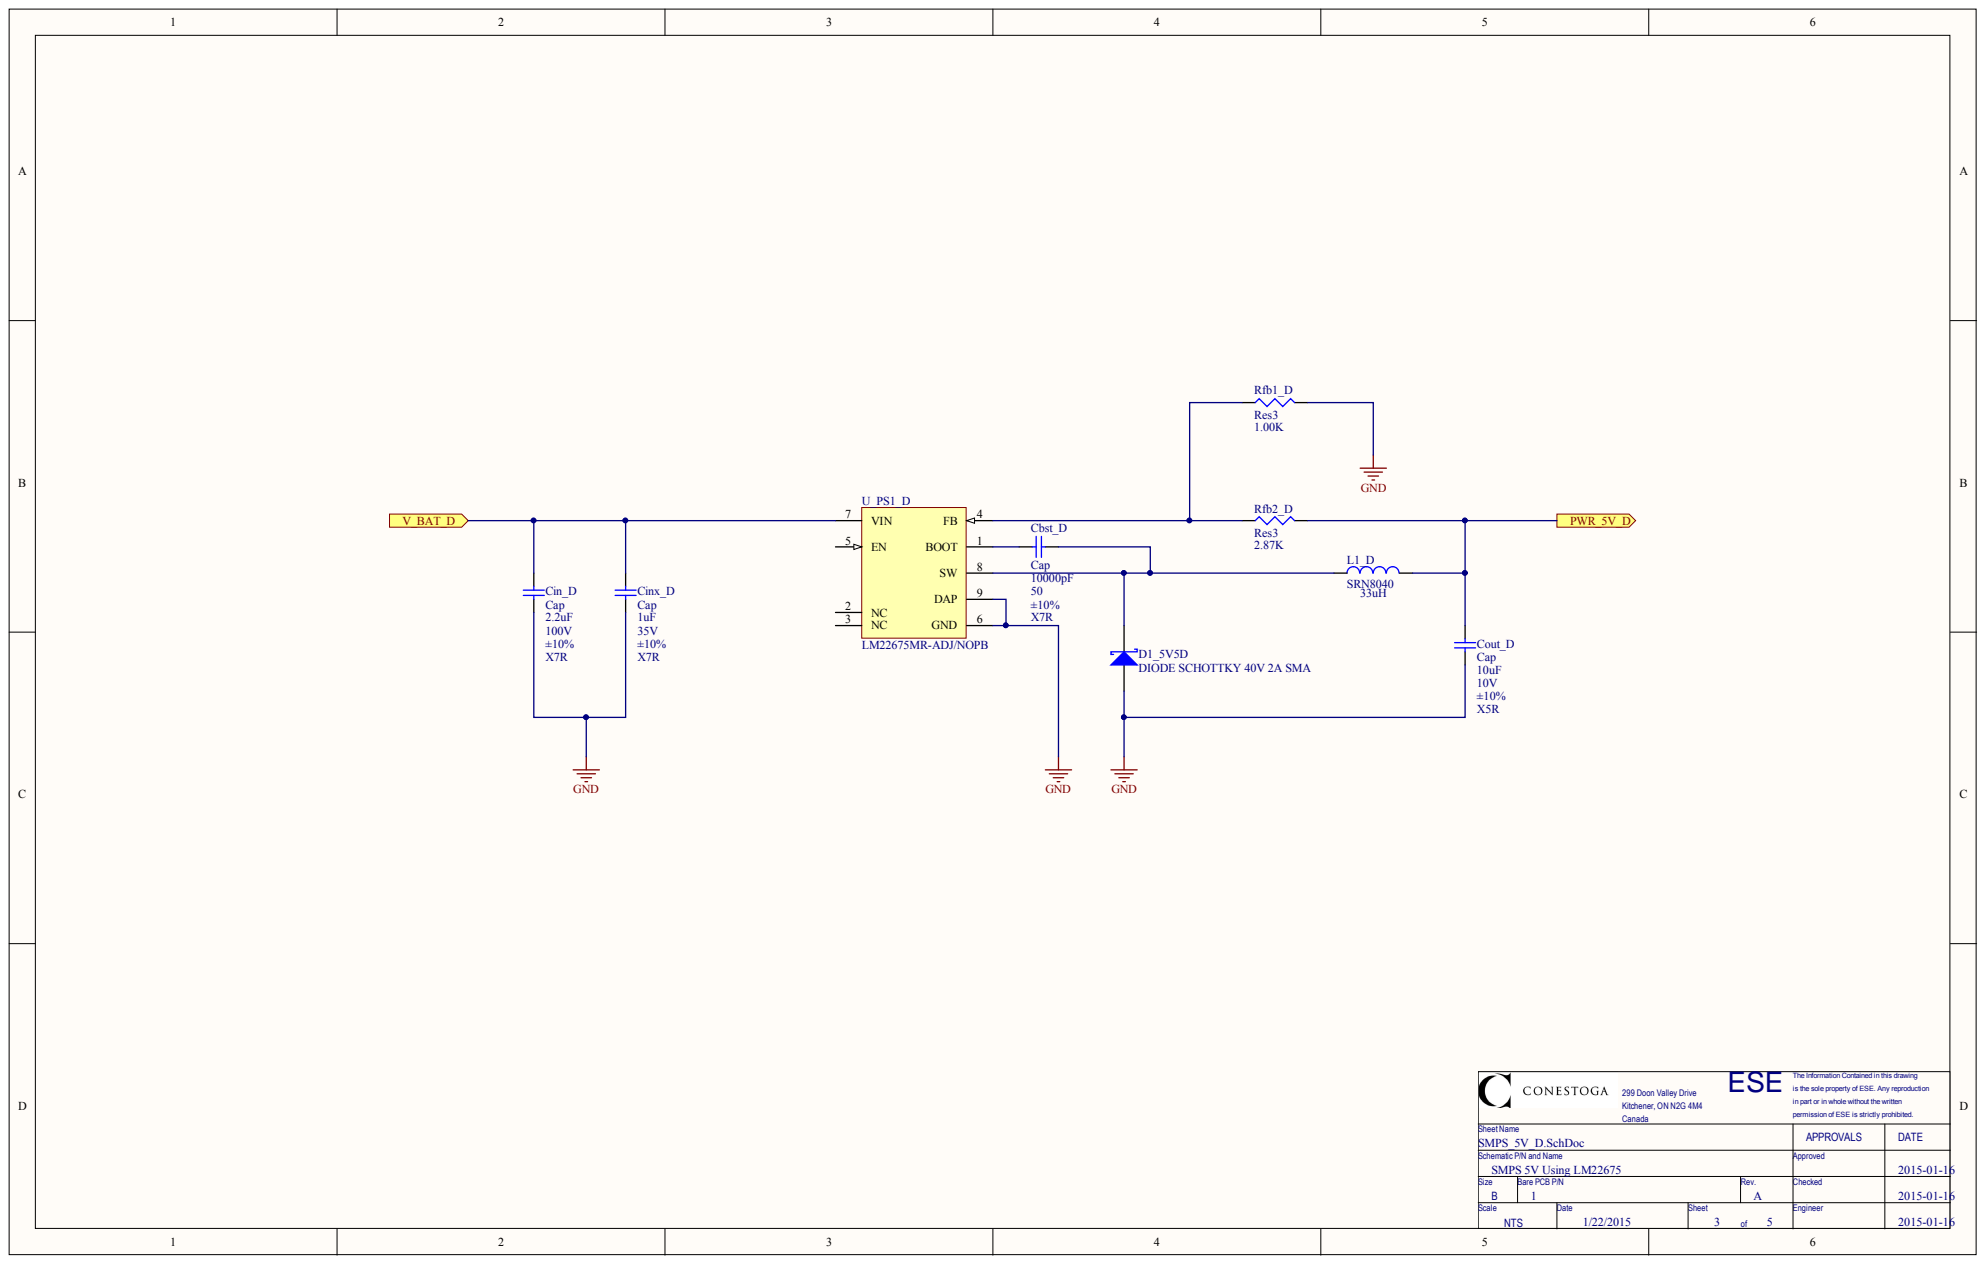
[picture p65: page 3]

of ESE. Any re

S h e e t Na m e SMPS_5V_D.SchDoc | A P P ROVA L S | D AT E

S c h e m a t i c P /N a n d Na m e SMPS 5V U s ing L M22675 | A p pro v e d | 2015-01-16

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

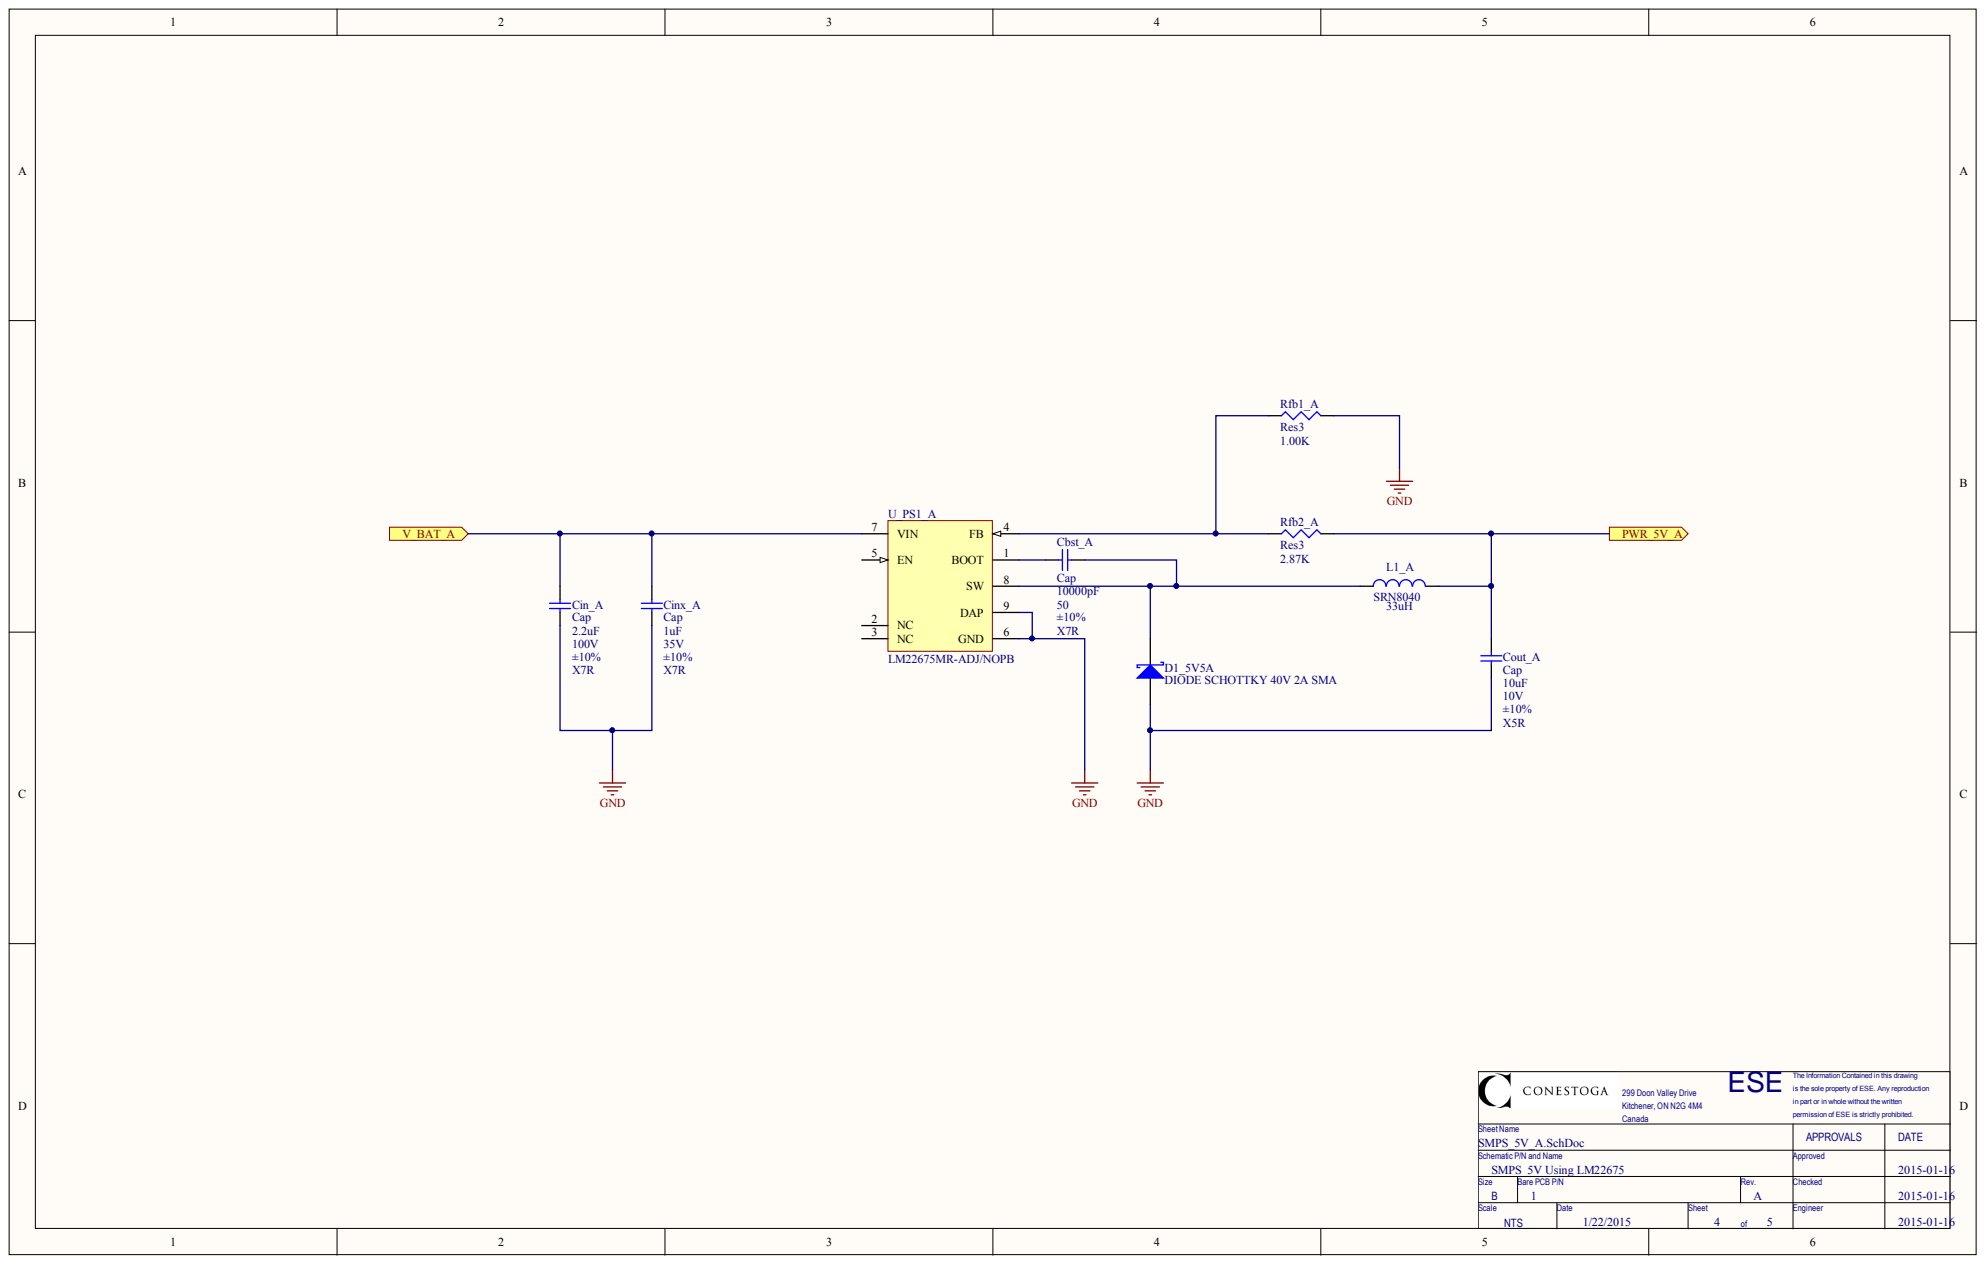
[picture p66: page 4]

of ESE. Any re

S h e e t Na m e SMPS_5V_A.SchDoc | A P P ROVA L S | D AT E

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

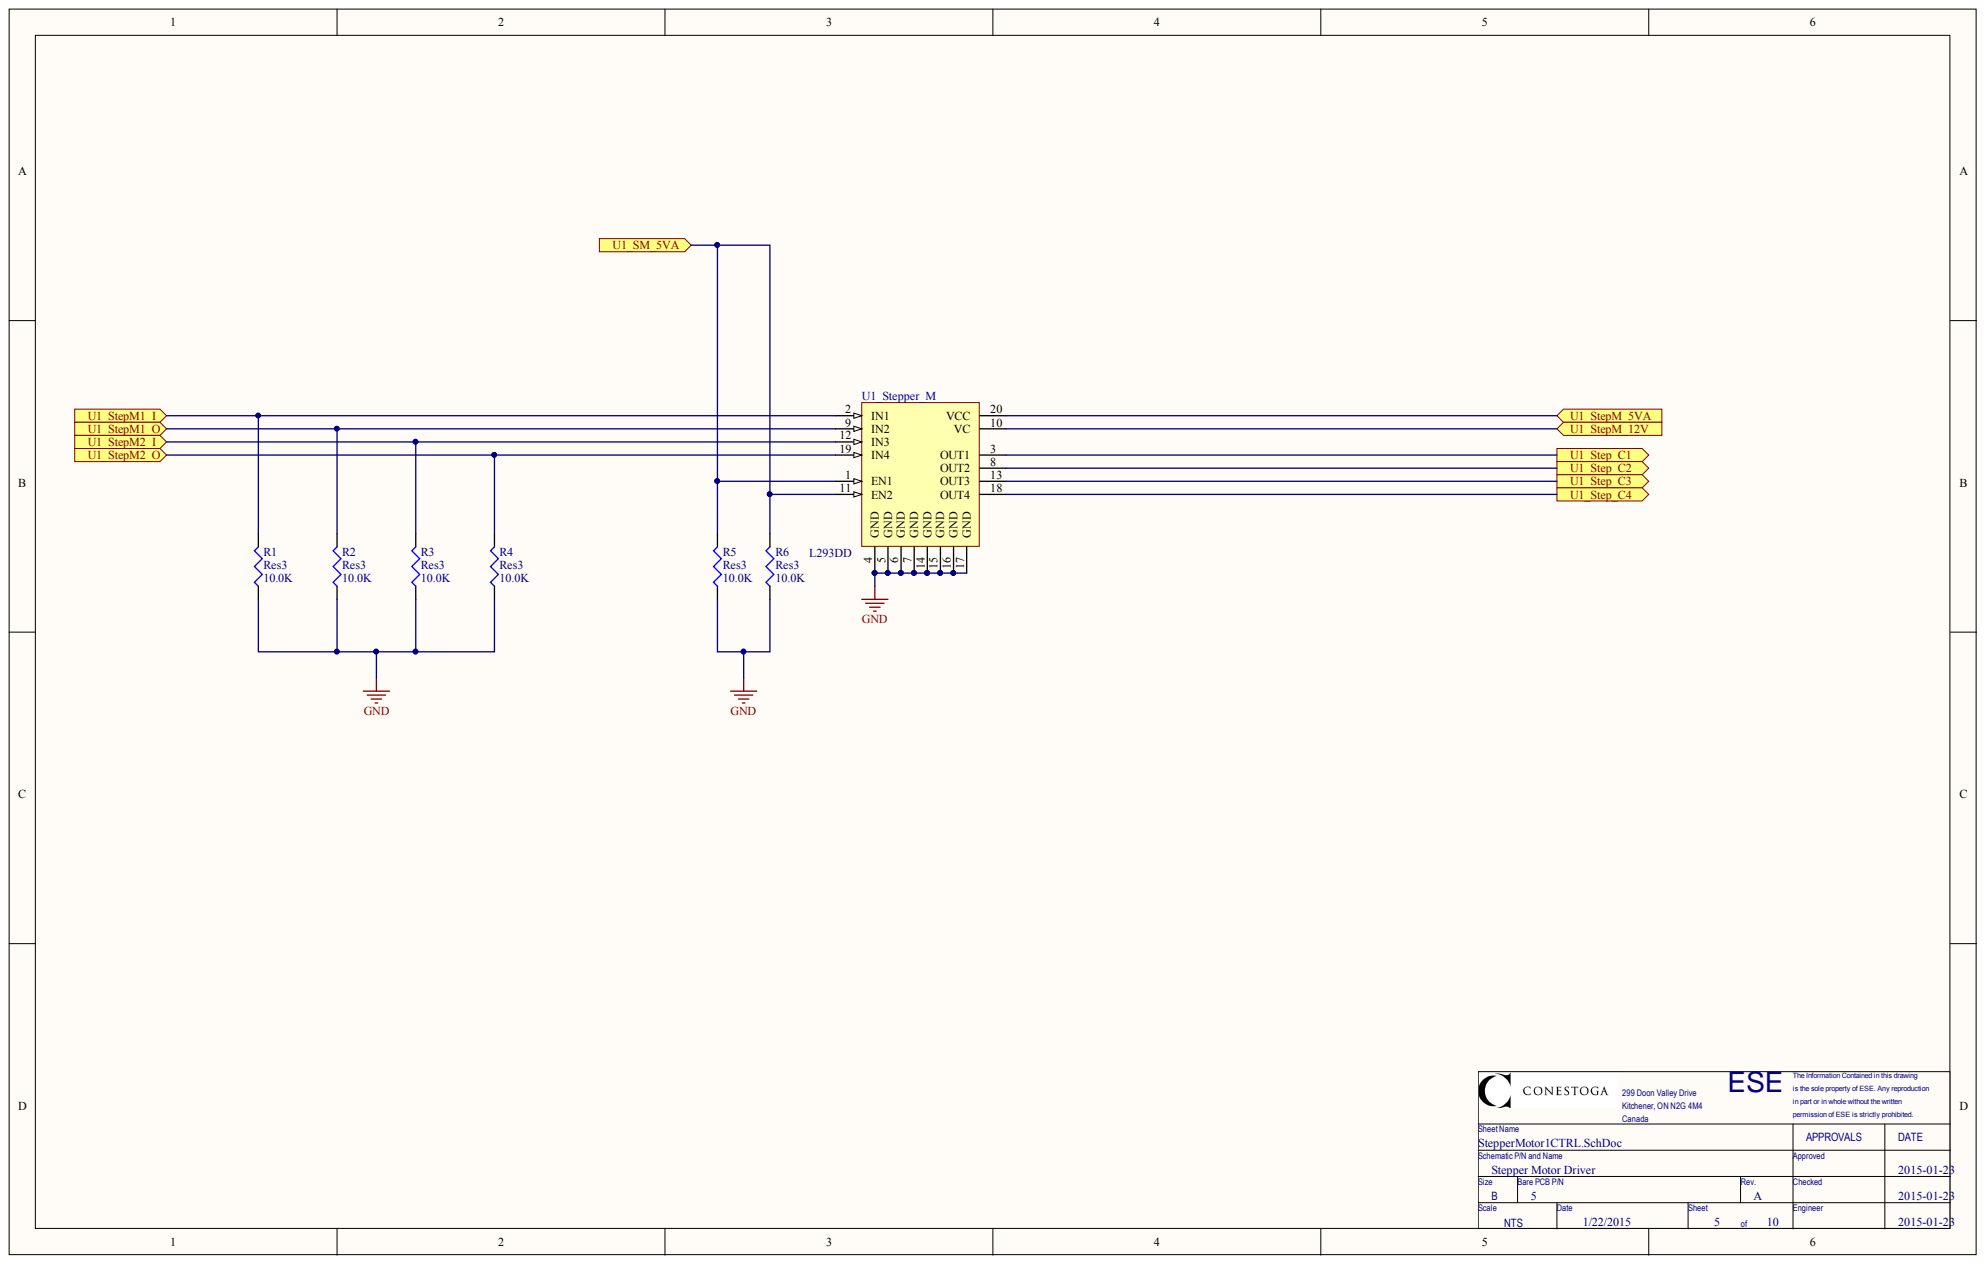
[picture p67: page 5]

of ESE. Any re

S h e e t Na m e Stepper Motor1C T RL.SchDoc | A P P ROVA L S | D AT E

S c h e m a t i c P /N a n d Na m e Stepper Motor D r iver | A p pro v e d | 2015-01-23

S i z e B | B are PCB P / N 5 | Re v . A | Ch e c k e d | 2015-01-23

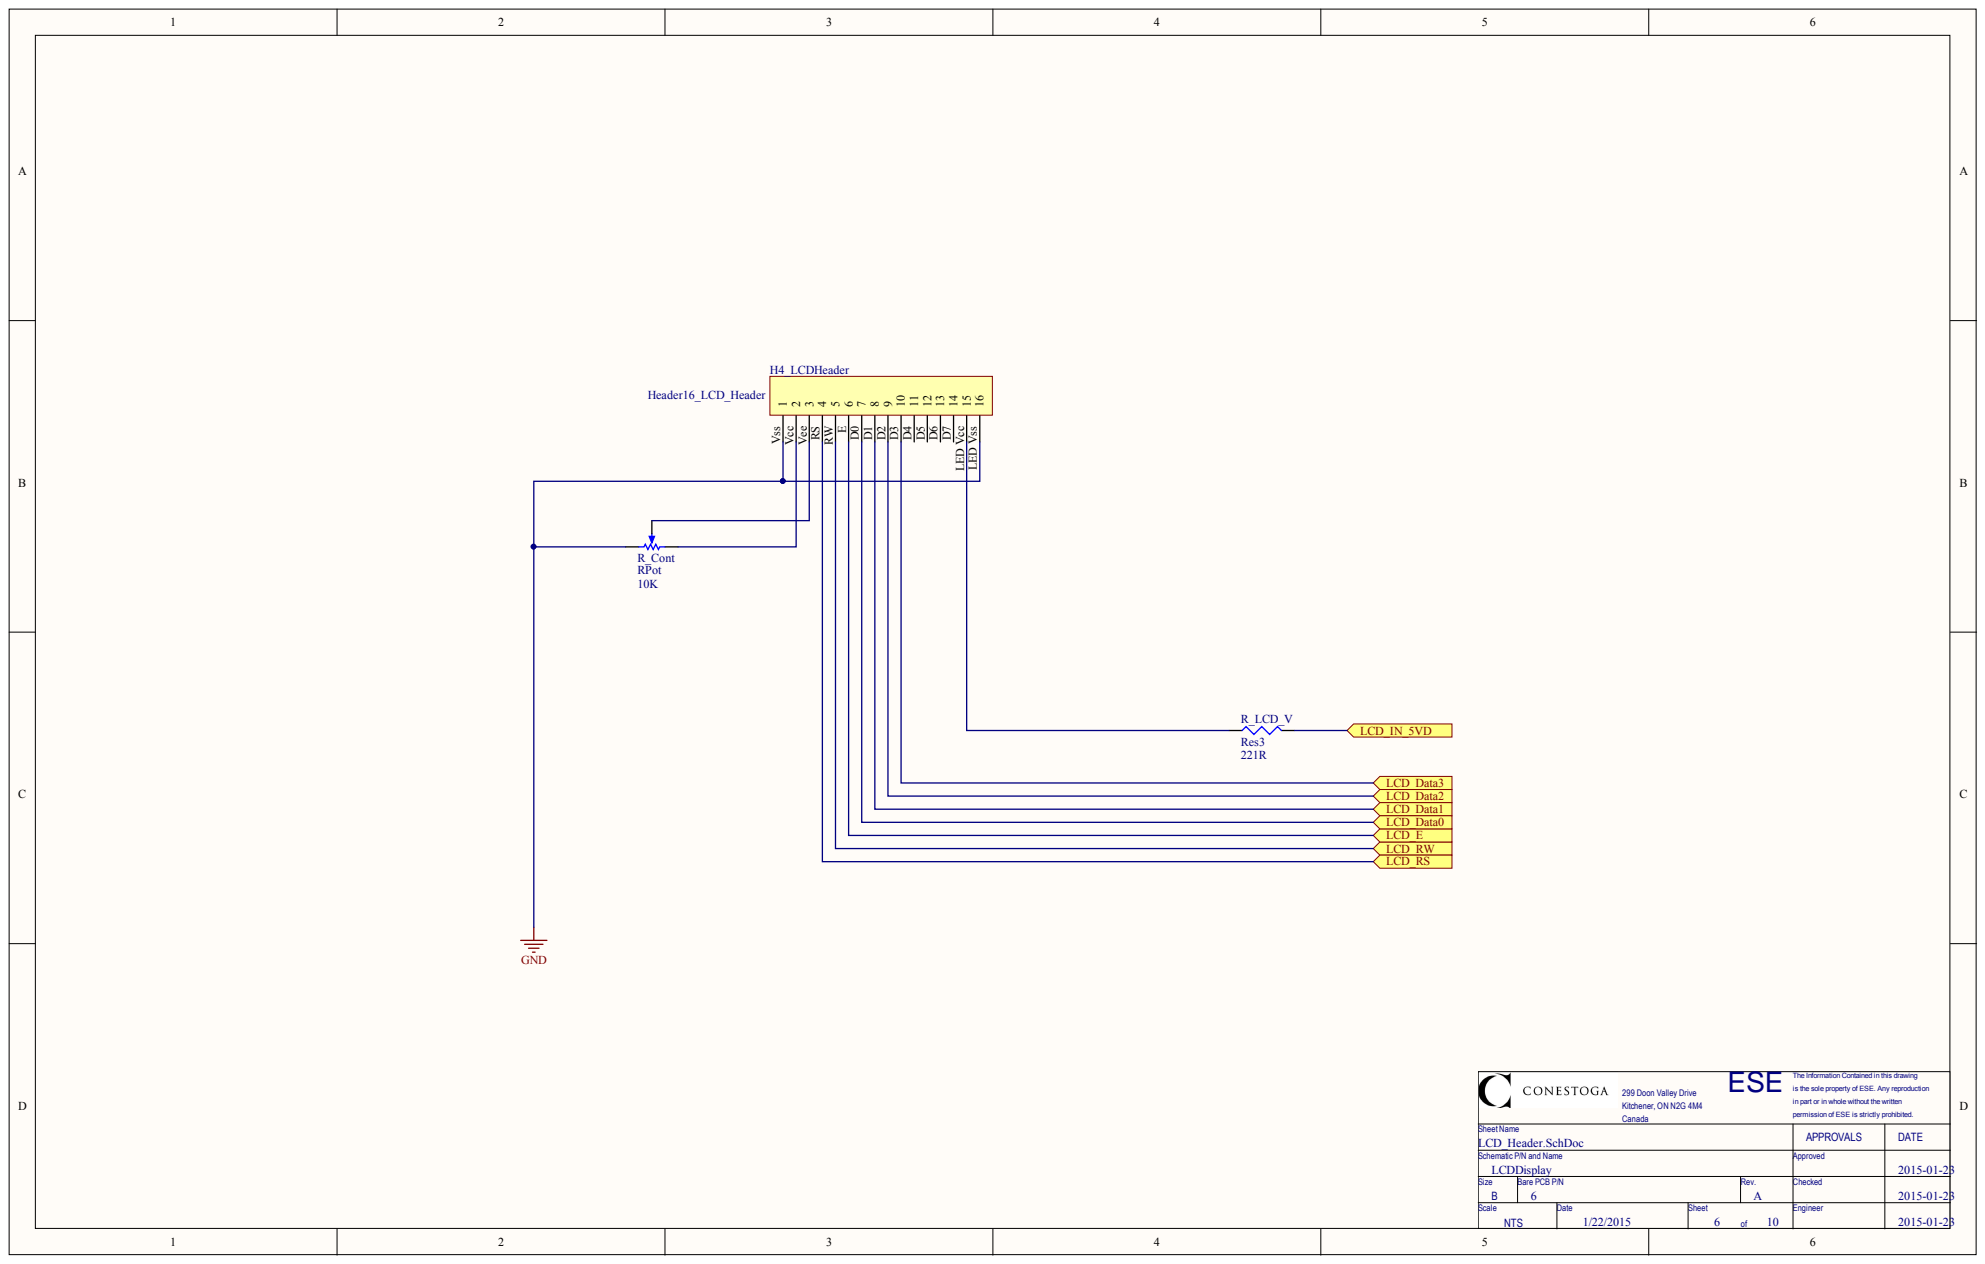
[picture p68: page 6]

ESE is the sole property of ESE. Any reproduction

The Information Contained in this drawing

in part or in whole without the written

permission of ESE is strictly prohibited.

Sheet Name LCD_Header.SchDoc | APPROVALS | DATE

Schematic P/N and Name LCDDisplay | Approved | 2015-01-23

Size B | Bare PCB P/N 6 | Rev. A | Checked | 2015-01-23

Scale NTS | Date 1/22/2015 | Sheet 6 of 10 | Engineer | 2015-01-23

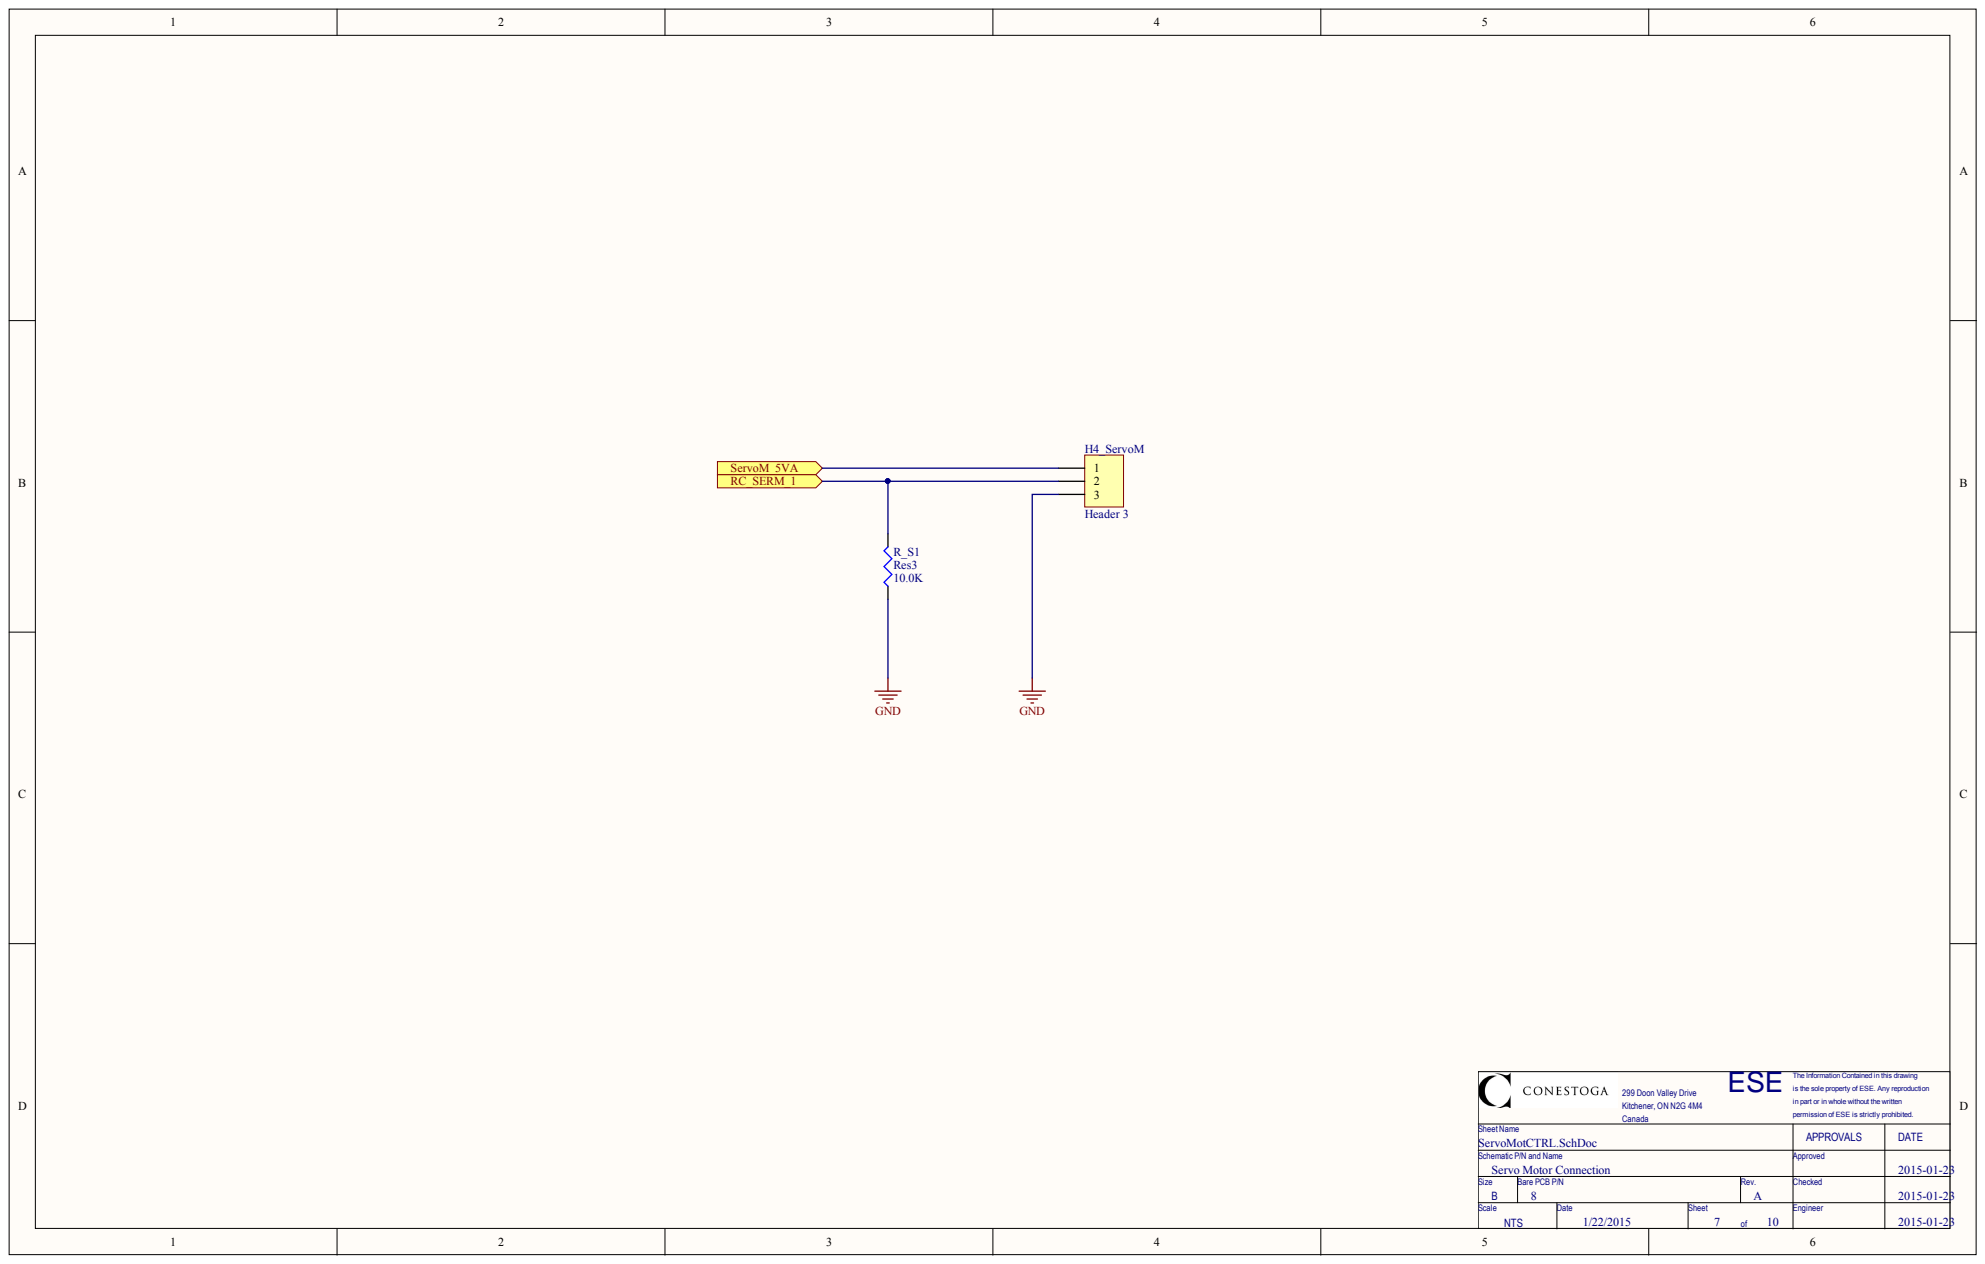
[picture p69: page 7]

ESE is the sole property of ESE. Any reproduction

The Information Contained in this drawing

in part or in whole without the written

permission of ESE is strictly prohibited.

Sheet Name ServoMotCTRL.SchDoc | APPROVALS | DATE

Schematic P/N and Name Servo Motor Connection | Approved | 2015-01-23

Size B | Bare PCB P/N 8 | Rev. A | Checked | 2015-01-23

Scale NTS | Date 1/22/2015 | Sheet 7 of 10 | Engineer | 2015-01-23

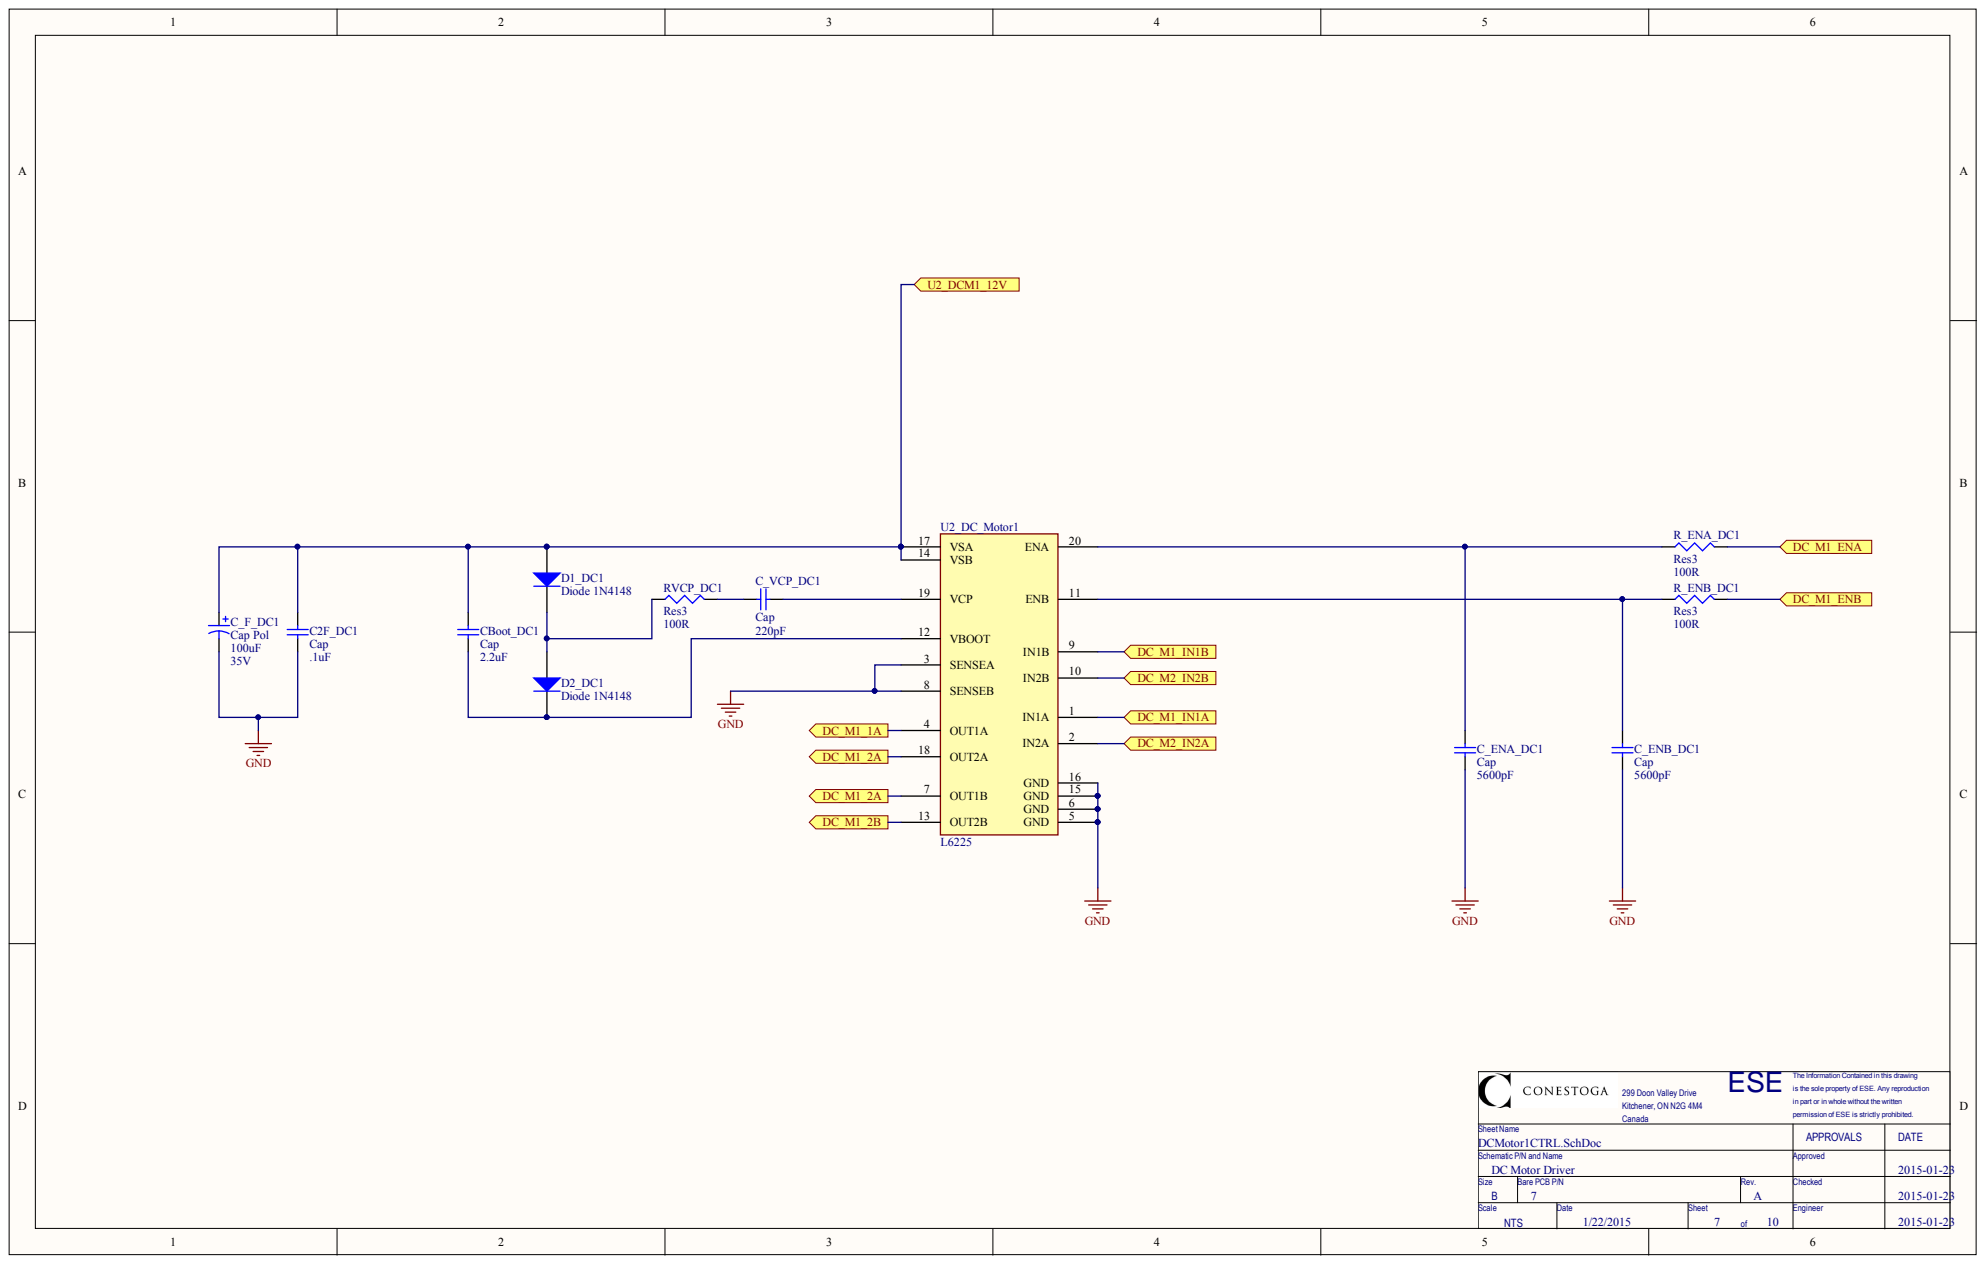
[picture p70: page 8]

ESE is the sole property of ESE. Any reproduction

The Information Contained in this drawing

in part or in whole without the written

permission of ESE is strictly prohibited.

Sheet Name DCMotor1CTRL.SchDoc | APPROVALS | DATE

Schematic P/N and Name DC Motor Driver | Approved | 2015-01-23

Size B | Bare PCB P/N 7 | Rev. A | Checked | 2015-01-23

Scale NTS | Date 1/22/2015 | Sheet 7 of 10 | Engineer | 2015-01-23

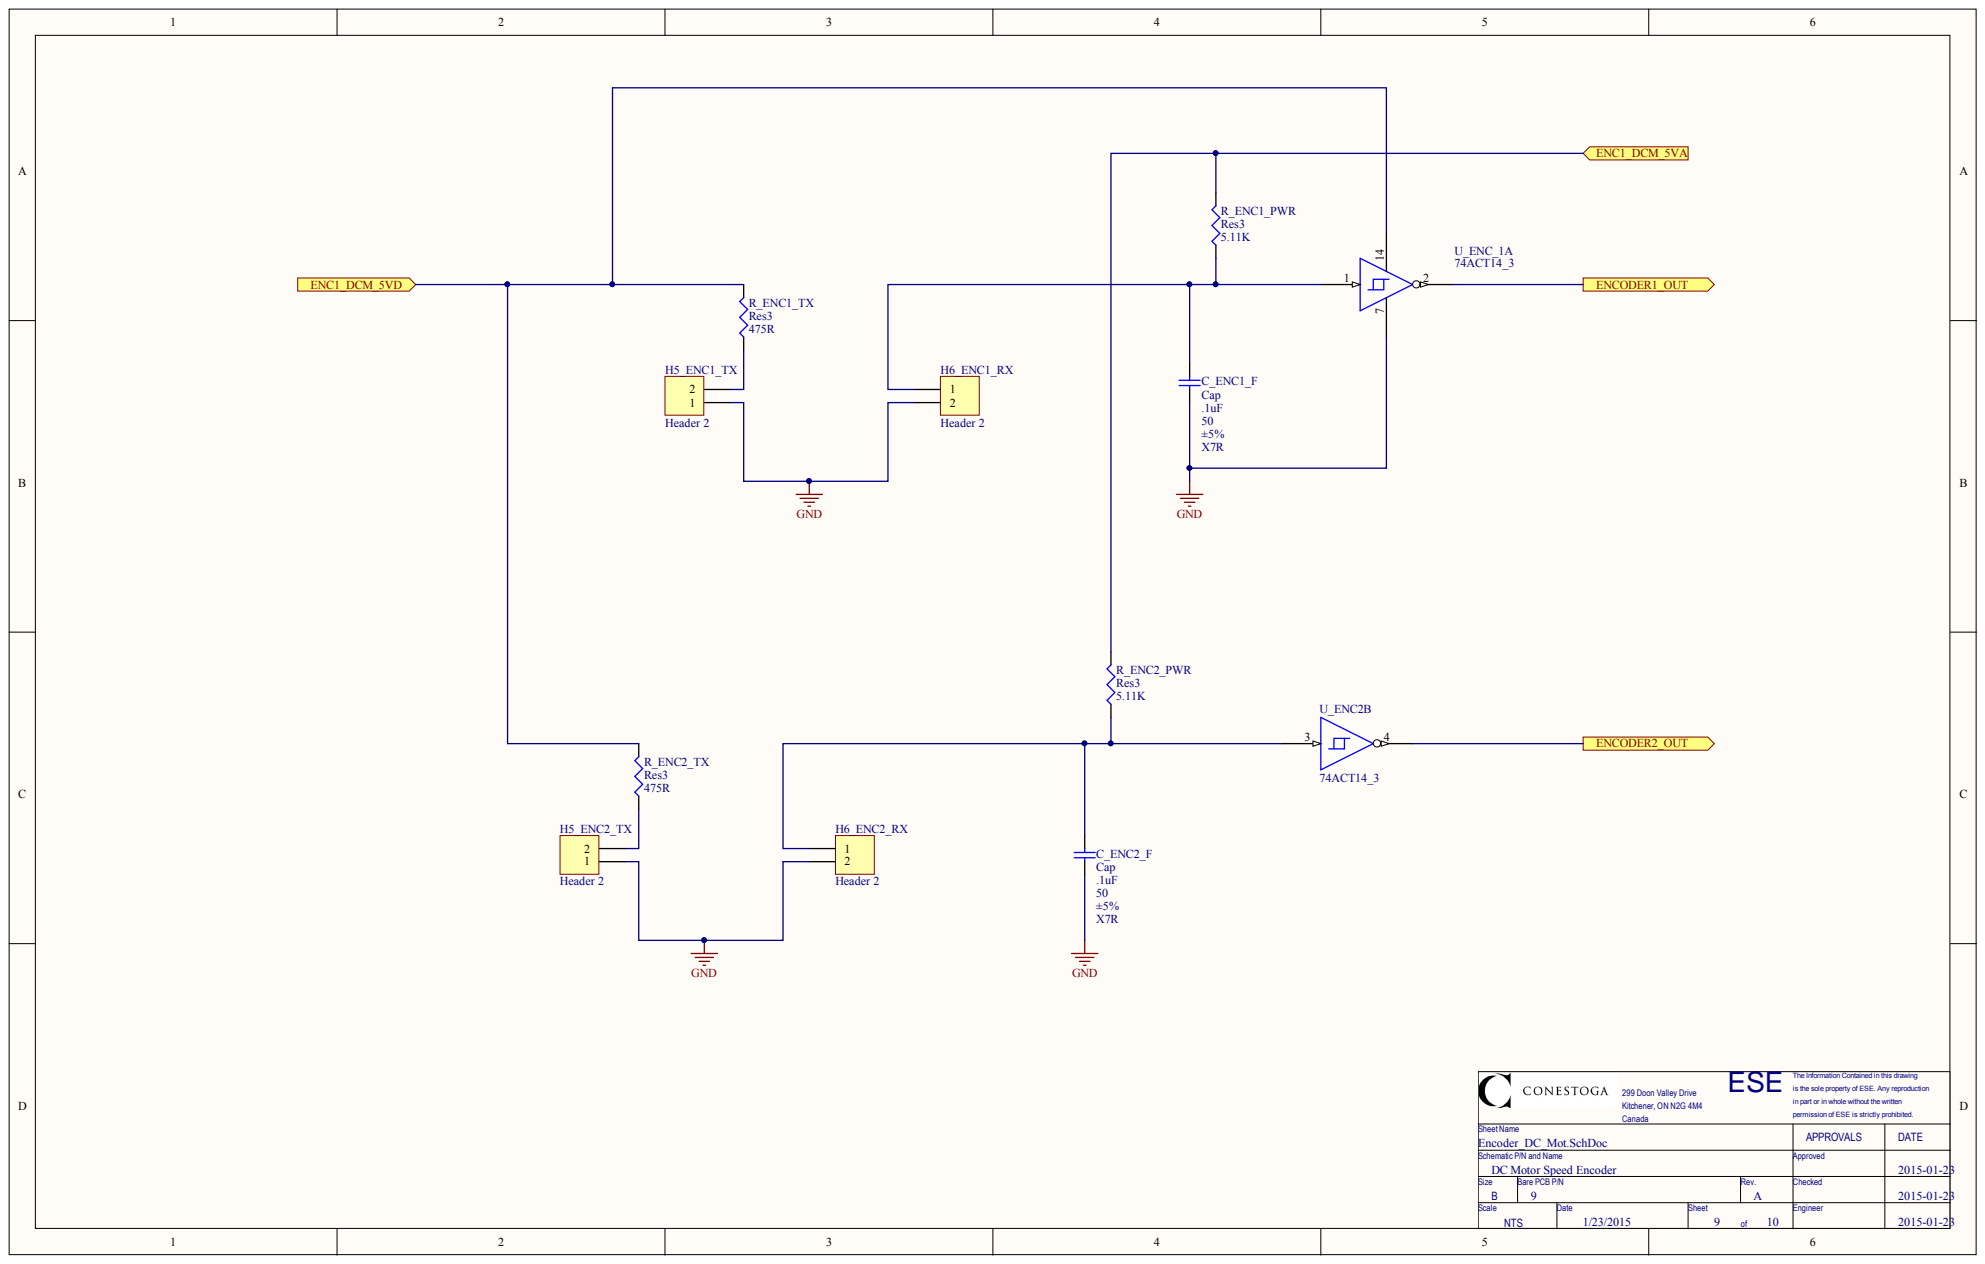
[picture p71: page 9]

ESE is the sole property of ESE. Any reproduction

The Information Contained in this drawing

in part or in whole without the written

permission of ESE is strictly prohibited.

Sheet Name Encoder_DC_Mot.SchDoc | APPROVALS | DATE

Schematic P/N and Name DC Motor Speed Encoder | Approved | 2015-01-23

Size B | Bare PCB P/N 9 | Rev. A | Checked | 2015-01-23

Scale NTS | Date 1/23/2015 | Sheet 9 of 10 | Engineer | 2015-01-23

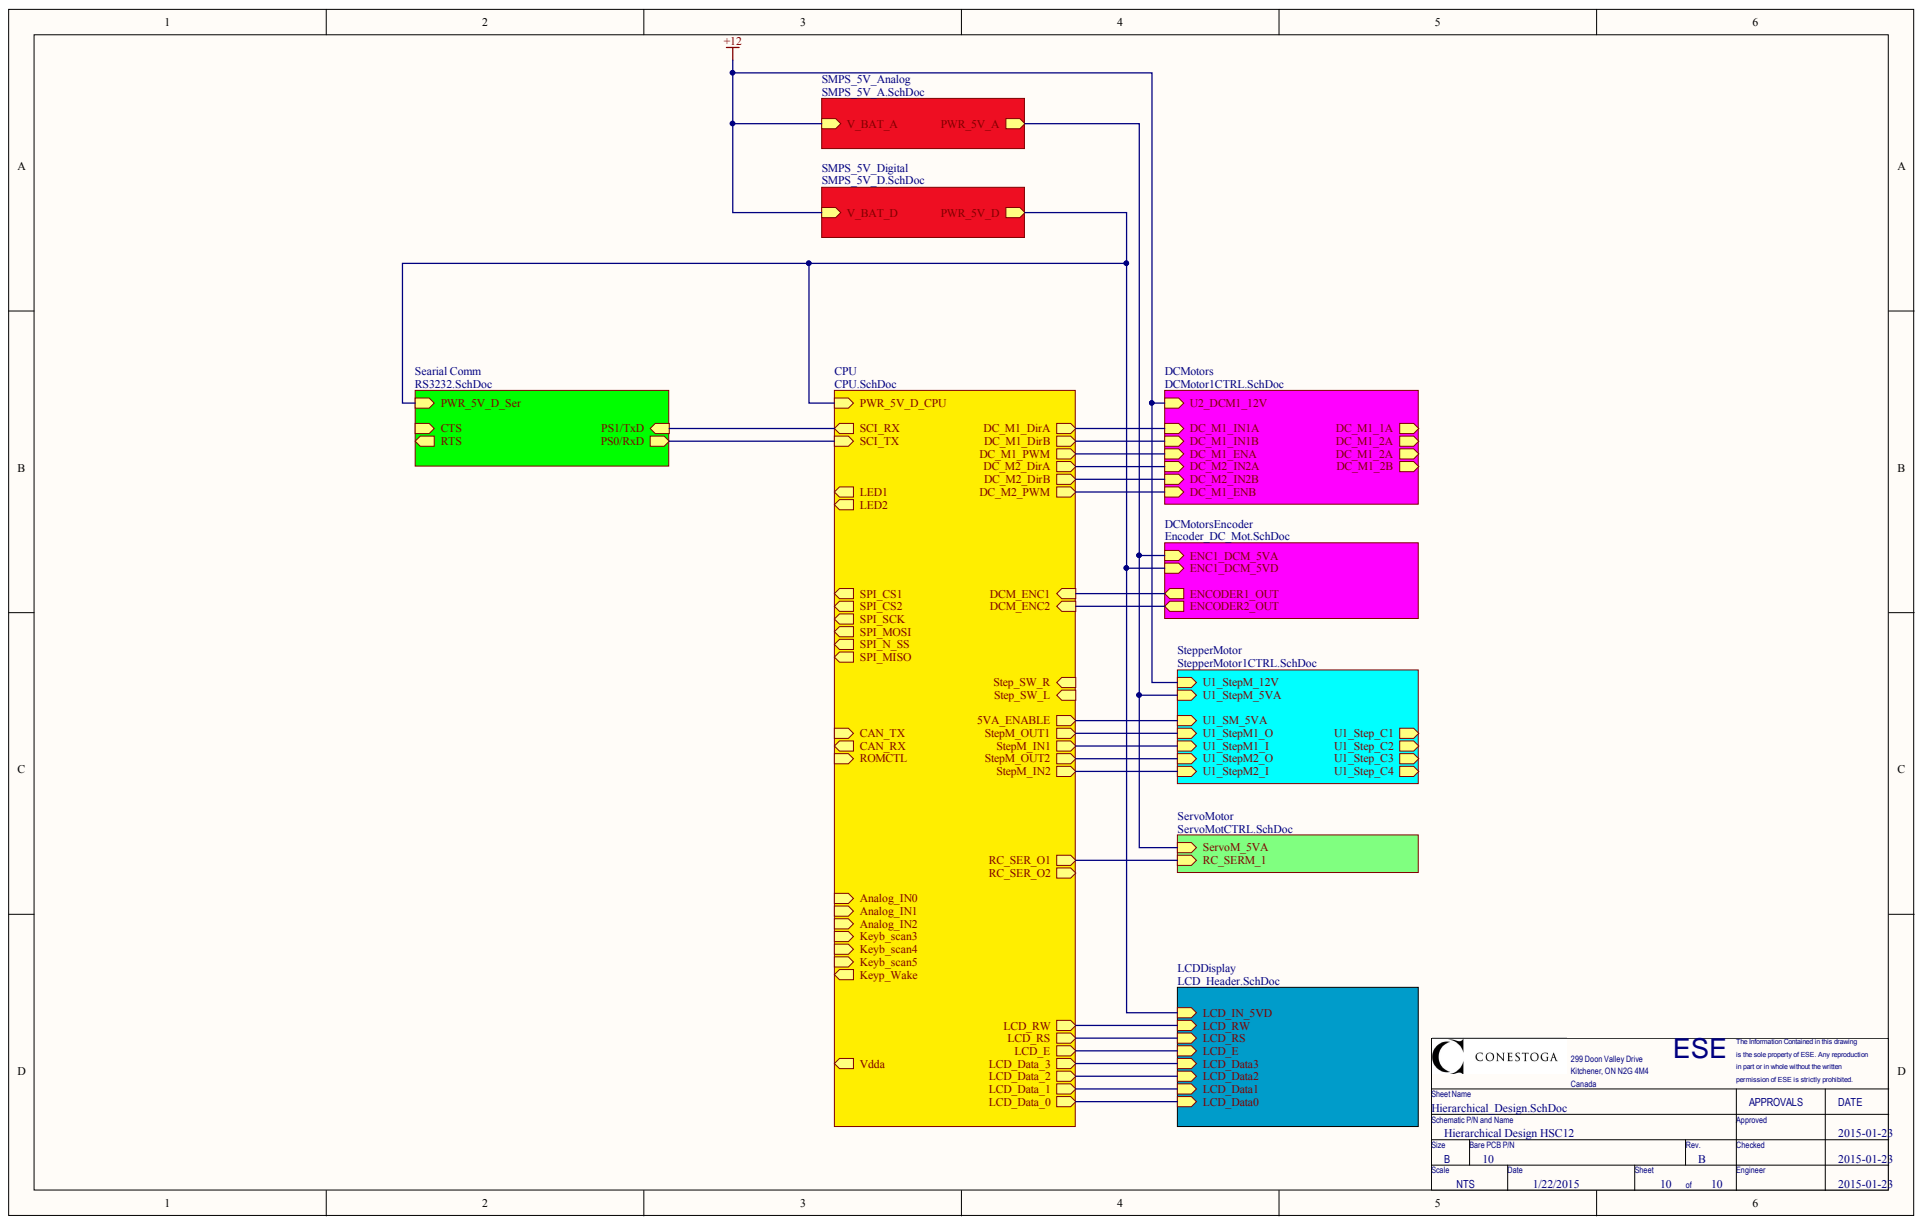
[picture p72: page 10]

ESE is the sole property of ESE. Any reproduction

The Information Contained in this drawing

in part or in whole without the written

permission of ESE is strictly prohibited.

Sheet Name Hierarchical_Design.SchDoc | APPROVALS | DATE

Schematic P/N and Name Hierarchical Design HSC12 | Approved | 2015-01-23

Size B | Bare PCB P/N 10 | Rev. B | Checked | 2015-01-23

Scale NTS | Date 1/22/2015 | Sheet 10 of 10 | Engineer | 2015-01-23

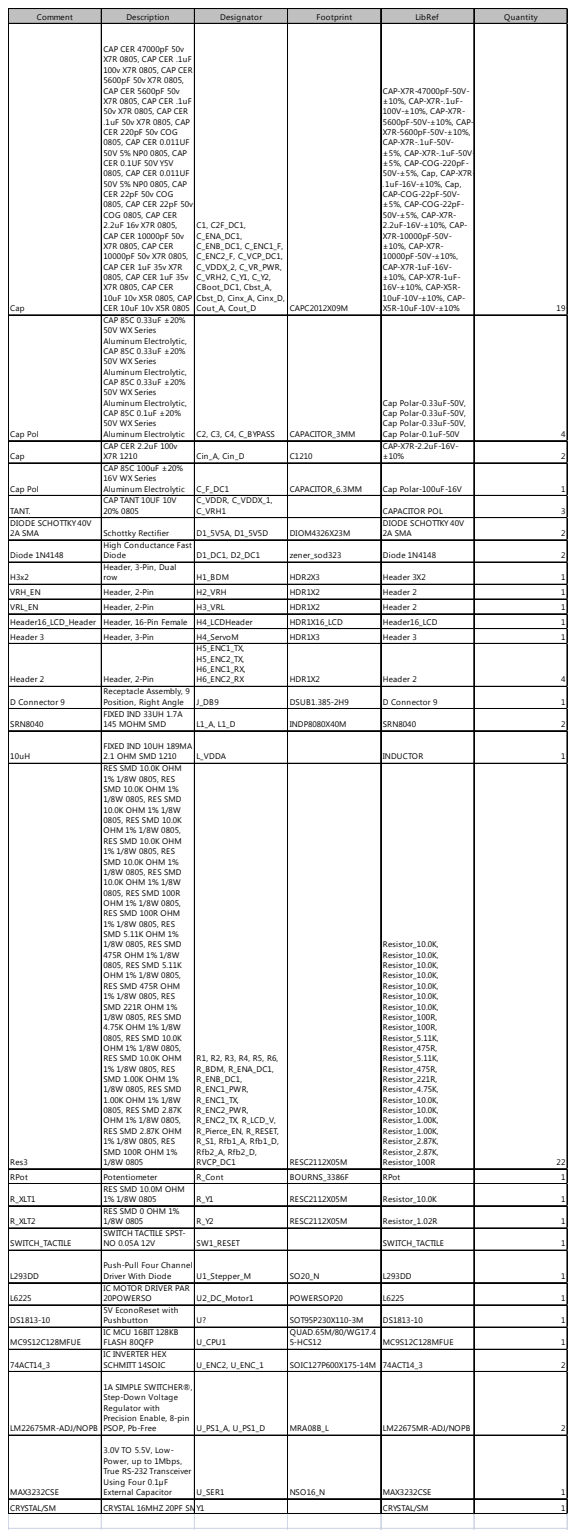
[picture p73: page 11]

Comment | Description | Designator | Footprint | LibRef | Quantity

Cap | CAP CER 47000pF 50v X7R 0805, CAP CER .1uF 100v X7R 0805, CAP CER 5600pF 50v X7R 0805, CAP CER 5600pF 50v X7R 0805, CAP CER .1uF 50v X7R 0805, CAP CER .1uF 50v X7R 0805, CAP CER 220pF 50v COG 0805, CAP CER 0.011UF 50V 5% NP0 0805, CAP CER 0.1UF 50V Y5V 0805, CAP CER 0.011UF 50V 5% NP0 0805, CAP CER 22pF 50v COG 0805, CAP CER 22pF 50v COG 0805, CAP CER 2.2uF 16v X7R 0805, CAP CER 10000pF 50v X7R 0805, CAP CER 10000pF 50v X7R 0805, CAP CER 1uF 35v X7R 0805, CAP CER 1uF 35v X7R 0805, CAP CER 10uF 10v X5R 0805, CAP CER 10uF 10v X5R 0805 | C1, C2F_DC1, C_ENA_DC1, C_ENB_DC1, C_ENC1_F, C_ENC2_F, C_VCP_DC1, C_VDDX_2, C_VR_PWR, C_VRH2, C_Y1, C_Y2, CBoot_DC1, Cbst_A, Cbst_D, Cinx_A, Cinx_D, Cout_A, Cout_D | CAPC2012X09M | CAP-X7R-47000pF-50V-±10%, CAP-X7R-.1uF-100V-±10%, CAP-X7R-5600pF-50V-±10%, CAP-X7R-5600pF-50V-±10%, CAP-X7R-.1uF-50V-±5%, CAP-X7R-.1uF-50V-±5%, CAP-COG-220pF-50V-±5%, Cap, CAP-X7R-.1uF-16V-±10%, Cap, CAP-COG-22pF-50V-±5%, CAP-COG-22pF-50V-±5%, CAP-X7R-2.2uF-16V-±10%, CAP-X7R-10000pF-50V-±10%, CAP-X7R-10000pF-50V-±10%, CAP-X7R-1uF-16V-±10%, CAP-X7R-1uF-16V-±10%, CAP-X5R-10uF-10V-±10%, CAP-X5R-10uF-10V-±10% | 19

Cap Pol | CAP 85C 0.33uF ±20% 50V WX Series Aluminum Electrolytic, CAP 85C 0.33uF ±20% 50V WX Series Aluminum Electrolytic, CAP 85C 0.33uF ±20% 50V WX Series Aluminum Electrolytic, CAP 85C 0.1uF ±20% 50V WX Series Aluminum Electrolytic | C2, C3, C4, C_BYPASS | CAPACITOR_3MM | Cap Polar-0.33uF-50V, Cap Polar-0.33uF-50V, Cap Polar-0.33uF-50V, Cap Polar-0.1uF-50V | 4

Cap | CAP CER 2.2uF 100v X7R 1210 | Cin_A, Cin_D | C1210 | CAP-X7R-2.2uF-16V-±10% | 2

Cap Pol | CAP 85C 100uF ±20% 16V WX Series Aluminum Electrolytic | C_F_DC1 | CAPACITOR_6.3MM | Cap Polar-100uF-16V | 1

TANT. | CAP TANT 10UF 10V 20% 0805 | C_VDDR, C_VDDX_1, C_VRH1 | | CAPACITOR POL | 3

DIODE SCHOTTKY 40V 2A SMA | Schottky Rectifier | D1_5V5A, D1_5V5D | DIOM4326X23M | DIODE SCHOTTKY 40V 2A SMA | 2

Diode 1N4148 | High Conductance Fast Diode | D1_DC1, D2_DC1 | zener_sod323 | Diode 1N4148 | 2

H3x2 | Header, 3-Pin, Dual row | H1_BDM | HDR2X3 | Header 3X2 | 1

VRH_EN | Header, 2-Pin | H2_VRH | HDR1X2 | Header 2 | 1

VRL_EN | Header, 2-Pin | H3_VRL | HDR1X2 | Header 2 | 1

Header16_LCD_Header | Header, 16-Pin Female | H4_LCDHeader | HDR1X16_LCD | Header16_LCD | 1

Header 3 | Header, 3-Pin | H4_ServoM | HDR1X3 | Header 3 | 1
Header 2 | Header, 2-Pin | H5_ENC1_TX, H5_ENC2_TX, H6_ENC1_RX, H6_ENC2_RX | HDR1X2 | Header 2 | 4

D Connector 9 | Receptacle Assembly, 9 Position, Right Angle | J_DB9 | DSUB1.385-2H9 | D Connector 9 | 1

SRN8040 | FIXED IND 33UH 1.7A 145 MOHM SMD | L1_A, L1_D | INDP8080X40M | SRN8040 | 2

10uH | FIXED IND 10UH 189MA 2.1 OHM SMD 1210 | L_VDDA | | INDUCTOR | 1

RPot | Potentiometer | R_Cont | BOURNS_3386F | RPot | 1
R_XLT1 | RES SMD 10.0M OHM 1% 1/8W 0805 | R_Y1 | RESC2112X05M | Resistor_10.0K | 1

R_XLT2 | RES SMD 0 OHM 1% 1/8W 0805 | R_Y2 | RESC2112X05M | Resistor_1.02R | 1

SWITCH_TACTILE | SWITCH TACTILE SPST-NO 0.05A 12V | SW1_RESET | | SWITCH_TACTILE | 1

L293DD | Push-Pull Four Channel Driver With Diode | U1_Stepper_M | SO20_N | L293DD | 1

L6225 | IC MOTOR DRIVER PAR 20POWERSO | U2_DC_Motor1 | POWERSOP20 | L6225 | 1

DS1813-10 | 5V EconoReset with Pushbutton | U? | SOT95P230X110-3M | DS1813-10 | 1

MC9S12C128MFUE | IC MCU 16BIT 128KB FLASH 80QFP | U_CPU1 | QUAD.65M/80/WG17.4 5-HCS12 | MC9S12C128MFUE | 1

74ACT14_3 | IC INVERTER HEX SCHMITT 14SOIC | U_ENC2, U_ENC_1 | SOIC127P600X175-14M | 74ACT14_3 | 2

LM22675MR-ADJ/NOPB | 1A SIMPLE SWITCHER®, Step-Down Voltage Regulator with Precision Enable, 8-pin PSOP, Pb-Free | U_PS1_A, U_PS1_D | MRA08B_L | LM22675MR-ADJ/NOPB | 2

MAX3232CSE | 3.0V TO 5.5V, Low-Power, up to 1Mbps, True RS-232 Transceiver Using Four 0.1µF External Capacitor | U_SER1 | NSO16_N | MAX3232CSE | 1

CRYSTAL/SM | CRYSTAL 16MHZ 20PF SMY1 | | | CRYSTAL/SM | 1
