CircuitBreaker437/HCS12_Robot/Schematic/Design_Rev_PDF/Jan30/Jan30Schematics.pdf

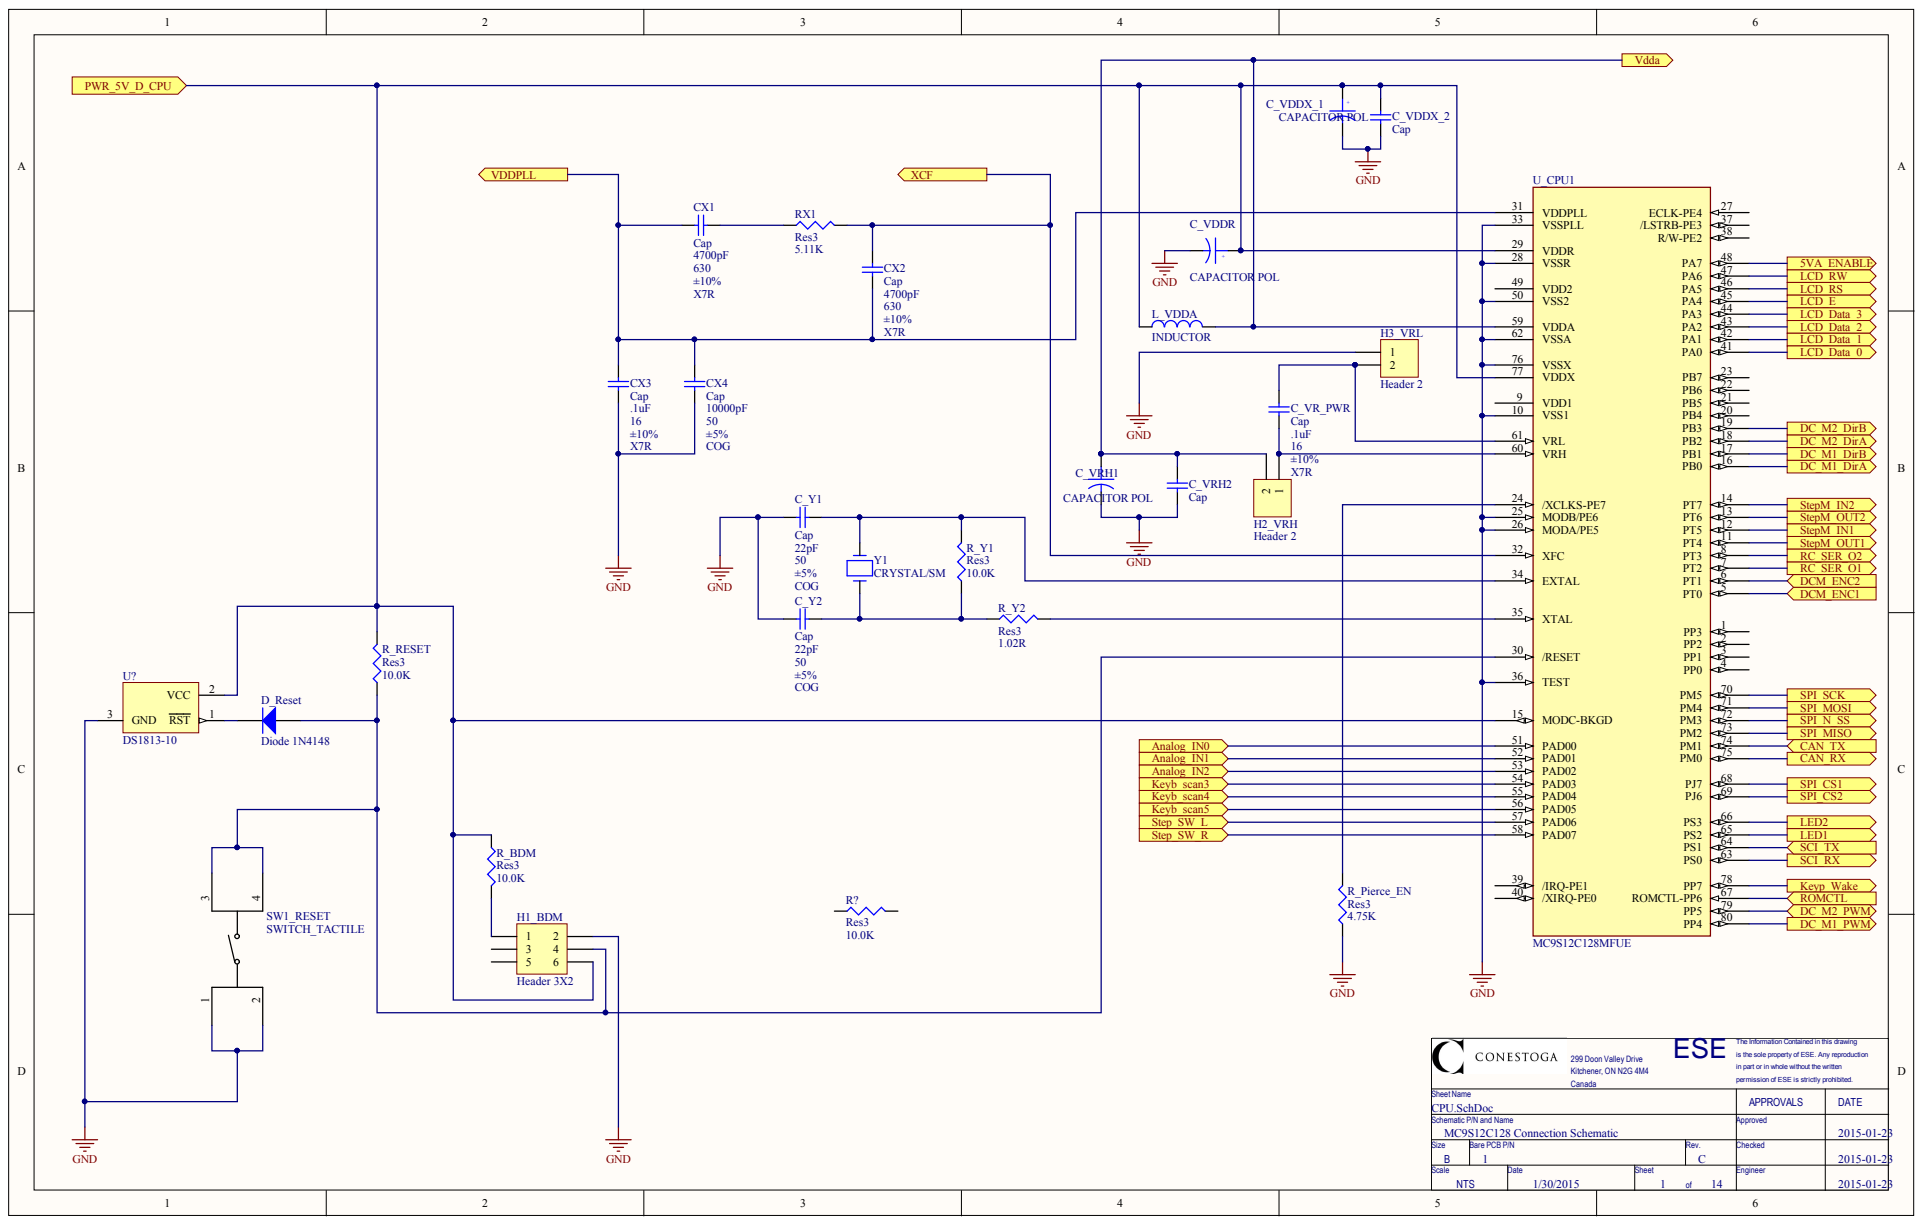
[picture p74: page 1]

VDDPLL 31

CX2 Cap 4700pF 630 ±10% X7R | | VSSPLL 33 VSSR 28 VDDR 29

VDD2 49

VDDA 59 VSSA 62

H3_VRL
1 | VSSX 76

VRH 60 VRL 61

/XCLKS-PE7 24
MODB/PE6 25

GND | | | EXTAL 34

XFC 32

XTAL 35 /RESET 30

R_RESET Res3 10.0K

TEST 36

PAD00 51 PAD01 52 PAD02 53 PAD03 54 PAD04 55 PAD05 56 PAD06 57 PAD07 58 /IRQ-PE1 39

R_BDM Res3 10.0K

ESE is the sole property of ESE. Any reproduction

The Information Contained in this drawing

in part or in whole without the written

permission of ESE is strictly prohibited.

Sheet Name CPU.SchDoc | APPROVALS | DATE

Schematic P/N and Name MC9S12C128 Connection Schematic | Approved | 2015-01-23

Size B | Bare PCB P/N 1 | Rev. C | Checked | 2015-01-23

Scale NTS | Date 1/30/2015 | Sheet 1 of 14 | Engineer | 2015-01-23


of ESE. Any re

S h e e t Na m e RS3232.SchDoc | A P P ROVA L S | D AT E

S c h e m a t i c P /N a n d Na m e Ser ial Connect ion U s ing RS3232 | A p pro v e d | 2015-01-16

S i z e B | B are PCB P / N 1 | Re v . A | Ch e c k e d | 2015-01-16

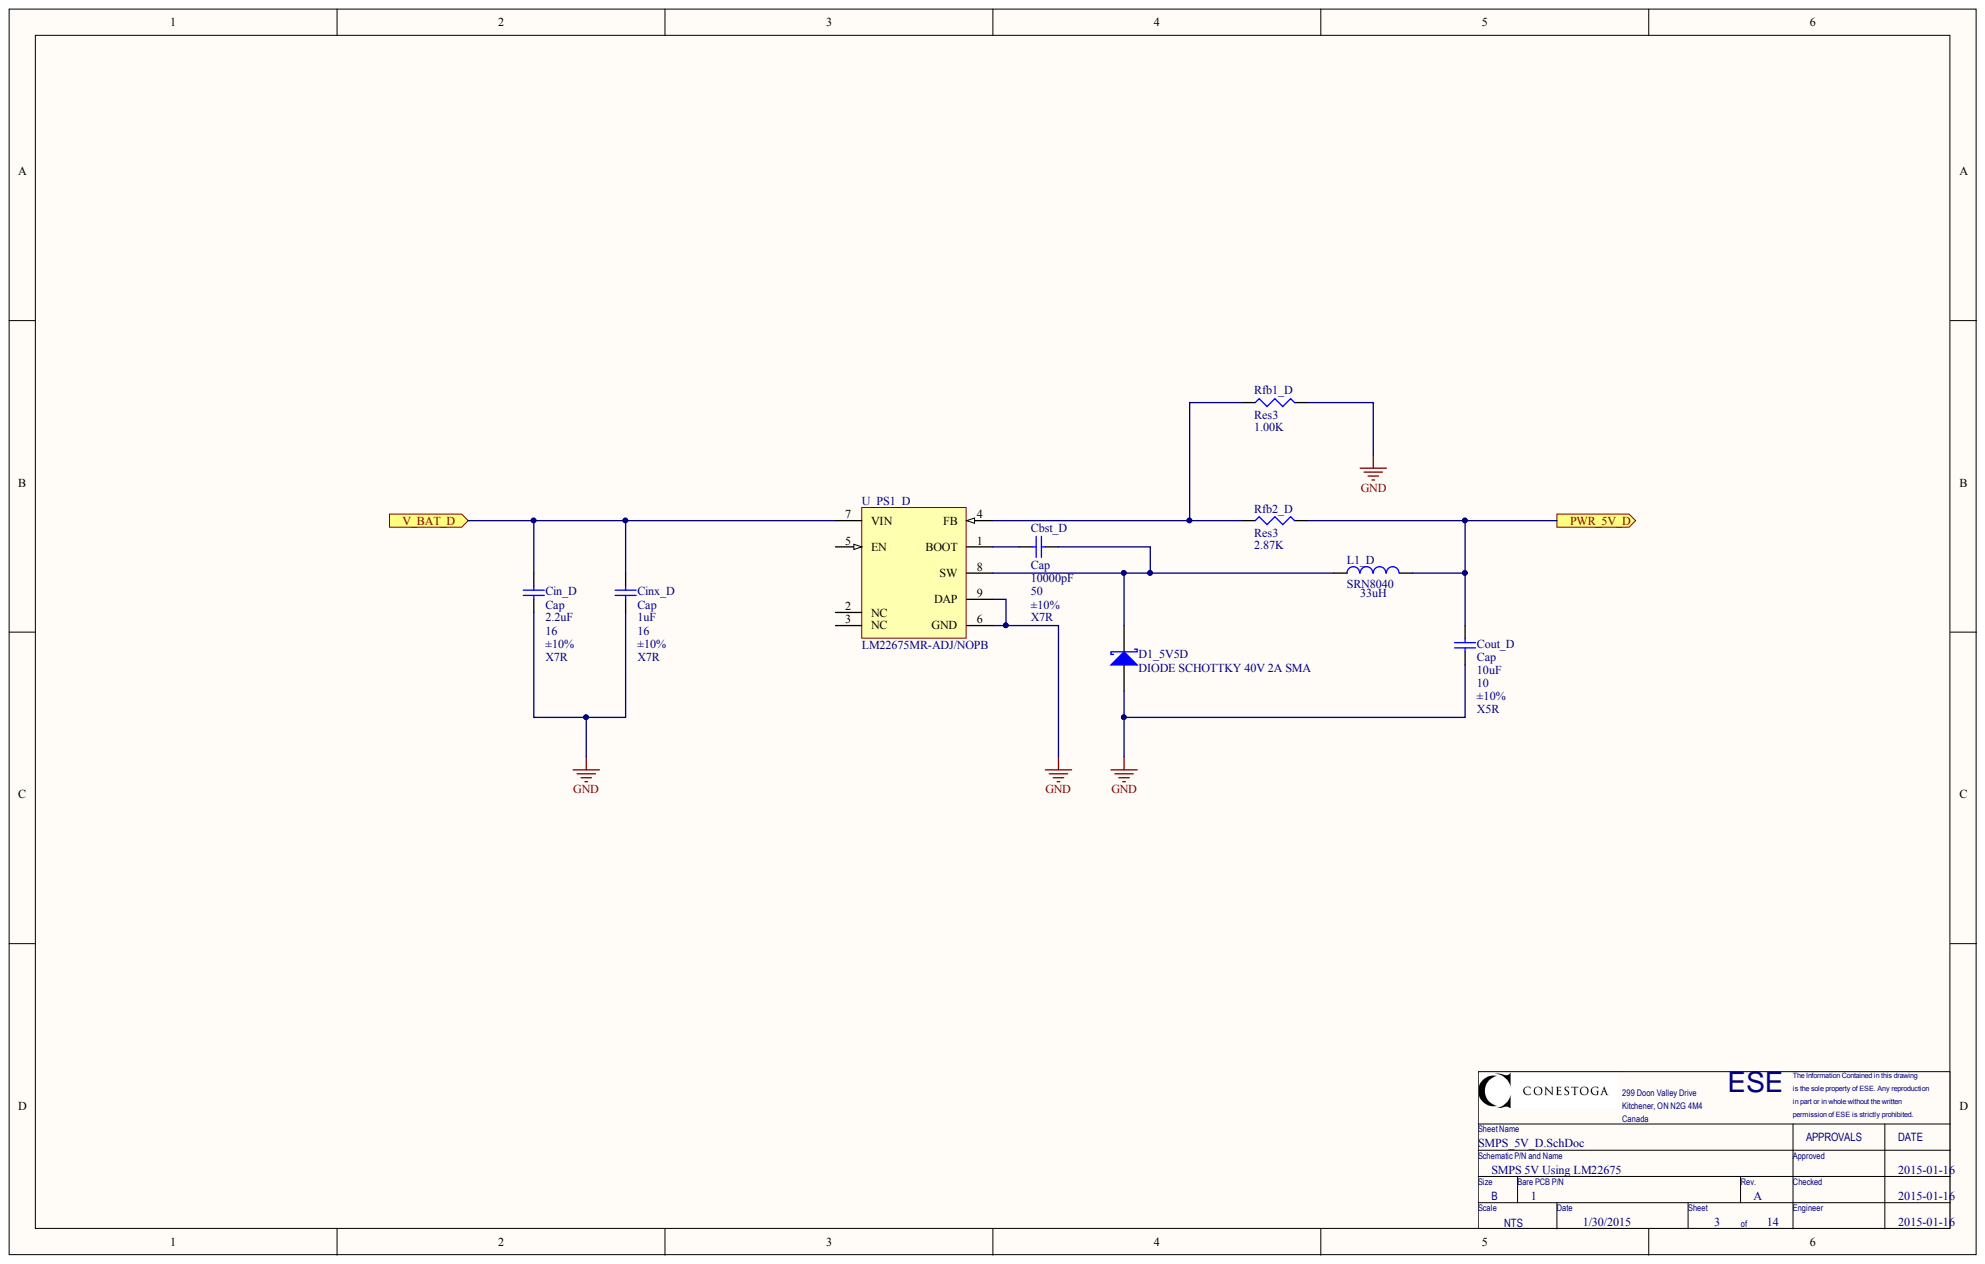
[picture p75: page 3]

of ESE. Any re

S h e e t Na m e SMPS_5V_D.SchDoc | A P P ROVA L S | D AT E

S c h e m a t i c P /N a n d Na m e SMPS 5V U s ing L M22675 | A p pro v e d | 2015-01-16

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

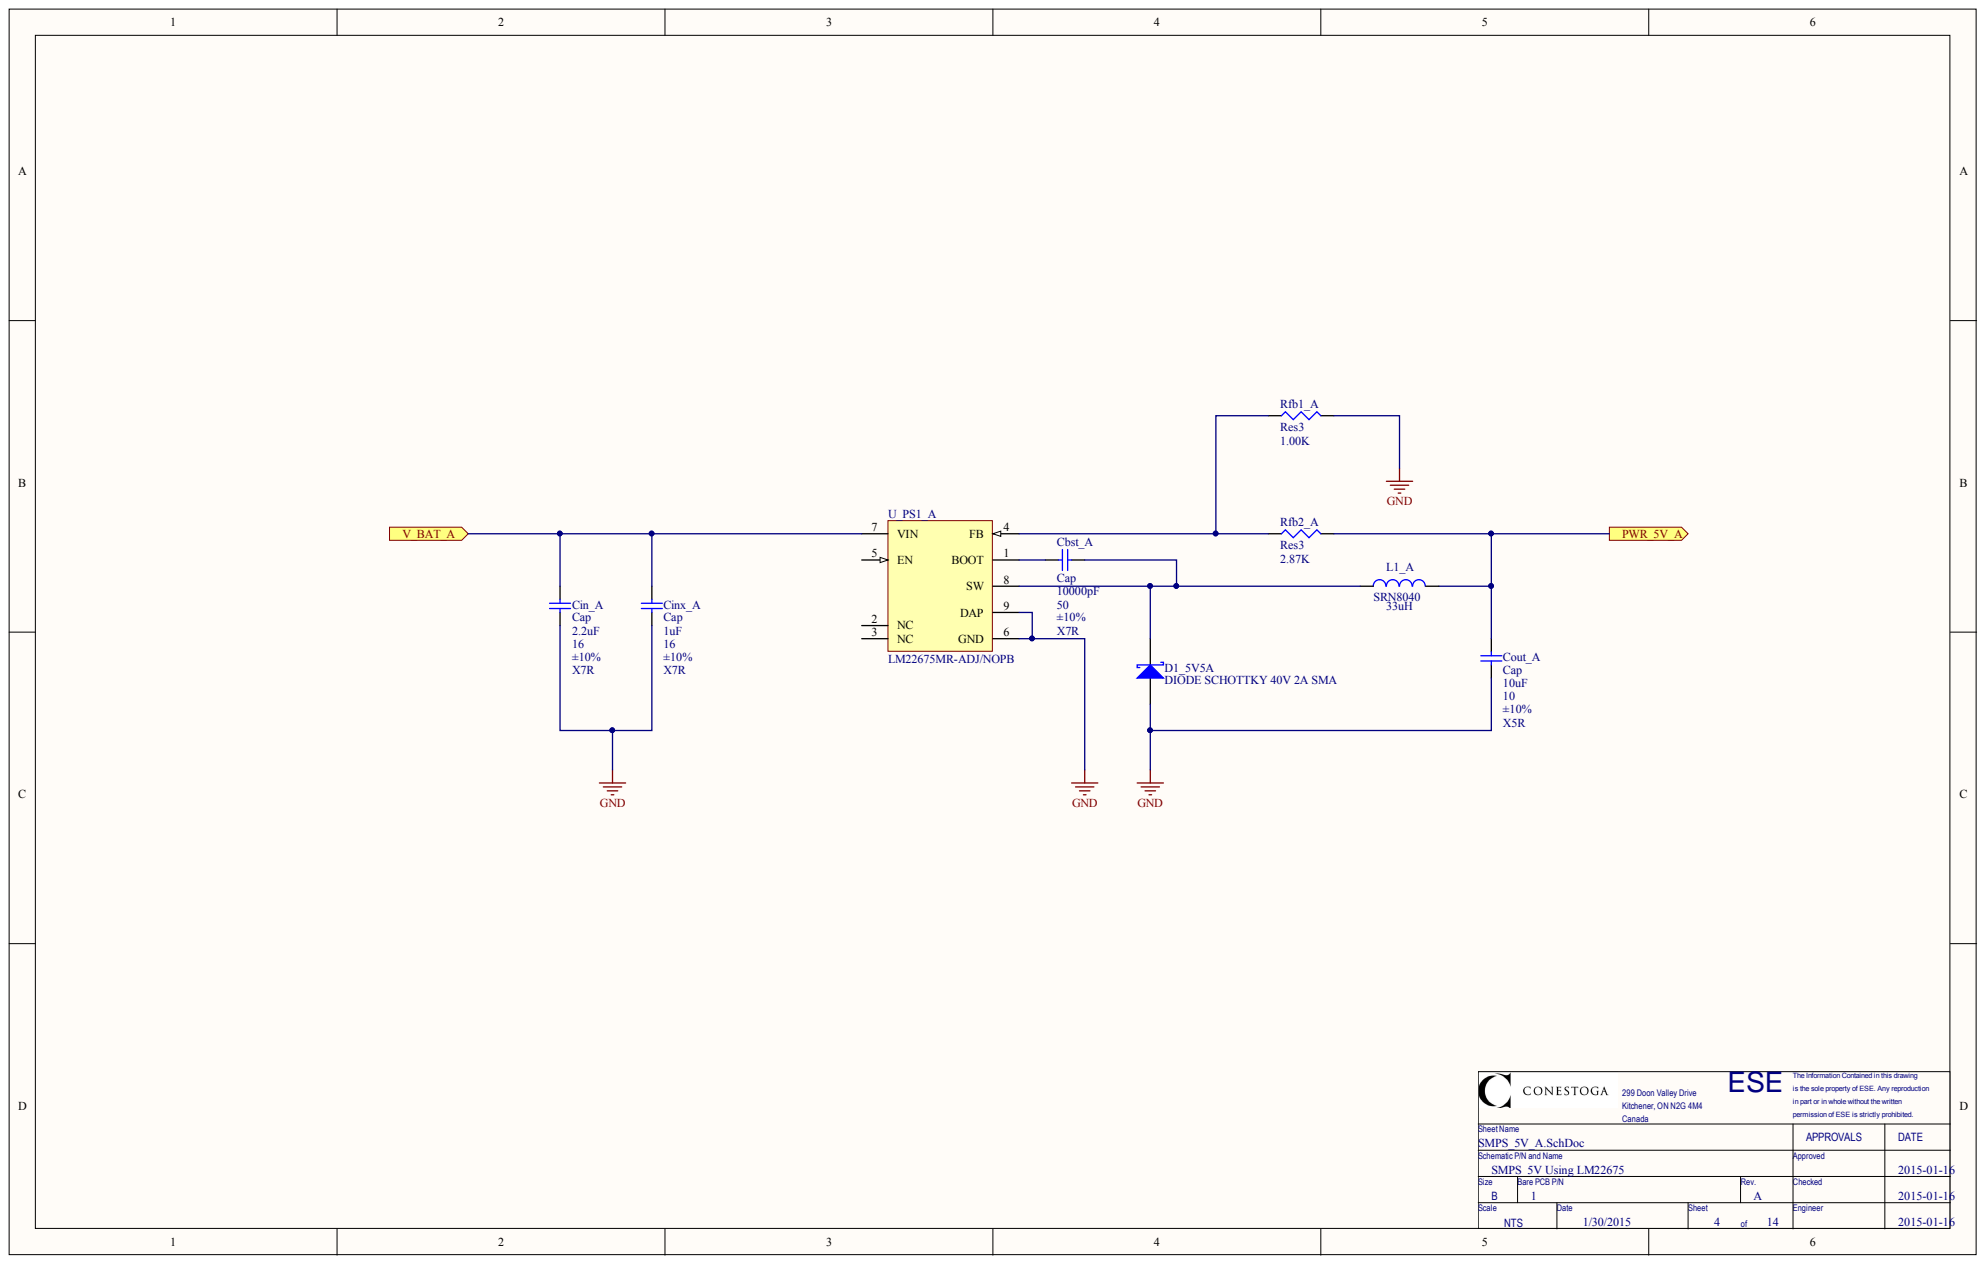
[picture p76: page 4]

of ESE. Any re

S h e e t Na m e SMPS_5V_A.SchDoc | A P P ROVA L S | D AT E

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


of ESE. Any re

S h e e t Na m e Stepper Motor1C T RL.SchDoc | A P P ROVA L S | D AT E

S c h e m a t i c P /N a n d Na m e Stepper Motor D r iver | A p pro v e d | 2015-01-23

S i z e B | B are PCB P / N 5 | Re v . A | Ch e c k e d | 2015-01-23


ESE is the sole property of ESE. Any reproduction

The Information Contained in this drawing

in part or in whole without the written

permission of ESE is strictly prohibited.

Sheet Name LCD_Header.SchDoc | APPROVALS | DATE

Schematic P/N and Name LCDDisplay | Approved | 2015-01-23

Size B | Bare PCB P/N 6 | Rev. A | Checked | 2015-01-23

Scale NTS | Date 1/30/2015 | Sheet 6 of 14 | Engineer | 2015-01-23


ESE is the sole property of ESE. Any reproduction

The Information Contained in this drawing

in part or in whole without the written

permission of ESE is strictly prohibited.

Sheet Name ServoMotCTRL.SchDoc | APPROVALS | DATE

Schematic P/N and Name Servo Motor Connection | Approved | 2015-01-23

Size B | Bare PCB P/N 8 | Rev. A | Checked | 2015-01-23

Scale NTS | Date 1/30/2015 | Sheet 7 of 14 | Engineer | 2015-01-23

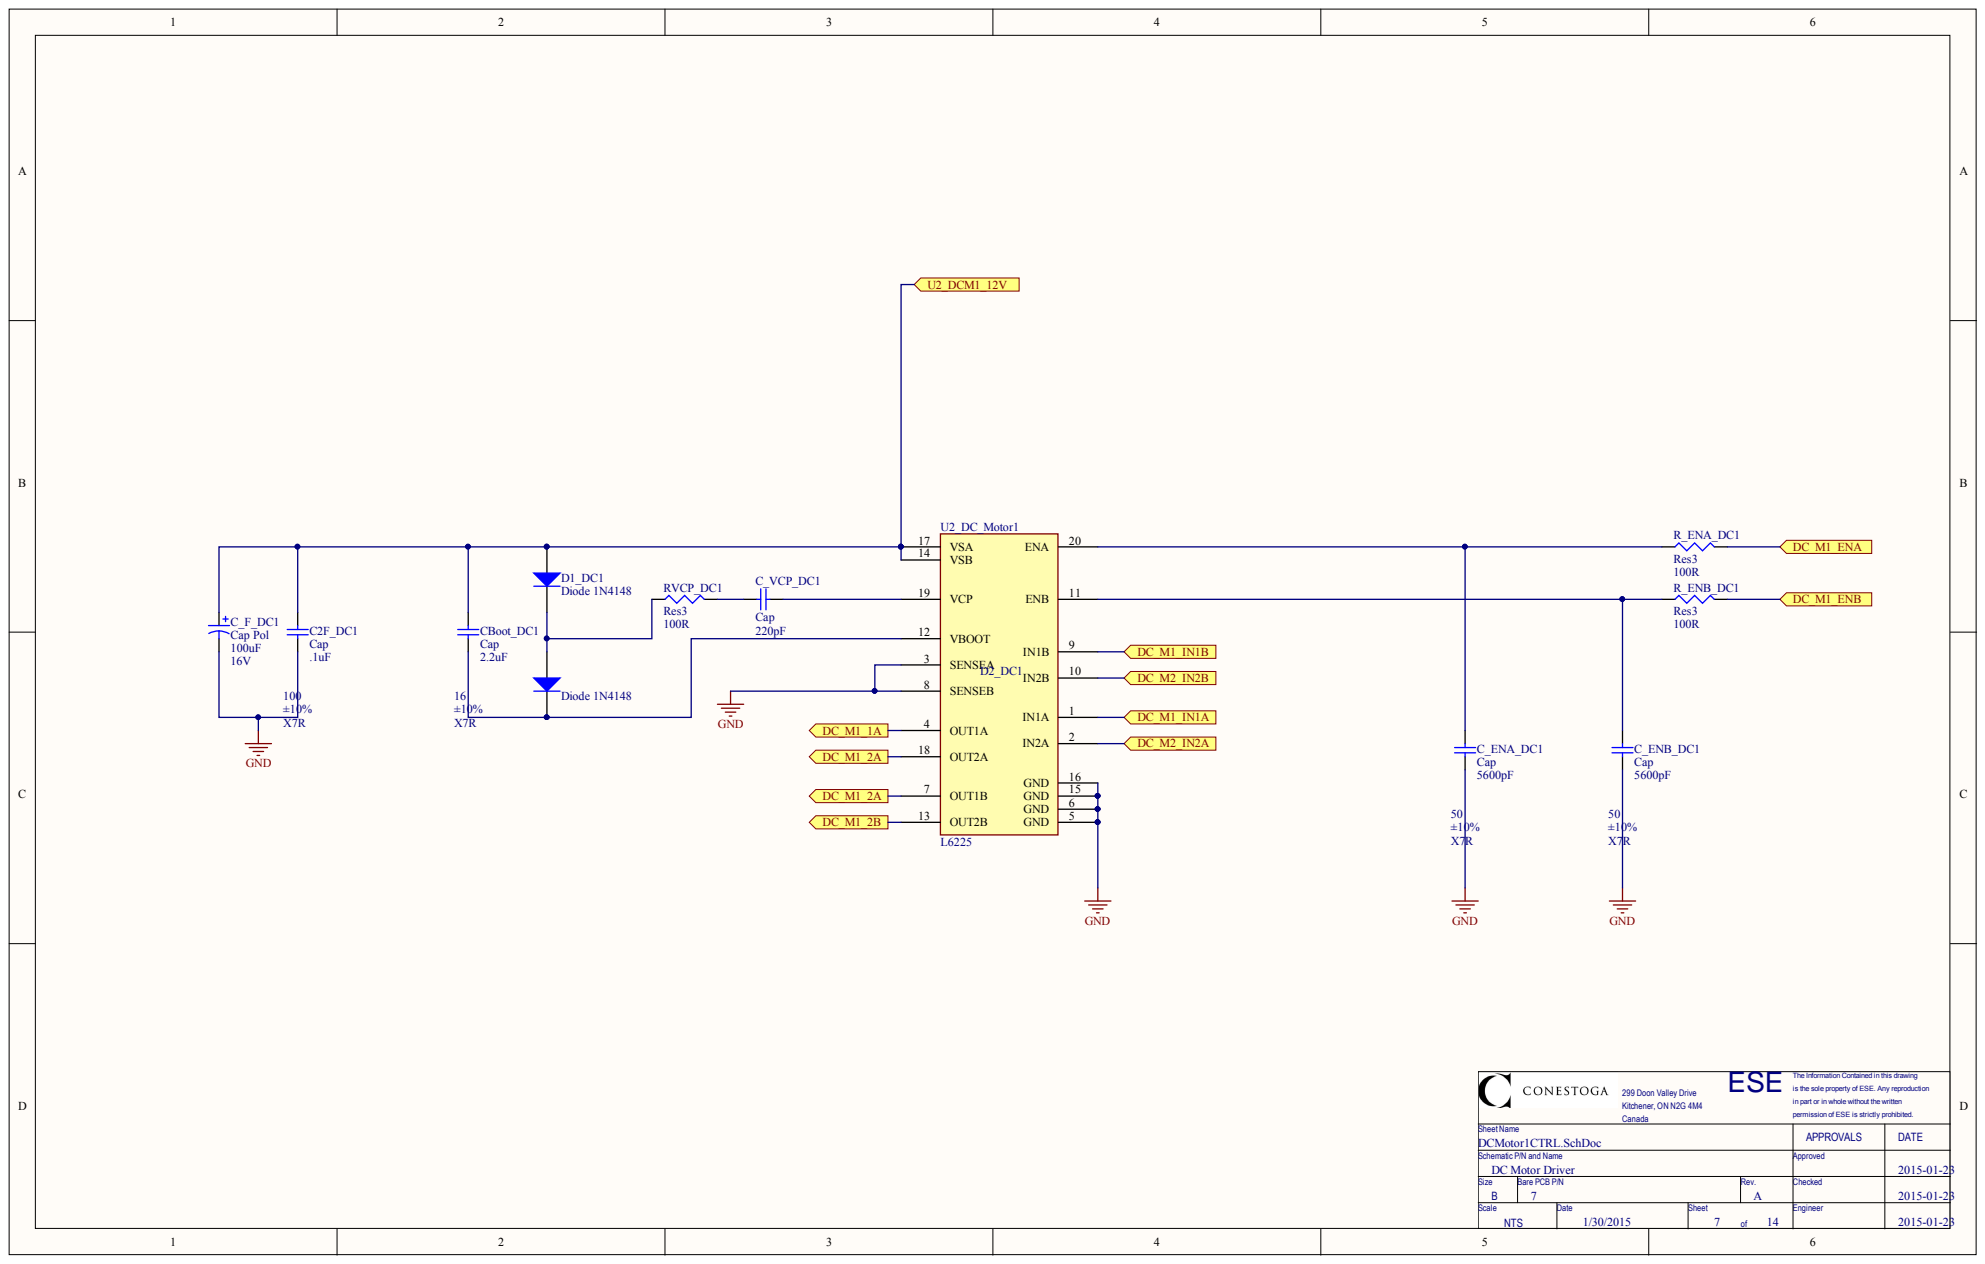
[picture p77: page 8]

ESE is the sole property of ESE. Any reproduction

The Information Contained in this drawing

in part or in whole without the written

permission of ESE is strictly prohibited.

Sheet Name DCMotor1CTRL.SchDoc | APPROVALS | DATE

Schematic P/N and Name DC Motor Driver | Approved | 2015-01-23

Size B | Bare PCB P/N 7 | Rev. A | Checked | 2015-01-23

Scale NTS | Date 1/30/2015 | Sheet 7 of 14 | Engineer | 2015-01-23


ESE is the sole property of ESE. Any reproduction

The Information Contained in this drawing

in part or in whole without the written

permission of ESE is strictly prohibited.

Sheet Name Encoder_DC_Mot.SchDoc | APPROVALS | DATE

Schematic P/N and Name DC Motor Speed Encoder | Approved | 2015-01-23

Size B | Bare PCB P/N 9 | Rev. B | Checked | 2015-01-23

Scale NTS | Date 1/30/2015 | Sheet 9 of 14 | Engineer | 2015-01-23


ESE is the sole property of ESE. Any reproduction

The Information Contained in this drawing

in part or in whole without the written

permission of ESE is strictly prohibited.

Sheet Name LVR_3V3_PS.SchDoc | APPROVALS | DATE

Schematic P/N and Name 3V3 Linear Voltage Regulator | Approved | 2015-01-30

Size B | Bare PCB P/N 1 | Rev. A | Checked | 2015-01-30

Scale NTS | Date 1/30/2015 | Sheet 10 of 14 | Engineer | 2015-01-30

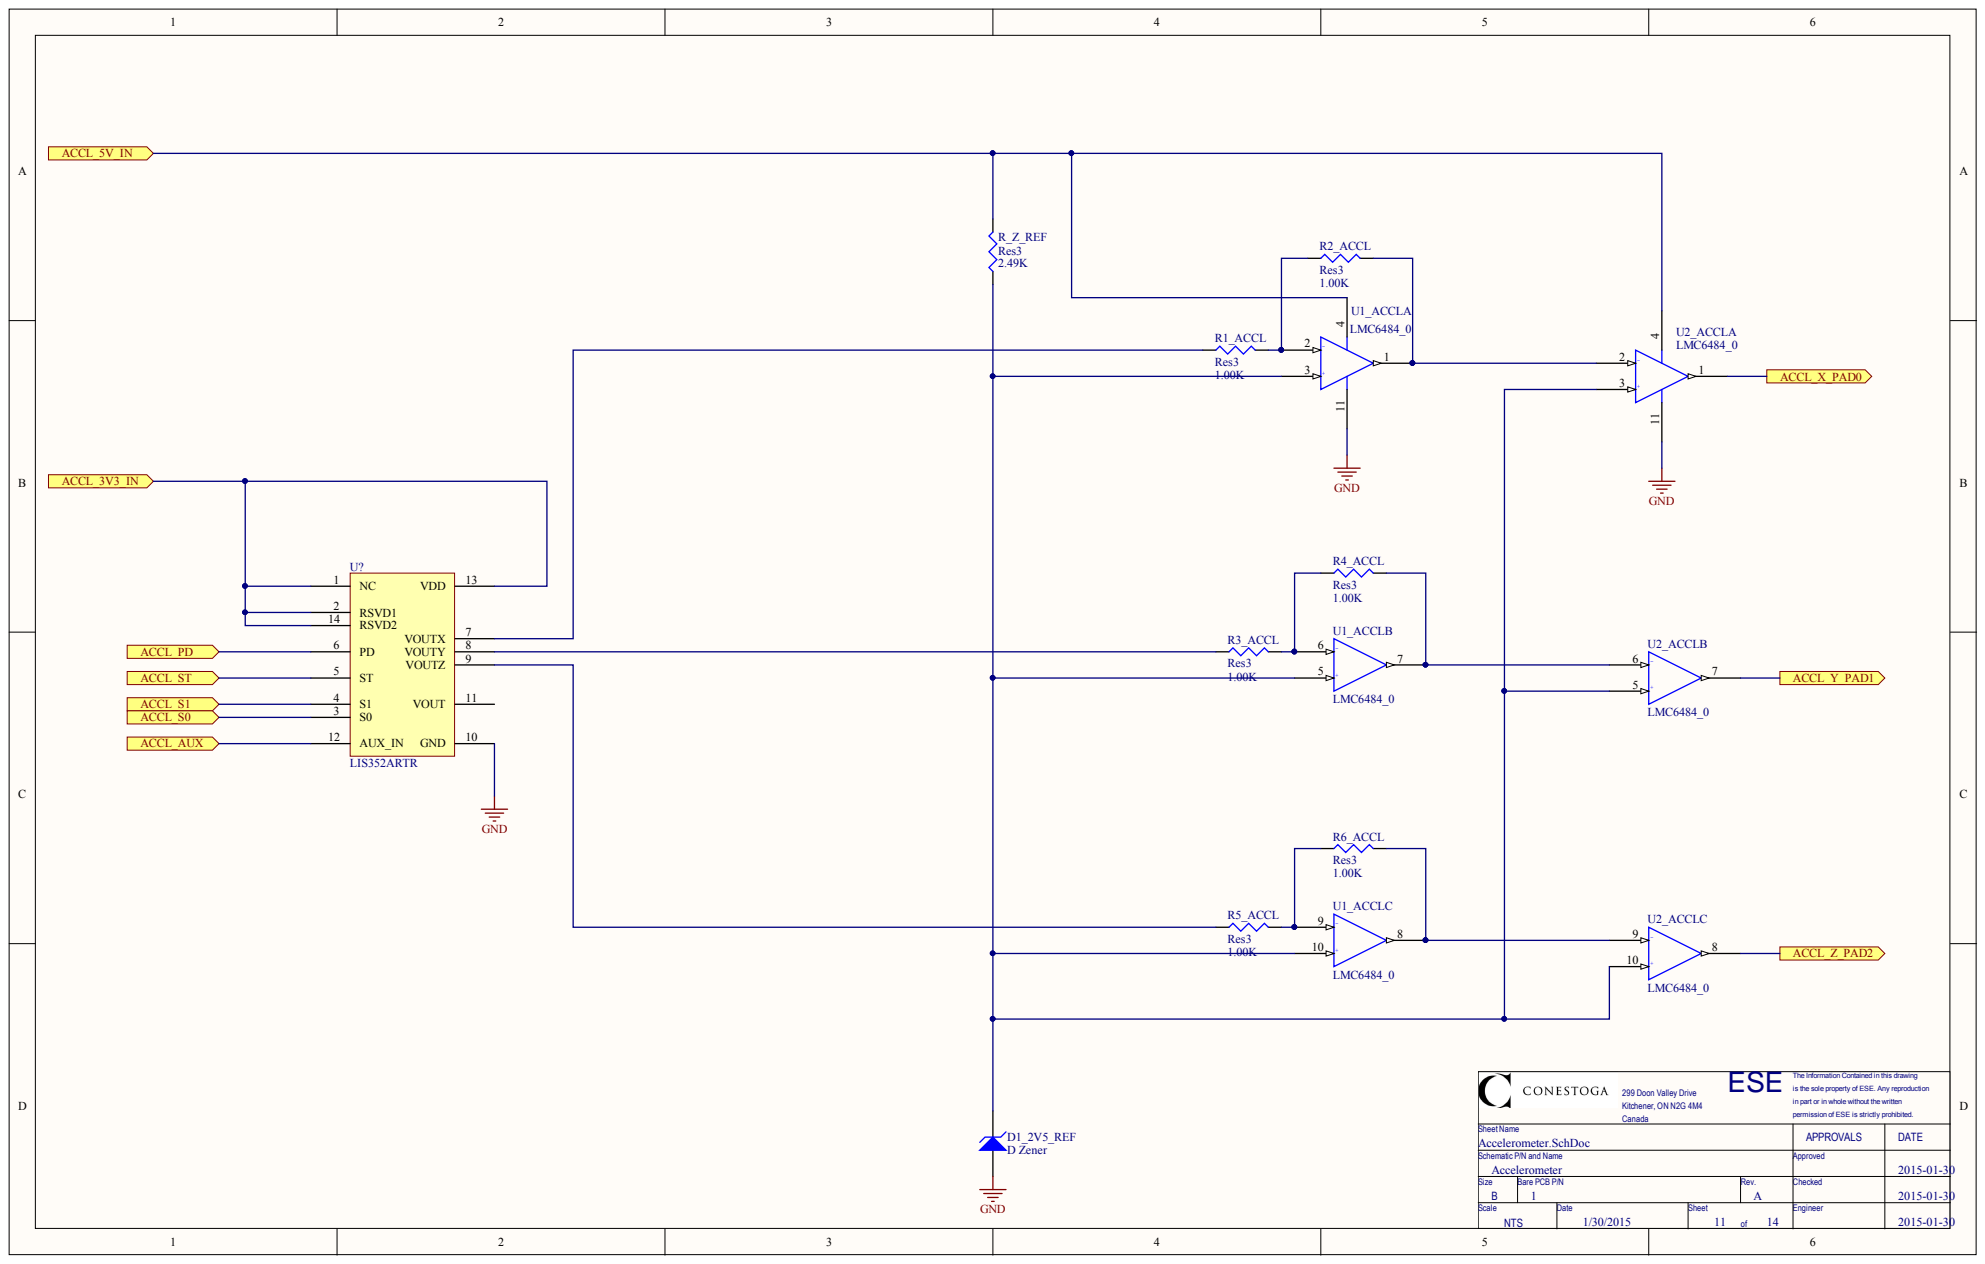
[picture p78: page 11]

ESE is the sole property of ESE. Any reproduction

The Information Contained in this drawing

in part or in whole without the written

permission of ESE is strictly prohibited.

Sheet Name Accelerometer.SchDoc | APPROVALS | DATE

Schematic P/N and Name Accelerometer | Approved | 2015-01-30

Size B | Bare PCB P/N 1 | Rev. A | Checked | 2015-01-30

Scale NTS | Date 1/30/2015 | Sheet 11 of 14 | Engineer | 2015-01-30


IC DAC 8BIT DUAL VOUT 8-UMAX

ESE is the sole property of ESE. Any reproduction

The Information Contained in this drawing

in part or in whole without the written

permission of ESE is strictly prohibited.

Sheet Name DAC.SchDoc | APPROVALS | DATE

Schematic P/N and Name DAC | Approved | 2015-01-30

Size B | Bare PCB P/N 1 | Rev. A | Checked | 2015-01-30

Scale NTS | Date 1/30/2015 | Sheet 12 of 14 | Engineer | 2015-01-30

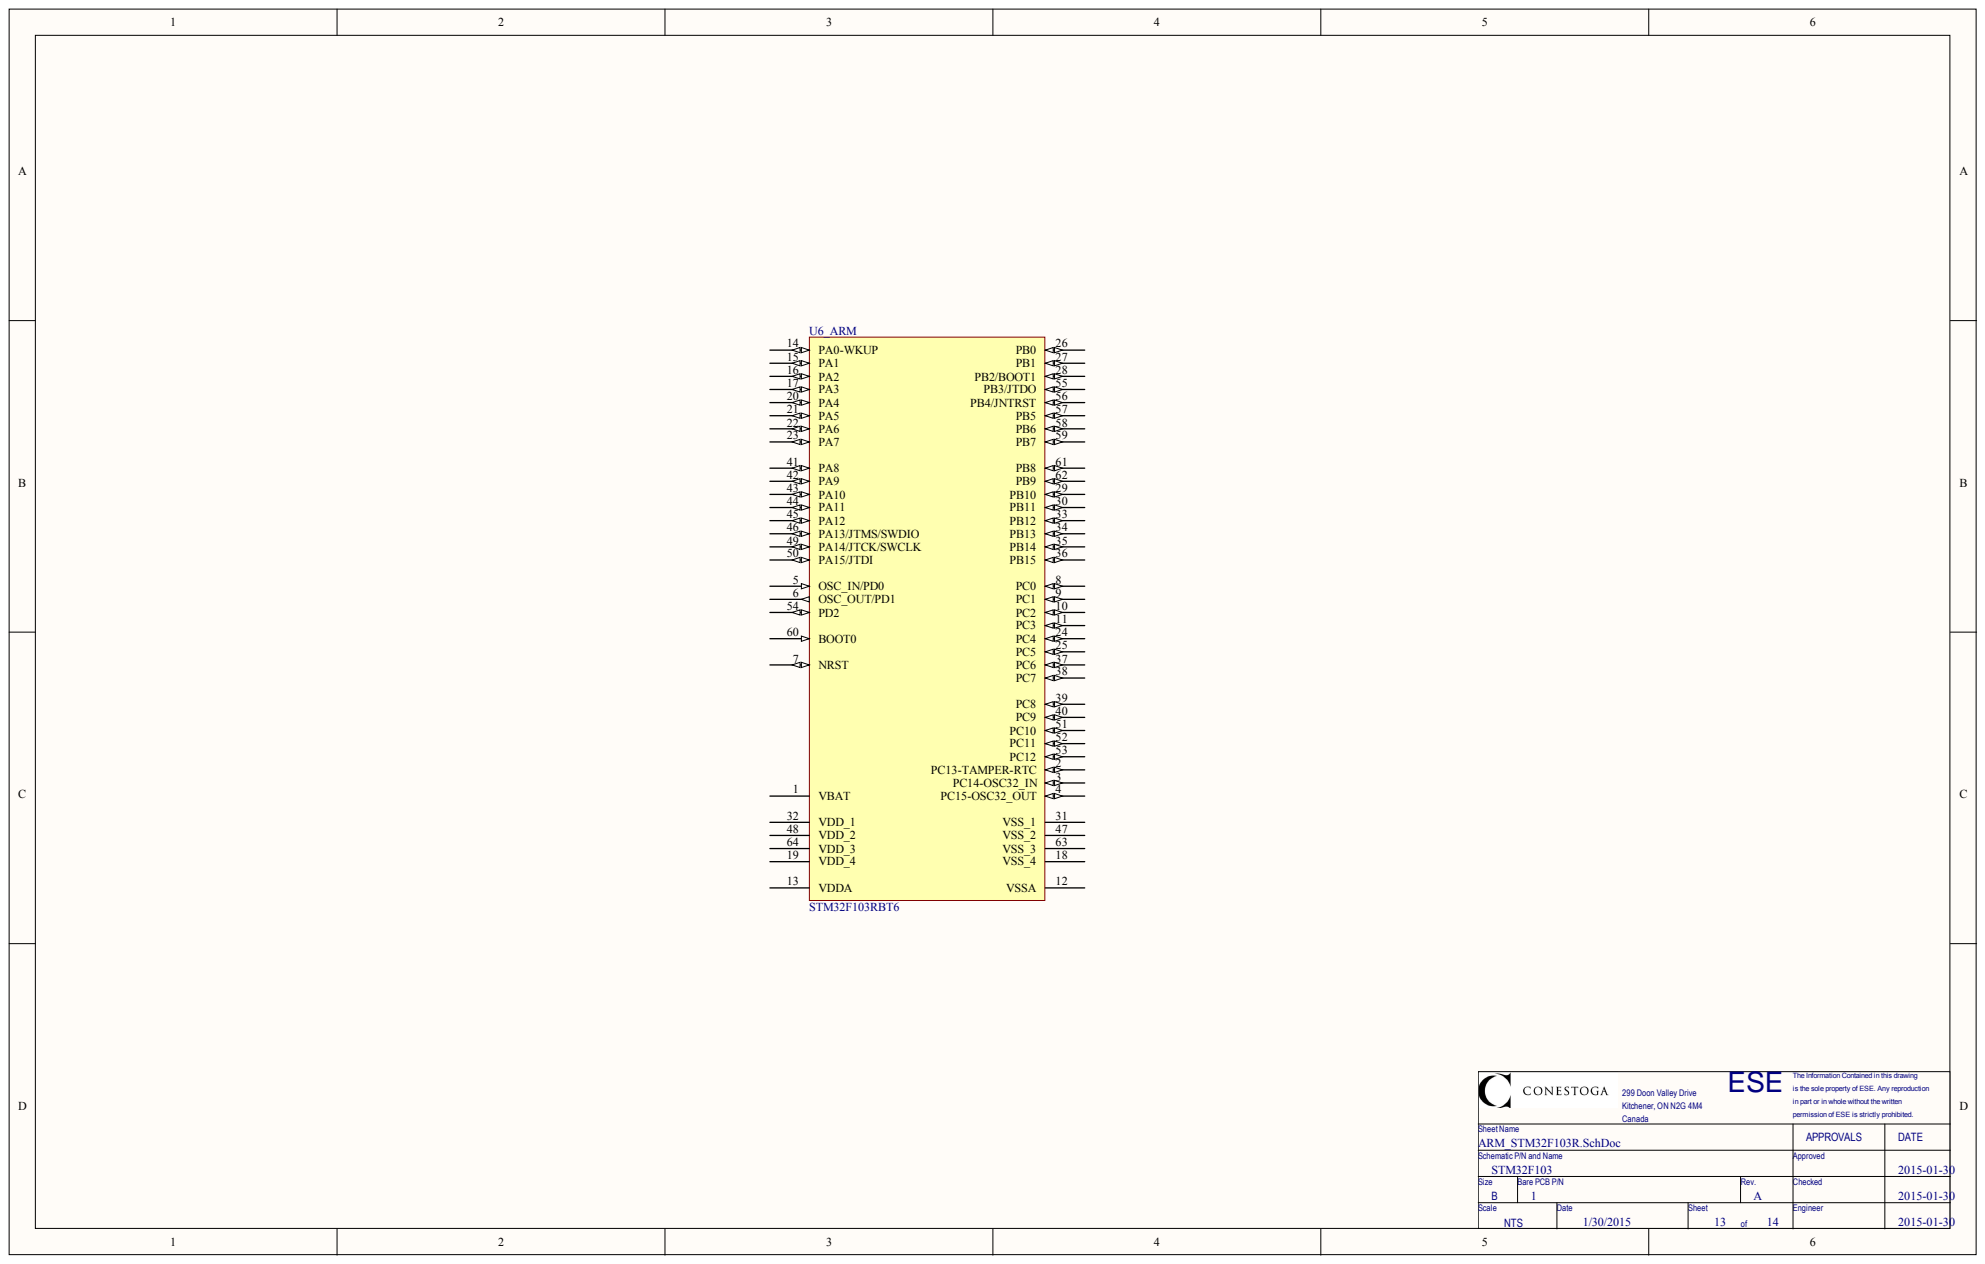
[picture p79: page 13]

ESE is the sole property of ESE. Any reproduction

The Information Contained in this drawing

in part or in whole without the written

permission of ESE is strictly prohibited.

Sheet Name ARM_STM32F103R.SchDoc | APPROVALS | DATE

Schematic P/N and Name STM32F103 | Approved | 2015-01-30

Size B | Bare PCB P/N 1 | Rev. A | Checked | 2015-01-30

Scale NTS | Date 1/30/2015 | Sheet 13 of 14 | Engineer | 2015-01-30

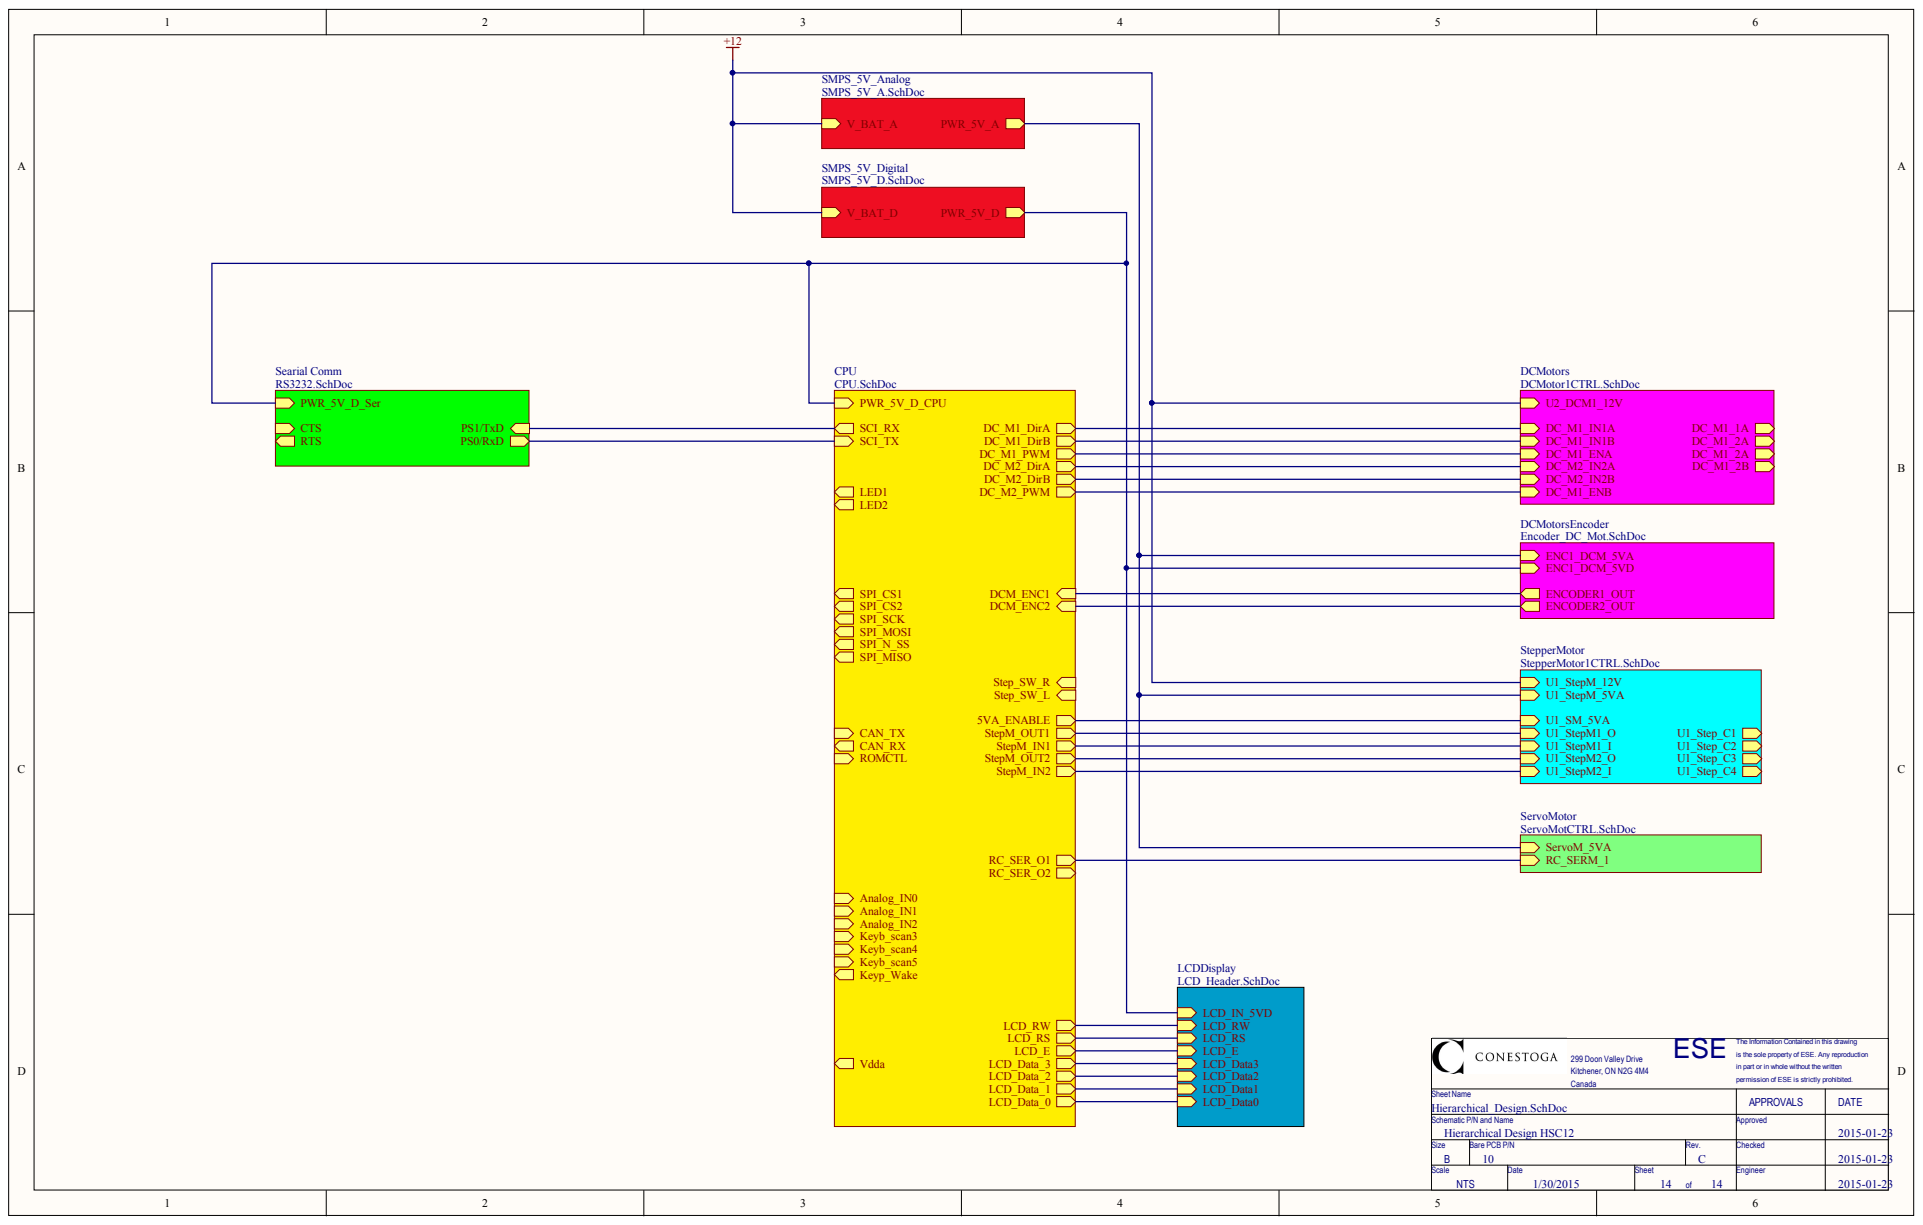
[picture p80: page 14]

ESE is the sole property of ESE. Any reproduction

The Information Contained in this drawing

in part or in whole without the written

permission of ESE is strictly prohibited.

Sheet Name Hierarchical_Design.SchDoc | APPROVALS | DATE

Schematic P/N and Name Hierarchical Design HSC12 | Approved | 2015-01-23

Size B | Bare PCB P/N 10 | Rev. C | Checked | 2015-01-23

Scale NTS | Date 1/30/2015 | Sheet 14 of 14 | Engineer | 2015-01-23
