CircuitBreaker437/HCS12_Robot/(list of files, drawings)

Other design files:
PCB/Accelerometer.SchDoc
PCB/ADC.SchDoc
PCB/ARM_STM32F103R.SchDoc
PCB/BAT54C.SchLib
PCB/CAN.SchDoc
PCB/CPU.SchDoc
PCB/DAC.SchDoc
PCB/DCMotor1CTRL.SchDoc
PCB/DCMotor2CTRL.SchDoc
PCB/DCMotorCTRL.SchDoc
PCB/Diode BAT54C.SchLib
PCB/Encoder_DC_Mot.SchDoc
PCB/Hierarchical_Design.SchDoc
PCB/L293DD.SchDoc
PCB/L6225_MotorDriver_.SchDoc
PCB/LCD_Header.SchDoc
PCB/LPS_3V3.SchDoc
PCB/LVR_3V3_PS.SchDoc
PCB/PCB.PrjPcb
PCB/RS3232.SchDoc
PCB/ServoMotCTRL.SchDoc
PCB/SMPS_3V3.SchDoc
PCB/SMPS_5V.SchDoc
PCB/SMPS_5V_A.SchDoc
PCB/SMPS_5V_D.SchDoc
PCB/StepperMotor1CTRL.SchDoc
PCB/StepperMotorCTRL.SchDoc
